richardb1998/MARIEPC/PartsList/ALU.csv

Qty | Value | Device | Package | Parts | Description | DESCRIPTION | HEIGHT | MANUFACTURER_NAME | MANUFACTURER_PART_NUMBER | MOUSER_PART_NUMBER | MOUSER_PRICE-STOCK | POPULARITY | SPICEPREFIX
4 |  | C-US025-024X044 | C025-024X044 | C1, C2, C3, C4 | CAPACITOR, American symbol |  |  |  |  |  |  | 17 | C
16 | 220 | R-US_0204/7 | 0204/7 | R0, R1, R2, R3, R4, R5, R6, R7, R8, R9, R10, R11, R12, R13, R14, R16 | RESISTOR, American symbol |  |  |  |  |  |  | 48 | R
2 | 55959-1630 | 55959-1630 | SHDR16W65P250X200_2X8_1940X140 | ACCUMULATOR_CONNECTOR, MBR_CONNECTOR | Molex MICROCLASP Series, Series Number 55959, 2mm Pitch 16 Way 2 Row Right Angle PCB Header, Solder Termination, 3A | Molex MICROCLASP Series, Series Number 55959, 2mm Pitch 16 Way 2 Row Right Angle PCB Header, Solder Termination, 3A | 11.7mm | Molex | 55959-1630 | 538-55959-1630 | https://www.mouser.com/Search/Refine.aspx?Keyword=538-55959-1630
1 | 55959-2030 | 55959-2030 | 55959-2030_1 | BUS_CONNECTOR | Molex MICROCLASP Series, Series Number 56134, 2mm Pitch 20 Way 2 Row Right Angle PCB Header, Solder Termination, 3A | Molex MICROCLASP Series, Series Number 56134, 2mm Pitch 20 Way 2 Row Right Angle PCB Header, Solder Termination, 3A | mm | Molex | 55959-2030 | 538-55959-2030 | https://www.mouser.com/Search/Refine.aspx?Keyword=538-55959-2030
16 | RED | LED3MM | LED3MM | LED0, LED1, LED2, LED3, LED4, LED5, LED6, LED7, LED8, LED9, LED10, LED11, LED12, LED13, LED14, LED15 | LED |  |  |  |  |  |  | 97
4 | SN74F283N | SN74F283N | DIP254P762X508-16 | ADDER_0-3, ADDER_4-7, ADDER_8-11, ADDER_12-15 | 4 BIT BINARY FULL ADDERS WITH FAST CARRY | 4 BIT BINARY FULL ADDERS WITH FAST CARRY | mm | Texas Instruments | SN74F283N | 595-SN74F283N | https://www.mouser.com/Search/Refine.aspx?Keyword=595-SN74F283N
2 | SN74HC541N | SN74HC541N | DIP794W53P254L2540H508Q20N | BUFFER_0-7, BUFFER_8-15 | Octal Buffers And Line Drivers With 3-State Outputs | Octal Buffers And Line Drivers With 3-State Outputs | 5.08mm | Texas Instruments | SN74HC541N | 595-SN74HC541N | https://www.mouser.com/Search/Refine.aspx?Keyword=595-SN74HC541N
4 | SN74HC86N | SN74HC86N | DIP794W53P254L1930H508Q14N | XOR_0-3, XOR_4-7, XOR_8-11, XOR_12-15 | QUADRUPLE 2-INPUT EXCLUSIVE-OR GATES | QUADRUPLE 2-INPUT EXCLUSIVE-OR GATES | 5.08mm | Texas Instruments | SN74HC86N | 595-SN74HC86N | https://www.mouser.com/Search/Refine.aspx?Keyword=595-SN74HC86N
