richardb1998/MARIEPC/PartsList/billofmats.xlsx

Sheet: Sheet1
Qty | Value | Device | Package | Parts | Description | DESCRIPTION | HEIGHT | MANUFACTURER_NAME | MANUFACTURER_PART_NUMBER | MOUSER_PART_NUMBER | MOUSER_PRICE-STOCK | POPULARITY | SPICEPREFIX
4 |  | C-US025-024X044 | C025-024X044 | C1, C2, C3, C4 | CAPACITOR, American symbol |  |  |  |  |  |  | 17 | C
19 | 220 | R-US_0204/7 | 0204/7 | R0, R1, R2, R3, R4, R5, R6, R7, R8, R9, R10, R11, R12, R13, R14, R15, RSC_000, RSC_400, RSC_800 | RESISTOR, American symbol |  |  |  |  |  |  | 48 | R
1 | 55959-1630 | 55959-1630 | SHDR16W65P250X200_2X8_1940X140 | ALU | Molex MICROCLASP Series, Series Number 55959, 2mm Pitch 16 Way 2 Row Right Angle PCB Header, Solder Termination, 3A | Molex MICROCLASP Series, Series Number 55959, 2mm Pitch 16 Way 2 Row Right Angle PCB Header, Solder Termination, 3A | 11.7mm | Molex | 55959-1630 | 538-55959-1630 | https://www.mouser.com/Search/Refine.aspx?Keyword=538-55959-1630
1 | 55959-2430 | 55959-2430 | 559592430 | BUS | Headers & Wire Housings 24 Ckt R.A. Header | Headers & Wire Housings 24 Ckt R.A. Header | 11.95mm | Molex | 55959-2430 | 538-55959-2430 | https://www.mouser.com/Search/Refine.aspx?Keyword=538-55959-2430
2 | CD4048BE | CD4048BE | DIP254P762X508-16 | ACC=0_0-7, ACC=0_8-15 | CMOS multifunction expandable 8-input gate | CMOS multifunction expandable 8-input gate | mm | Texas Instruments | CD4048BE | 595-CD4048BE | https://www.mouser.com/Search/Refine.aspx?Keyword=595-CD4048BE
16 | RED | LED3MM | LED3MM | LED0, LED1, LED2, LED3, LED4, LED5, LED6, LED7, LED8, LED9, LED10, LED11, LED12, LED13, LED14, LED15 | LED |  |  |  |  |  |  | 97
2 | SN74BCT374N | SN74BCT374N | DIP254P762X508-20 | ACCUMULATOR_0-7, ACCUMULATOR_8-15 | OCTAL EDGE TRIGGERED D TYPE LATCHES | OCTAL EDGE TRIGGERED D TYPE LATCHES | mm | Texas Instruments | SN74BCT374N | 595-SN74BCT374N | https://www.mouser.com/Search/Refine.aspx?Keyword=595-SN74BCT374N
1 | SN74HC04N | SN74HC04N | DIP794W53P254L1930H508Q14N | NOT_GATE | Hex inverter,SN74HC04N DIP14 2.6V 25pcs | Hex inverter,SN74HC04N DIP14 2.6V 25pcs | 5.08mm | Texas Instruments | SN74HC04N | 595-SN74HC04N | https://www.mouser.com/Search/Refine.aspx?Keyword=595-SN74HC04N
1 | SN74HC08N | SN74HC08N | DIP794W53P254L1930H508Q14N | AND_GATE | QUADRUPLE 2-INPUT POSITIVE-NOR GATES | QUADRUPLE 2-INPUT POSITIVE-NOR GATES | 5.08mm | Texas Instruments | SN74HC08N | 595-SN74HC08N | https://www.mouser.com/Search/Refine.aspx?Keyword=595-SN74HC08N
1 | SN74HC11N | SN74HC11N | DIP794W53P254L1930H508Q14N | TRIPLE_AND_GATE | Triple 3-Input AND Gate SN74HC11N | Triple 3-Input AND Gate SN74HC11N | 5.08mm | Texas Instruments | SN74HC11N | 595-SN74HC11N | https://www.mouser.com/Search/Refine.aspx?Keyword=595-SN74HC11N
1 | SN74HC32N | SN74HC32N | DIP794W53P254L1930H508Q14N | OR_GATE | QUADRUPLE 2-INPUT POSITIVE-OR GATES | QUADRUPLE 2-INPUT POSITIVE-OR GATES | 5.08mm | Texas Instruments | SN74HC32N | 595-SN74HC32N | https://www.mouser.com/Search/Refine.aspx?Keyword=595-SN74HC32N
3 | SN74HC541N | SN74HC541N | DIP794W53P254L2540H508Q20N | ACO_0-7, ACO_8-15, SKIPCOND | Octal Buffers And Line Drivers With 3-State Outputs | Octal Buffers And Line Drivers With 3-State Outputs | 5.08mm | Texas Instruments | SN74HC541N | 595-SN74HC541N | https://www.mouser.com/Search/Refine.aspx?Keyword=595-SN74HC541N
3 | YELLOW | LED3MM | LED3MM | SC_000, SC_400, SC_800 | LED |  |  |  |  |  |  | 97
4 |  | C-US025-024X044 | C025-024X044 | C1, C2, C3, C4 | CAPACITOR, American symbol |  |  |  |  |  |  | 17 | C
16 | 220 | R-US_0204/7 | 0204/7 | R0, R1, R2, R3, R4, R5, R6, R7, R8, R9, R10, R11, R12, R13, R14, R16 | RESISTOR, American symbol |  |  |  |  |  |  | 48 | R
2 | 55959-1630 | 55959-1630 | SHDR16W65P250X200_2X8_1940X140 | ACCUMULATOR_CONNECTOR, MBR_CONNECTOR | Molex MICROCLASP Series, Series Number 55959, 2mm Pitch 16 Way 2 Row Right Angle PCB Header, Solder Termination, 3A | Molex MICROCLASP Series, Series Number 55959, 2mm Pitch 16 Way 2 Row Right Angle PCB Header, Solder Termination, 3A | 11.7mm | Molex | 55959-1630 | 538-55959-1630 | https://www.mouser.com/Search/Refine.aspx?Keyword=538-55959-1630
1 | 55959-2030 | 55959-2030 | 55959-2030_1 | BUS_CONNECTOR | Molex MICROCLASP Series, Series Number 56134, 2mm Pitch 20 Way 2 Row Right Angle PCB Header, Solder Termination, 3A | Molex MICROCLASP Series, Series Number 56134, 2mm Pitch 20 Way 2 Row Right Angle PCB Header, Solder Termination, 3A | mm | Molex | 55959-2030 | 538-55959-2030 | https://www.mouser.com/Search/Refine.aspx?Keyword=538-55959-2030
16 | RED | LED3MM | LED3MM | LED0, LED1, LED2, LED3, LED4, LED5, LED6, LED7, LED8, LED9, LED10, LED11, LED12, LED13, LED14, LED15 | LED |  |  |  |  |  |  | 97
4 | SN74F283N | SN74F283N | DIP254P762X508-16 | ADDER_0-3, ADDER_4-7, ADDER_8-11, ADDER_12-15 | 4 BIT BINARY FULL ADDERS WITH FAST CARRY | 4 BIT BINARY FULL ADDERS WITH FAST CARRY | mm | Texas Instruments | SN74F283N | 595-SN74F283N | https://www.mouser.com/Search/Refine.aspx?Keyword=595-SN74F283N
2 | SN74HC541N | SN74HC541N | DIP794W53P254L2540H508Q20N | BUFFER_0-7, BUFFER_8-15 | Octal Buffers And Line Drivers With 3-State Outputs | Octal Buffers And Line Drivers With 3-State Outputs | 5.08mm | Texas Instruments | SN74HC541N | 595-SN74HC541N | https://www.mouser.com/Search/Refine.aspx?Keyword=595-SN74HC541N
4 | SN74HC86N | SN74HC86N | DIP794W53P254L1930H508Q14N | XOR_0-3, XOR_4-7, XOR_8-11, XOR_12-15 | QUADRUPLE 2-INPUT EXCLUSIVE-OR GATES | QUADRUPLE 2-INPUT EXCLUSIVE-OR GATES | 5.08mm | Texas Instruments | SN74HC86N | 595-SN74HC86N | https://www.mouser.com/Search/Refine.aspx?Keyword=595-SN74HC86N
16 | 10k | R-US_0204/7 | 0204/7 | PD0, PD1, PD2, PD3, PD4, PD5, PD6, PD7, PD8, PD9, PD10, PD11, PD12, PD13, PD14, PD15 | RESISTOR, American symbol |  |  |  |  |  |  | 48 |  | R
1 | 1N4148DO35-7 | 1N4148DO35-7 | DO35-7 | FLYBACK_DIODE | DIODE |  |  |  |  |  |  | 58
1 | 207479-0002 | 207479-0002 | 2074790002 | POWER | MOLEX - 207479-0002 - L1NK 396 SHROUDED HEADER ASSEMBLY-1X2 98AC8497 | MOLEX - 207479-0002 - L1NK 396 SHROUDED HEADER ASSEMBLY-1X2 98AC8497 | 14.1mm | Molex | 207479-0002 | 538-207479-0002 | https://www.mouser.com/Search/Refine.aspx?Keyword=538-207479-0002
16 | 220 | R-US_0204/7 | 0204/7 | R0, R1, R2, R3, R4, R5, R6, R7, R8, R9, R10, R11, R12, R13, R14, R15 | RESISTOR, American symbol |  |  |  |  |  |  | 48 |  | R
1 | 55959-0830 | 55959-0830 | SHDR8W65P250X200_2X4_1140X1400 | CLOCK | Headers & Wire Housings 8 Ckt R.A. Header | Headers & Wire Housings 8 Ckt R.A. Header | 11.95mm | Molex | 55959-0830 | 538-55959-0830 | https://www.mouser.com/Search/Refine.aspx?Keyword=538-55959-0830
1 | 55959-1830 | 55959-1830 | SHDR18W65P250X200_2X9_2140X140 | MAR | Molex MICROCLASP Series, Series Number 55959, 2mm Pitch 18 Way 2 Row Right Angle PCB Header, Solder Termination, 3A | Molex MICROCLASP Series, Series Number 55959, 2mm Pitch 18 Way 2 Row Right Angle PCB Header, Solder Termination, 3A | 11.7mm | Molex | 55959-1830 | 538-55959-1830 | https://www.mouser.com/Search/Refine.aspx?Keyword=538-55959-1830
2 | 55959-2030 | 55959-2030 | 55959-2030_1 | ALU, IR | Molex MICROCLASP Series, Series Number 56134, 2mm Pitch 20 Way 2 Row Right Angle PCB Header, Solder Termination, 3A | Molex MICROCLASP Series, Series Number 56134, 2mm Pitch 20 Way 2 Row Right Angle PCB Header, Solder Termination, 3A | mm | Molex | 55959-2030 | 538-55959-2030 | https://www.mouser.com/Search/Refine.aspx?Keyword=538-55959-2030
6 | 55959-2430 | 55959-2430 | 559592430 | ACCUMULATOR, IO, IR_CONTROL, MBR, MEMORY, PROGRAM_COUNTER | Headers & Wire Housings 24 Ckt R.A. Header | Headers & Wire Housings 24 Ckt R.A. Header | 11.95mm | Molex | 55959-2430 | 538-55959-2430 | https://www.mouser.com/Search/Refine.aspx?Keyword=538-55959-2430
1 | MHPS2273N | MHPS2273N | MHPS2273N | RESET | Pushbutton Switches Momentary key DP | Pushbutton Switches Momentary key DP | 13.5mm | Apem | MHPS2273N | 642-MHPS2273N | https://www.mouser.com/Search/Refine.aspx?Keyword=642-MHPS2273N
16 | RED | LED3MM | LED3MM | LED0, LED1, LED2, LED3, LED4, LED5, LED6, LED7, LED8, LED9, LED10, LED11, LED12, LED13, LED14, LED15 | LED |  |  |  |  |  |  | 97
1 | SN74HC32N | SN74HC32N | DIP794W53P254L1930H508Q14N | OR_GATE | QUADRUPLE 2-INPUT POSITIVE-OR GATES | QUADRUPLE 2-INPUT POSITIVE-OR GATES | 5.08mm | Texas Instruments | SN74HC32N | 595-SN74HC32N | https://www.mouser.com/Search/Refine.aspx?Keyword=595-SN74HC32N
1 | SRD-05VDC-SL-C | SRD-05VDC-SL-C | SRD | RST_RELAY | Relay | Relay | mm | Songle Relay | SRD-05VDC-SL-C
2 |  | C-US025-024X044 | C025-024X044 | C8, C9 | CAPACITOR, American symbol |  |  |  |  |  |  | 17 | C
3 | 0.01uf | C-US025-024X044 | C025-024X044 | C3, C4, C5 | CAPACITOR, American symbol |  |  |  |  |  |  | 17 | C
3 | 0.1uf | C-US025-024X044 | C025-024X044 | C1, C2, C6 | CAPACITOR, American symbol |  |  |  |  |  |  | 17 | C
1 | 1M | R-US_0204/7 | 0204/7 | R6 | RESISTOR, American symbol |  |  |  |  |  |  | 48 | R
4 | 1k | R-US_0204/7 | 0204/7 | R1, R3, R4, R5 | RESISTOR, American symbol |  |  |  |  |  |  | 48 | R
1 | 1uf | CPOL-USE5-5 | E5-5 | C7 | POLARIZED CAPACITOR, American symbol |  |  |  |  |  |  | 5 | C
1 | 220 | R-US_0204/7 | 0204/7 | RCLK | RESISTOR, American symbol |  |  |  |  |  |  | 48 | R
1 | 55959-0830 | 55959-0830 | SHDR8W65P250X200_2X4_1140X1400 | BUS | Headers & Wire Housings 8 Ckt R.A. Header | Headers & Wire Housings 8 Ckt R.A. Header | 11.95mm | Molex | 55959-0830 | 538-55959-0830 | https://www.mouser.com/Search/Refine.aspx?Keyword=538-55959-0830
1 | BLUE | LED3MM | LED3MM | LEDCLK | LED |  |  |  |  |  |  | 97
3 | LMC555CN_NOPB | LMC555CN_NOPB | DIP794W53P254L959H508Q8N | 555_RUN, 555_SEL, 555_STEP | Worlds smallest 555 timer with low power, high accuracy and a Fmax of 3MHz | Worlds smallest 555 timer with low power, high accuracy and a Fmax of 3MHz | 5.08mm | Texas Instruments | LMC555CN/NOPB | 926-LMC555CN/NOPB | https://www.mouser.com/Search/Refine.aspx?Keyword=926-LMC555CN%2FNOPB
1 | MHPS2273N | MHPS2273N | MHPS2273N | STEP | Pushbutton Switches Momentary key DP | Pushbutton Switches Momentary key DP | 13.5mm | Apem | MHPS2273N | 642-MHPS2273N | https://www.mouser.com/Search/Refine.aspx?Keyword=642-MHPS2273N
1 | MHPS2285 | MHPS2285 | MHPS2285 | RUN/STEP | Pushbutton Switches 8mmDPDT PUSH PUSH | Pushbutton Switches 8mmDPDT PUSH PUSH | 13.5mm | Apem | MHPS2285 | 642-MHPS2285 | https://www.mouser.com/Search/Refine.aspx?Keyword=642-MHPS2285
1 | PDB12-M4251-105BF | PDB12-M4251-105BF | PDB12M4251105BF | POTENTIOMETER | Potentiometers 1M LINEAR 12MM | Potentiometers 1M LINEAR 12MM | 15mm | Bourns | PDB12-M4251-105BF | 652-PDB12-M4251105BF | https://www.mouser.com/Search/Refine.aspx?Keyword=652-PDB12-M4251105BF
1 | SN74HC04N | SN74HC04N | DIP794W53P254L1930H508Q14N | NOT_GATE | Hex inverter,SN74HC04N DIP14 2.6V 25pcs | Hex inverter,SN74HC04N DIP14 2.6V 25pcs | 5.08mm | Texas Instruments | SN74HC04N | 595-SN74HC04N | https://www.mouser.com/Search/Refine.aspx?Keyword=595-SN74HC04N
1 | SN74HC08N | SN74HC08N | DIP794W53P254L1930H508Q14N | AND_GATE | QUADRUPLE 2-INPUT POSITIVE-NOR GATES | QUADRUPLE 2-INPUT POSITIVE-NOR GATES | 5.08mm | Texas Instruments | SN74HC08N | 595-SN74HC08N | https://www.mouser.com/Search/Refine.aspx?Keyword=595-SN74HC08N
1 | SN74HC32N | SN74HC32N | DIP794W53P254L1930H508Q14N | OR_GATE | QUADRUPLE 2-INPUT POSITIVE-OR GATES | QUADRUPLE 2-INPUT POSITIVE-OR GATES | 5.08mm | Texas Instruments | SN74HC32N | 595-SN74HC32N | https://www.mouser.com/Search/Refine.aspx?Keyword=595-SN74HC32N
4 |  | C-US025-024X044 | C025-024X044 | C1, C2, C3, C4 | CAPACITOR, American symbol |  |  |  |  |  |  | 17 |  | C
36 | 220 | R-US_0204/7 | 0204/7 | R0, R1, R2, R3, R4, R5, R6, R7, R8, R9, R10, R11, R12, R13, R14, R15, RACI, RACO, RALUO, RCE, RCO, RHLT, RINPUT, RIRI, RIRO, RJMP, RMARI, RMBRI, RMBRO, RMCR, ROI, RONE, RRI, RRO, RSC, RSU | RESISTOR, American symbol |  |  |  |  |  |  | 48 |  | R
1 | 55959-2030 | 55959-2030 | 55959-2030_1 | BUS | Molex MICROCLASP Series, Series Number 56134, 2mm Pitch 20 Way 2 Row Right Angle PCB Header, Solder Termination, 3A | Molex MICROCLASP Series, Series Number 56134, 2mm Pitch 20 Way 2 Row Right Angle PCB Header, Solder Termination, 3A | mm | Molex | 55959-2030 | 538-55959-2030 | https://www.mouser.com/Search/Refine.aspx?Keyword=538-55959-2030
1 | 55959-2430 | 55959-2430 | 559592430 | CONTROL_LOGIC | Headers & Wire Housings 24 Ckt R.A. Header | Headers & Wire Housings 24 Ckt R.A. Header | 11.95mm | Molex | 55959-2430 | 538-55959-2430 | https://www.mouser.com/Search/Refine.aspx?Keyword=538-55959-2430
24 | BLUE | LED3MM | LED3MM | LED12, LED13, LED14, LED15, LEDACI, LEDACO, LEDALUO, LEDCE, LEDCO, LEDHLT, LEDINPUT, LEDIRI, LEDIRO, LEDJMP, LEDMARI, LEDMBRI, LEDMBRO, LEDMCR, LEDOI, LEDONE, LEDRI, LEDRO, LEDSC, LEDSU | LED |  |  |  |  |  |  | 97
3 | CAT28C16ALI-20 | CAT28C16ALI-20 | DIP1651W55P254L3188H635Q24N | CONTROL_LOGIC_0-7, CONTROL_LOGIC_8-15, CONTROL_LOGIC_16-23 | 16 kb CMOS Parallel EEPROM | 16 kb CMOS Parallel EEPROM | 6.35mm | ON Semiconductor | CAT28C16ALI-20
2 | SN74BCT374N | SN74BCT374N | DIP254P762X508-20 | IR_0-7, IR_8-15 | OCTAL EDGE TRIGGERED D TYPE LATCHES | OCTAL EDGE TRIGGERED D TYPE LATCHES | mm | Texas Instruments | SN74BCT374N | 595-SN74BCT374N | https://www.mouser.com/Search/Refine.aspx?Keyword=595-SN74BCT374N
2 | SN74HC04N | SN74HC04N | DIP794W53P254L1930H508Q14N | NOT_GATE_1, NOT_GATE_2 | Hex inverter,SN74HC04N DIP14 2.6V 25pcs | Hex inverter,SN74HC04N DIP14 2.6V 25pcs | 5.08mm | Texas Instruments | SN74HC04N | 595-SN74HC04N | https://www.mouser.com/Search/Refine.aspx?Keyword=595-SN74HC04N
1 | SN74HC08N | SN74HC08N | DIP794W53P254L1930H508Q14N | CLOCK_GATE | QUADRUPLE 2-INPUT POSITIVE-NOR GATES | QUADRUPLE 2-INPUT POSITIVE-NOR GATES | 5.08mm | Texas Instruments | SN74HC08N | 595-SN74HC08N | https://www.mouser.com/Search/Refine.aspx?Keyword=595-SN74HC08N
1 | SN74HC161N | SN74HC161N | DIP794W53P254L1930H508Q16N | MICROCODE_COUNTER | SYNCHRONOUS 4-BIT BINARY COUNTERS | SYNCHRONOUS 4-BIT BINARY COUNTERS | 5.08mm | Texas Instruments | SN74HC161N | 595-SN74HC161N | https://www.mouser.com/Search/Refine.aspx?Keyword=595-SN74HC161N
4 | SN74HC541N | SN74HC541N | DIP794W53P254L2540H508Q20N | IR_OUT_0-7, IR_OUT_8-15, ONE_0-7, ONE_8-15 | Octal Buffers And Line Drivers With 3-State Outputs | Octal Buffers And Line Drivers With 3-State Outputs | 5.08mm | Texas Instruments | SN74HC541N | 595-SN74HC541N | https://www.mouser.com/Search/Refine.aspx?Keyword=595-SN74HC541N
12 | YELLOW | LED3MM | LED3MM | LED0, LED1, LED2, LED3, LED4, LED5, LED6, LED7, LED8, LED9, LED10, LED11 | LED |  |  |  |  |  |  | 97
4 |  | C-US025-024X044 | C025-024X044 | C1, C2, C3, C4 | CAPACITOR, American symbol |  |  |  |  |  |  | 17 | C
1 | 1825360-3 | 1825360-3 | DIP813W61P254L1209H351Q8N | DIP_8-11 | DIP switch,PCB,SPST,4 pos,extended slide | DIP switch,PCB,SPST,4 pos,extended slide | 3.51mm | TE Connectivity | 1825360-3 | 506-1825360-3 | https://www.mouser.com/Search/Refine.aspx?Keyword=506-1825360-3
14 | 220 | R-US_0204/7 | 0204/7 | R0, R1, R2, R3, R4, R5, R6, R7, R8, R9, R10, R11, RPRGM, RRUN | RESISTOR, American symbol |  |  |  |  |  |  | 48 | R
2 | 55959-1430 | 55959-1430 | 559591430 | ARDUINO, MAIN_MEMORY | Molex MICROCLASP 55959, 2mm Pitch, 14 Way, 2 Row, Right Angle PCB Header, Through Hole | Molex MICROCLASP 55959, 2mm Pitch, 14 Way, 2 Row, Right Angle PCB Header, Through Hole | 11.7mm | Molex | 55959-1430 | 538-55959-1430 | https://www.mouser.com/Search/Refine.aspx?Keyword=538-55959-1430
1 | 55959-1830 | 55959-1830 | SHDR18W65P250X200_2X9_2140X140 | BUS | Molex MICROCLASP Series, Series Number 55959, 2mm Pitch 18 Way 2 Row Right Angle PCB Header, Solder Termination, 3A | Molex MICROCLASP Series, Series Number 55959, 2mm Pitch 18 Way 2 Row Right Angle PCB Header, Solder Termination, 3A | 11.7mm | Molex | 55959-1830 | 538-55959-1830 | https://www.mouser.com/Search/Refine.aspx?Keyword=538-55959-1830
1 | ADE08A04 | ADE08A04 | DIP810W60P254L2225H590Q16N | DIP_0-7 | 8 Way Through Hole DIP Switch SPST, Extended Slide Actuator | 8 Way Through Hole DIP Switch SPST, Extended Slide Actuator | 5.9mm | TE Connectivity | ADE08A04 | 506-ADE08A04 | https://www.mouser.com/Search/Refine.aspx?Keyword=506-ADE08A04
1 | GREEN | LED3MM | LED3MM | LEDRUN | LED |  |  |  |  |  |  | 97
1 | MHPS2285 | MHPS2285 | MHPS2285 | PRGM_SWITCH | Pushbutton Switches 8mmDPDT PUSH PUSH | Pushbutton Switches 8mmDPDT PUSH PUSH | 13.5mm | Apem | MHPS2285 | 642-MHPS2285 | https://www.mouser.com/Search/Refine.aspx?Keyword=642-MHPS2285
1 | RED | LED3MM | LED3MM | LEDPRGM | LED |  |  |  |  |  |  | 97
2 | SN74BCT374N | SN74BCT374N | DIP254P762X508-20 | MAR_0-7, MAR_8-11 | OCTAL EDGE TRIGGERED D TYPE LATCHES | OCTAL EDGE TRIGGERED D TYPE LATCHES | mm | Texas Instruments | SN74BCT374N | 595-SN74BCT374N | https://www.mouser.com/Search/Refine.aspx?Keyword=595-SN74BCT374N
1 | SN74HC08N | SN74HC08N | DIP794W53P254L1930H508Q14N | AND_GATE | QUADRUPLE 2-INPUT POSITIVE-NOR GATES | QUADRUPLE 2-INPUT POSITIVE-NOR GATES | 5.08mm | Texas Instruments | SN74HC08N | 595-SN74HC08N | https://www.mouser.com/Search/Refine.aspx?Keyword=595-SN74HC08N
6 | SN74HC157N | SN74HC157N | DIP794W53P254L1930H508Q16N | BRD/ARD_0-3, BRD/ARD_4-7, BRD/ARD_8-11, BUS/PRGM_0-3, BUS/PRGM_4-7, BUS/PRGM_8-11 | Quadruple 2-Line To 1-Line Data Selectors/Multiplexers | Quadruple 2-Line To 1-Line Data Selectors/Multiplexers | 5.08mm | Texas Instruments | SN74HC157N | 595-SN74HC157N | https://www.mouser.com/Search/Refine.aspx?Keyword=595-SN74HC157N
12 | YELLOW | LED3MM | LED3MM | LED0, LED1, LED2, LED3, LED4, LED5, LED6, LED7, LED8, LED9, LED10, LED11 | LED |  |  |  |  |  |  | 97
4 |  | C-US025-024X044 | C025-024X044 | C1, C2, C3, C4 | CAPACITOR, American symbol |  |  |  |  |  |  | 17 | C
16 | 220 | R-US_0204/7 | 0204/7 | R0, R1, R2, R3, R4, R5, R6, R7, R8, R9, R10, R11, R12, R13, R14, R15 | RESISTOR, American symbol |  |  |  |  |  |  | 48 | R
1 | 55959-1630 | 55959-1630 | SHDR16W65P250X200_2X8_1940X140 | ALU_CONNECTOR | Molex MICROCLASP Series, Series Number 55959, 2mm Pitch 16 Way 2 Row Right Angle PCB Header, Solder Termination, 3A | Molex MICROCLASP Series, Series Number 55959, 2mm Pitch 16 Way 2 Row Right Angle PCB Header, Solder Termination, 3A | 11.7mm | Molex | 55959-1630 | 538-55959-1630 | https://www.mouser.com/Search/Refine.aspx?Keyword=538-55959-1630
1 | 55959-2430 | 55959-2430 | 559592430 | BOARD_CONNECTOR | Headers & Wire Housings 24 Ckt R.A. Header | Headers & Wire Housings 24 Ckt R.A. Header | 11.95mm | Molex | 55959-2430 | 538-55959-2430 | https://www.mouser.com/Search/Refine.aspx?Keyword=538-55959-2430
16 | RED | LED3MM | LED3MM | LED0, LED1, LED2, LED3, LED4, LED5, LED6, LED7, LED8, LED9, LED10, LED11, LED12, LED13, LED14, LED15 | LED |  |  |  |  |  |  | 97
2 | SN74BCT374N | SN74BCT374N | DIP254P762X508-20 | REGISTER_0-7, REGISTER_8-15 | OCTAL EDGE TRIGGERED D TYPE LATCHES | OCTAL EDGE TRIGGERED D TYPE LATCHES | mm | Texas Instruments | SN74BCT374N | 595-SN74BCT374N | https://www.mouser.com/Search/Refine.aspx?Keyword=595-SN74BCT374N
1 | SN74HC08N | SN74HC08N | DIP794W53P254L1930H508Q14N | CLOCK_GATE | QUADRUPLE 2-INPUT POSITIVE-NOR GATES | QUADRUPLE 2-INPUT POSITIVE-NOR GATES | 5.08mm | Texas Instruments | SN74HC08N | 595-SN74HC08N | https://www.mouser.com/Search/Refine.aspx?Keyword=595-SN74HC08N
2 | SN74HC541N | SN74HC541N | DIP794W53P254L2540H508Q20N | OUTPUT_0-7, OUTPUT_8-15 | Octal Buffers And Line Drivers With 3-State Outputs | Octal Buffers And Line Drivers With 3-State Outputs | 5.08mm | Texas Instruments | SN74HC541N | 595-SN74HC541N | https://www.mouser.com/Search/Refine.aspx?Keyword=595-SN74HC541N
4 |  | C-US025-024X044 | C025-024X044 | C1, C2, C3, C4 | CAPACITOR, American symbol |  |  |  |  |  |  | 17 | C
16 | 220 | R-US_0204/7 | 0204/7 | R0, R1, R2, R3, R4, R5, R6, R7, R8, R9, R10, R11, R12, R13, R14, R15 | RESISTOR, American symbol |  |  |  |  |  |  | 48 | R
1 | 55959-1430 | 55959-1430 | 559591430 | MAR | Molex MICROCLASP 55959, 2mm Pitch, 14 Way, 2 Row, Right Angle PCB Header, Through Hole | Molex MICROCLASP 55959, 2mm Pitch, 14 Way, 2 Row, Right Angle PCB Header, Through Hole | 11.7mm | Molex | 55959-1430 | 538-55959-1430 | https://www.mouser.com/Search/Refine.aspx?Keyword=538-55959-1430
1 | 55959-1830 | 55959-1830 | SHDR18W65P250X200_2X9_2140X140 | ARDUINO | Molex MICROCLASP Series, Series Number 55959, 2mm Pitch 18 Way 2 Row Right Angle PCB Header, Solder Termination, 3A | Molex MICROCLASP Series, Series Number 55959, 2mm Pitch 18 Way 2 Row Right Angle PCB Header, Solder Termination, 3A | 11.7mm | Molex | 55959-1830 | 538-55959-1830 | https://www.mouser.com/Search/Refine.aspx?Keyword=538-55959-1830
1 | 55959-2430 | 55959-2430 | 559592430 | BUS | Headers & Wire Housings 24 Ckt R.A. Header | Headers & Wire Housings 24 Ckt R.A. Header | 11.95mm | Molex | 55959-2430 | 538-55959-2430 | https://www.mouser.com/Search/Refine.aspx?Keyword=538-55959-2430
2 | ADE08A04 | ADE08A04 | DIP810W60P254L2225H590Q16N | DIP_0-7, DIP_8-15 | 8 Way Through Hole DIP Switch SPST, Extended Slide Actuator | 8 Way Through Hole DIP Switch SPST, Extended Slide Actuator | 5.9mm | TE Connectivity | ADE08A04 | 506-ADE08A04 | https://www.mouser.com/Search/Refine.aspx?Keyword=506-ADE08A04
2 | AS6C6264-55PIN | AS6C6264-55PIN | DIP1524W51P254L3632H394Q28N | MEMORY_0-7, MEMORY_8-15 | SRAM 64K, 2.7-5.5V, 55ns 8K x 8 CMOS SRAM | SRAM 64K, 2.7-5.5V, 55ns 8K x 8 CMOS SRAM | 3.937mm | Alliance Memory | AS6C6264-55PIN | 913-AS6C6264-55PIN | https://www.mouser.com/Search/Refine.aspx?Keyword=913-AS6C6264-55PIN
1 | MHPS2273N | MHPS2273N | MHPS2273N | S1 | Pushbutton Switches Momentary key DP | Pushbutton Switches Momentary key DP | 13.5mm | Apem | MHPS2273N | 642-MHPS2273N | https://www.mouser.com/Search/Refine.aspx?Keyword=642-MHPS2273N
16 | RED | LED3MM | LED3MM | LED0, LED1, LED2, LED3, LED4, LED5, LED6, LED7, LED8, LED9, LED10, LED11, LED12, LED13, LED14, LED15 | LED |  |  |  |  |  |  | 97
1 | SN74HC08N | SN74HC08N | DIP794W53P254L1930H508Q14N | AND_GATE | QUADRUPLE 2-INPUT POSITIVE-NOR GATES | QUADRUPLE 2-INPUT POSITIVE-NOR GATES | 5.08mm | Texas Instruments | SN74HC08N | 595-SN74HC08N | https://www.mouser.com/Search/Refine.aspx?Keyword=595-SN74HC08N
10 | SN74HC157N | SN74HC157N | DIP794W53P254L1930H508Q16N | ARD/BRD_0-3, ARD/BRD_4-7, ARD/BRD_8-11, ARD/BRD_12-15, ARDUINO_WRITE, BOARD_WRITE, BUS/DIP_0-3, BUS/DIP_4-7, BUS/DIP_8-11, BUS/DIP_12-15 | Quadruple 2-Line To 1-Line Data Selectors/Multiplexers | Quadruple 2-Line To 1-Line Data Selectors/Multiplexers | 5.08mm | Texas Instruments | SN74HC157N | 595-SN74HC157N | https://www.mouser.com/Search/Refine.aspx?Keyword=595-SN74HC157N
2 | SN74HC541N | SN74HC541N | DIP794W53P254L2540H508Q20N | RAM_OUT_0-7, RAM_OUT_8-15 | Octal Buffers And Line Drivers With 3-State Outputs | Octal Buffers And Line Drivers With 3-State Outputs | 5.08mm | Texas Instruments | SN74HC541N | 595-SN74HC541N | https://www.mouser.com/Search/Refine.aspx?Keyword=595-SN74HC541N
4 |  | C-US025-024X044 | C025-024X044 | C1, C2, C3, C4 | CAPACITOR, American symbol |  |  |  |  |  |  | 17 | C
12 | 220 | R-US_0204/7 | 0204/7 | R0, R1, R2, R3, R4, R5, R6, R7, R8, R9, R10, R11 | RESISTOR, American symbol |  |  |  |  |  |  | 48 | R
1 | 55959-2430 | 55959-2430 | 559592430 | BUS | Headers & Wire Housings 24 Ckt R.A. Header | Headers & Wire Housings 24 Ckt R.A. Header | 11.95mm | Molex | 55959-2430 | 538-55959-2430 | https://www.mouser.com/Search/Refine.aspx?Keyword=538-55959-2430
3 | SN74HC161N | SN74HC161N | DIP794W53P254L1930H508Q16N | PC_0-3, PC_4-7, PC_8-11 | SYNCHRONOUS 4-BIT BINARY COUNTERS | SYNCHRONOUS 4-BIT BINARY COUNTERS | 5.08mm | Texas Instruments | SN74HC161N | 595-SN74HC161N | https://www.mouser.com/Search/Refine.aspx?Keyword=595-SN74HC161N
2 | SN74HC541N | SN74HC541N | DIP794W53P254L2540H508Q20N | BUFFER_0-8, BUFFER_8-11 | Octal Buffers And Line Drivers With 3-State Outputs | Octal Buffers And Line Drivers With 3-State Outputs | 5.08mm | Texas Instruments | SN74HC541N | 595-SN74HC541N | https://www.mouser.com/Search/Refine.aspx?Keyword=595-SN74HC541N
12 | YELLOW | LED3MM | LED3MM | LED0, LED1, LED2, LED3, LED4, LED5, LED6, LED7, LED8, LED9, LED10, LED11 | LED |  |  |  |  |  |  | 97

Sheet: Sheet2
Device | Value | Total
C-US025-024X044 |  | 30
R-US_0204/7 | 220 | 146
55959-1630 | 55959-1630 | 4
55959-2430 | 55959-2430 | 11
CD4048BE | CD4048BE | 2
LED3MM | RED | 81
SN74BCT374N | SN74BCT374N | 8
SN74HC04N | SN74HC04N | 4
SN74HC08N | SN74HC08N | 6
SN74HC11N | SN74HC11N | 1
SN74HC32N | SN74HC32N | 3
SN74HC541N | SN74HC541N | 15
LED3MM | YELLOW | 39
55959-2030 | 55959-2030 | 4
SN74F283N | SN74F283N | 4
SN74HC86N | SN74HC86N | 4
R-US_0204/7 | 10k | 16
1N4148DO35-7 | 1N4148DO35-7 | 1
207479-0002 | 207479-0002 | 1
55959-0830 | 55959-0830 | 2
55959-1830 | 55959-1830 | 3
MHPS2273N | MHPS2273N | 3
SRD-05VDC-SL-C | SRD-05VDC-SL-C | 1
C-US025-024X044 | 0.01uf | 3
C-US025-024X044 | 0.1uf | 3
R-US_0204/7 | 1M | 1
R-US_0204/7 | 1k | 4
CPOL-USE5-5 | 1uf | 1
LED3MM | BLUE | 25
LMC555CN_NOPB | LMC555CN_NOPB | 3
MHPS2285 | MHPS2285 | 2
PDB12-M4251-105BF | PDB12-M4251-105BF | 1
CAT28C16ALI-20 | CAT28C16ALI-20 | 3
SN74HC161N | SN74HC161N | 4
1825360-3 | 1825360-3 | 1
55959-1430 | 55959-1430 | 3
ADE08A04 | ADE08A04 | 3
LED3MM | GREEN | 1
SN74HC157N | SN74HC157N | 16
AS6C6264-55PIN | AS6C6264-55PIN | 2
