richardb1998/MARIEPC/(list of files, drawings)

Other design files:
logisim/marie.circ
