richardb1998/MARIEPC/Eagle/Clock/clock.brd

## EAGLE design Eagle/Clock/clock.brd (2020-06-12)

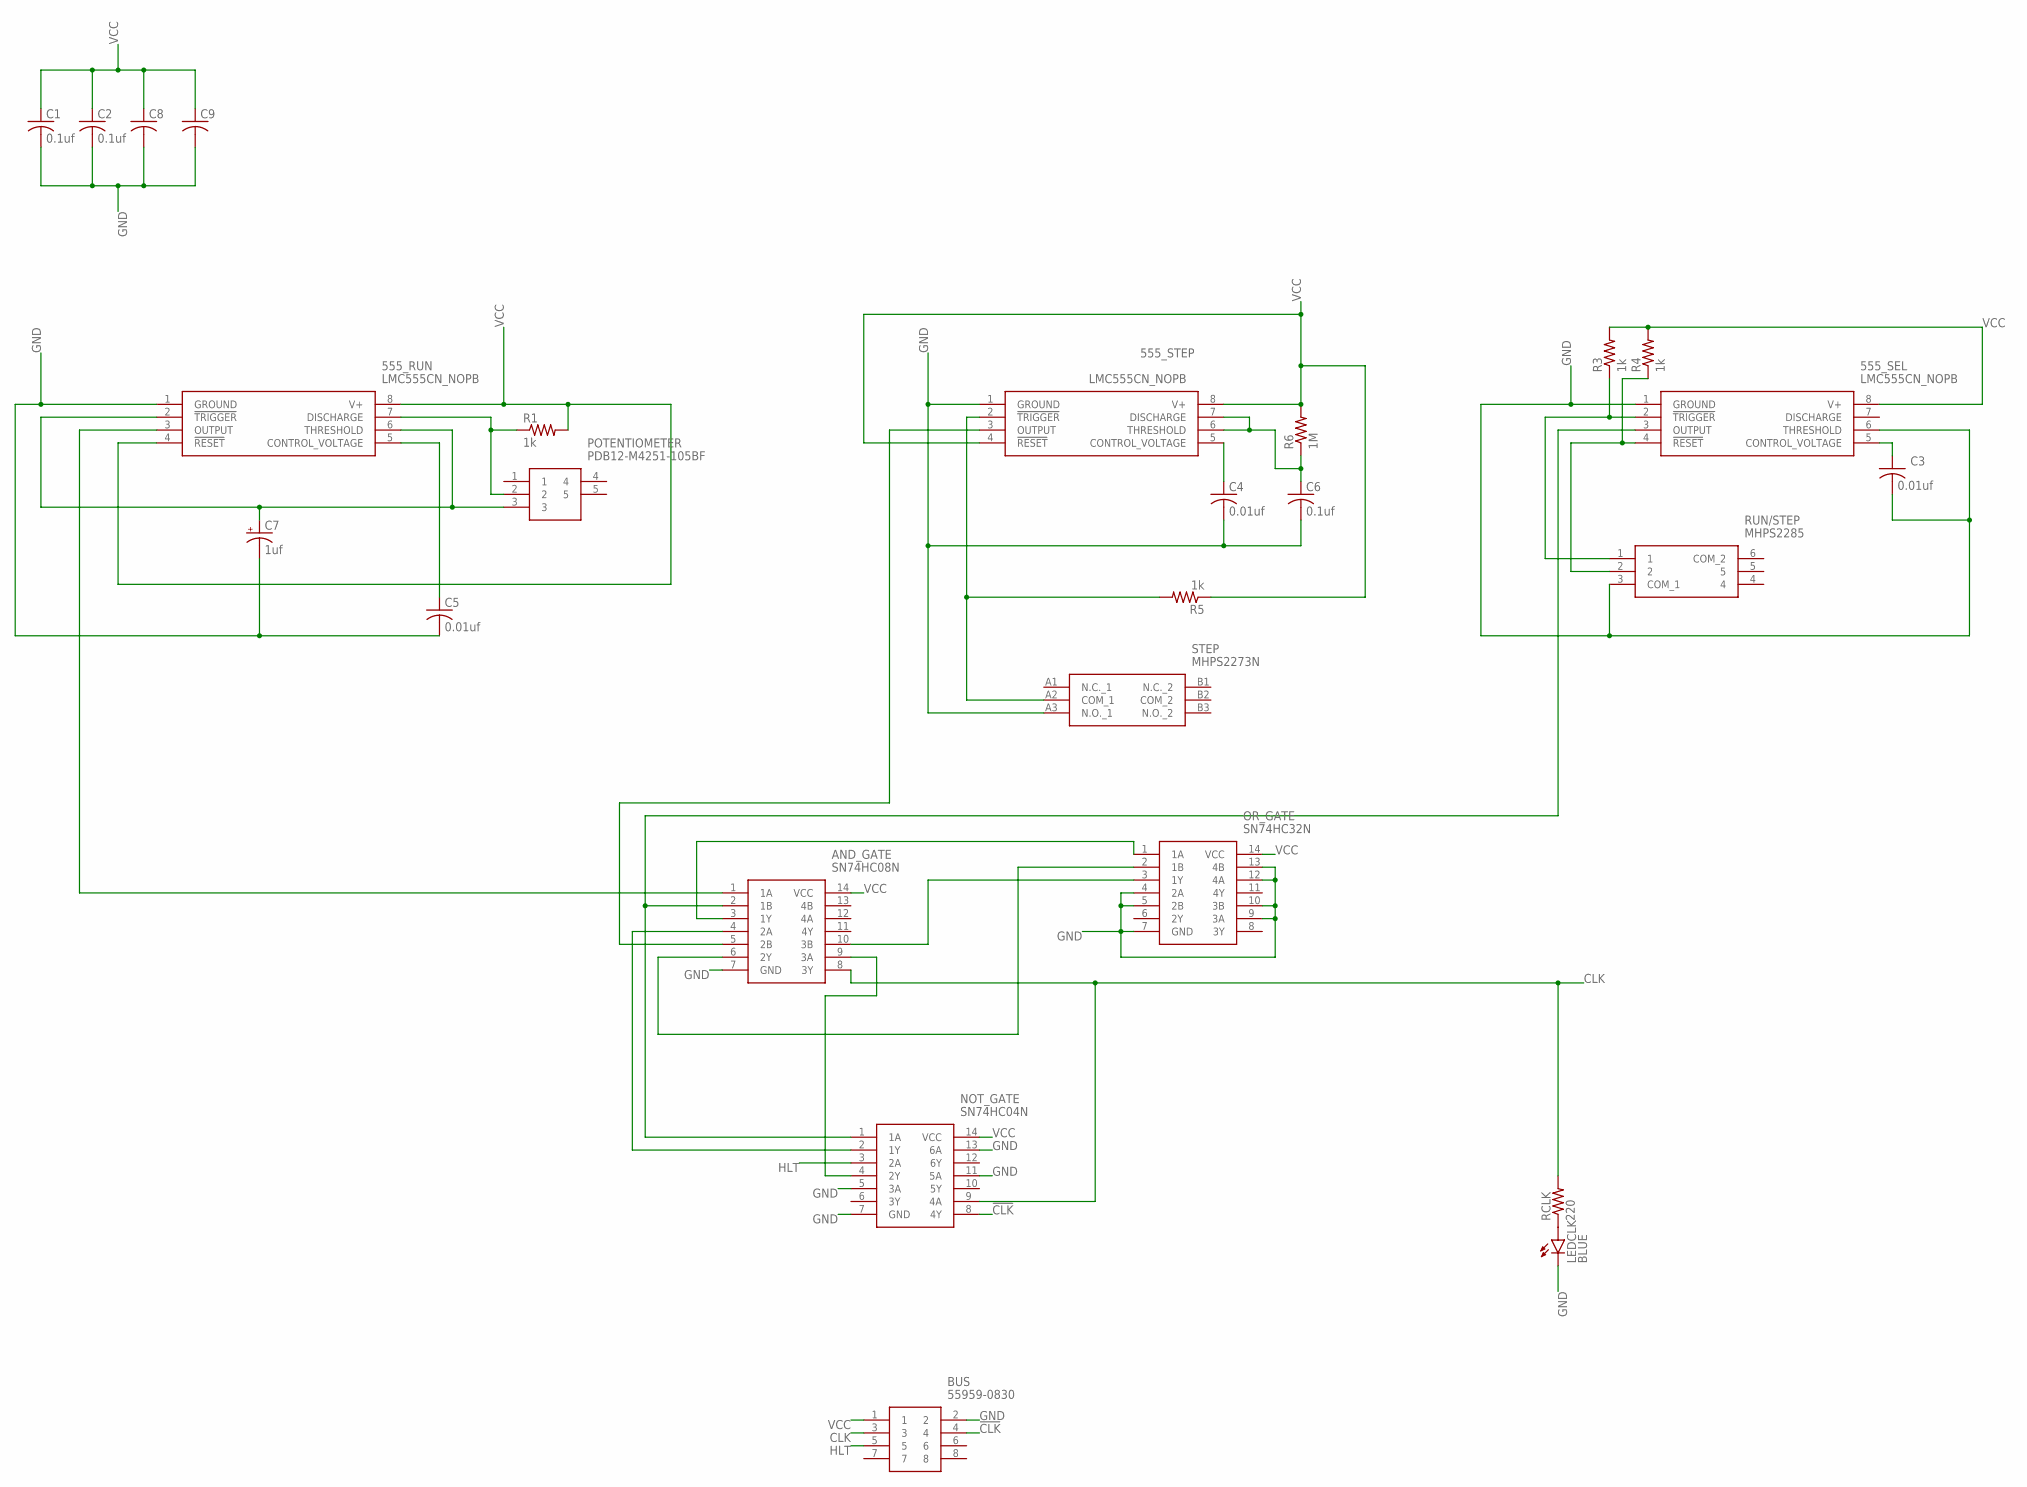
[picture p1: schematic clock.sch]

Parts:
555_RUN, 555_SEL, 555_STEP: LMC555CN_NOPB; DIP794W53P254L959H508Q8N
AND_GATE: SN74HC08N; DIP794W53P254L1930H508Q14N
BUS: 55959-0830; SHDR8W65P250X200_2X4_1140X1400
C1, C2, C6: 0.1uf; C025-024X044
C3, C4, C5: 0.01uf; C025-024X044
C7: 1uf; E5-5
C8, C9: C-US025-024X044; C025-024X044
LEDCLK: BLUE; LED3MM
NOT_GATE: SN74HC04N; DIP794W53P254L1930H508Q14N
OR_GATE: SN74HC32N; DIP794W53P254L1930H508Q14N
POTENTIOMETER: PDB12-M4251-105BF; PDB12M4251105BF
R1, R3, R4, R5: 1k; 0204/7
R6: 1M; 0204/7
RCLK: 220; 0204/7
RUN/STEP: MHPS2285
STEP: MHPS2273N

Connections:
!CLK: BUS.4, NOT_GATE.8 (4Y)
CLK: AND_GATE.8 (3Y), BUS.3, NOT_GATE.9 (4A), RCLK.2
GND: 555_RUN.1 (GROUND), 555_SEL.1 (GROUND), 555_SEL.6 (THRESHOLD), 555_STEP.1 (GROUND), AND_GATE.7 (GND), BUS.2, C1.2, C2.2, C3.2, C4.2, C5.2, C6.2, C7.-, C8.2, C9.2, LEDCLK.K (C), NOT_GATE.5 (3A), NOT_GATE.7 (GND), NOT_GATE.11 (5A), NOT_GATE.13 (6A), OR_GATE.4 (2A), OR_GATE.5 (2B), OR_GATE.7 (GND), OR_GATE.9 (3A), OR_GATE.10 (3B), OR_GATE.12 (4A), OR_GATE.13 (4B), RUN/STEP.3 (COM_1), STEP.A3 (N.O._1)
HLT: BUS.5, NOT_GATE.3 (2A)
unnamed: 555_RUN.7 (DISCHARGE), POTENTIOMETER.2, R1.1
unnamed: 555_RUN.5 (CONTROL_VOLTAGE), C5.1
unnamed: 555_RUN.3 (OUTPUT), AND_GATE.1 (1A)
unnamed: 555_STEP.6 (THRESHOLD), 555_STEP.7 (DISCHARGE), C6.1, R6.1
unnamed: 555_STEP.5 (CONTROL_VOLTAGE), C4.1
unnamed: 555_STEP.3 (OUTPUT), AND_GATE.5 (2B)
unnamed: 555_STEP.2 (!TRIGGER), R5.2, STEP.A2 (COM_1)
unnamed: 555_SEL.2 (!TRIGGER), R3.1, RUN/STEP.1
unnamed: 555_SEL.4 (!RESET), R4.1, RUN/STEP.2
unnamed: 555_SEL.3 (OUTPUT), AND_GATE.2 (1B), NOT_GATE.1 (1A)
unnamed: 555_SEL.5 (CONTROL_VOLTAGE), C3.1
unnamed: LEDCLK.A, RCLK.1
unnamed: AND_GATE.4 (2A), NOT_GATE.2 (1Y)
unnamed: AND_GATE.3 (1Y), OR_GATE.1 (1A)
unnamed: AND_GATE.9 (3A), NOT_GATE.4 (2Y)
unnamed: AND_GATE.6 (2Y), OR_GATE.2 (1B)
unnamed: AND_GATE.10 (3B), OR_GATE.3 (1Y)
POTENTIOMETER: 555_RUN.2 (!TRIGGER), 555_RUN.6 (THRESHOLD), C7.+, POTENTIOMETER.3
VCC: 555_RUN.4 (!RESET), 555_RUN.8 (V+), 555_SEL.8 (V+), 555_STEP.4 (!RESET), 555_STEP.8 (V+), AND_GATE.14 (VCC), BUS.1, C1.1, C2.1, C8.1, C9.1, NOT_GATE.14 (VCC), OR_GATE.14 (VCC), R1.2, R3.2, R4.2, R5.1, R6.2

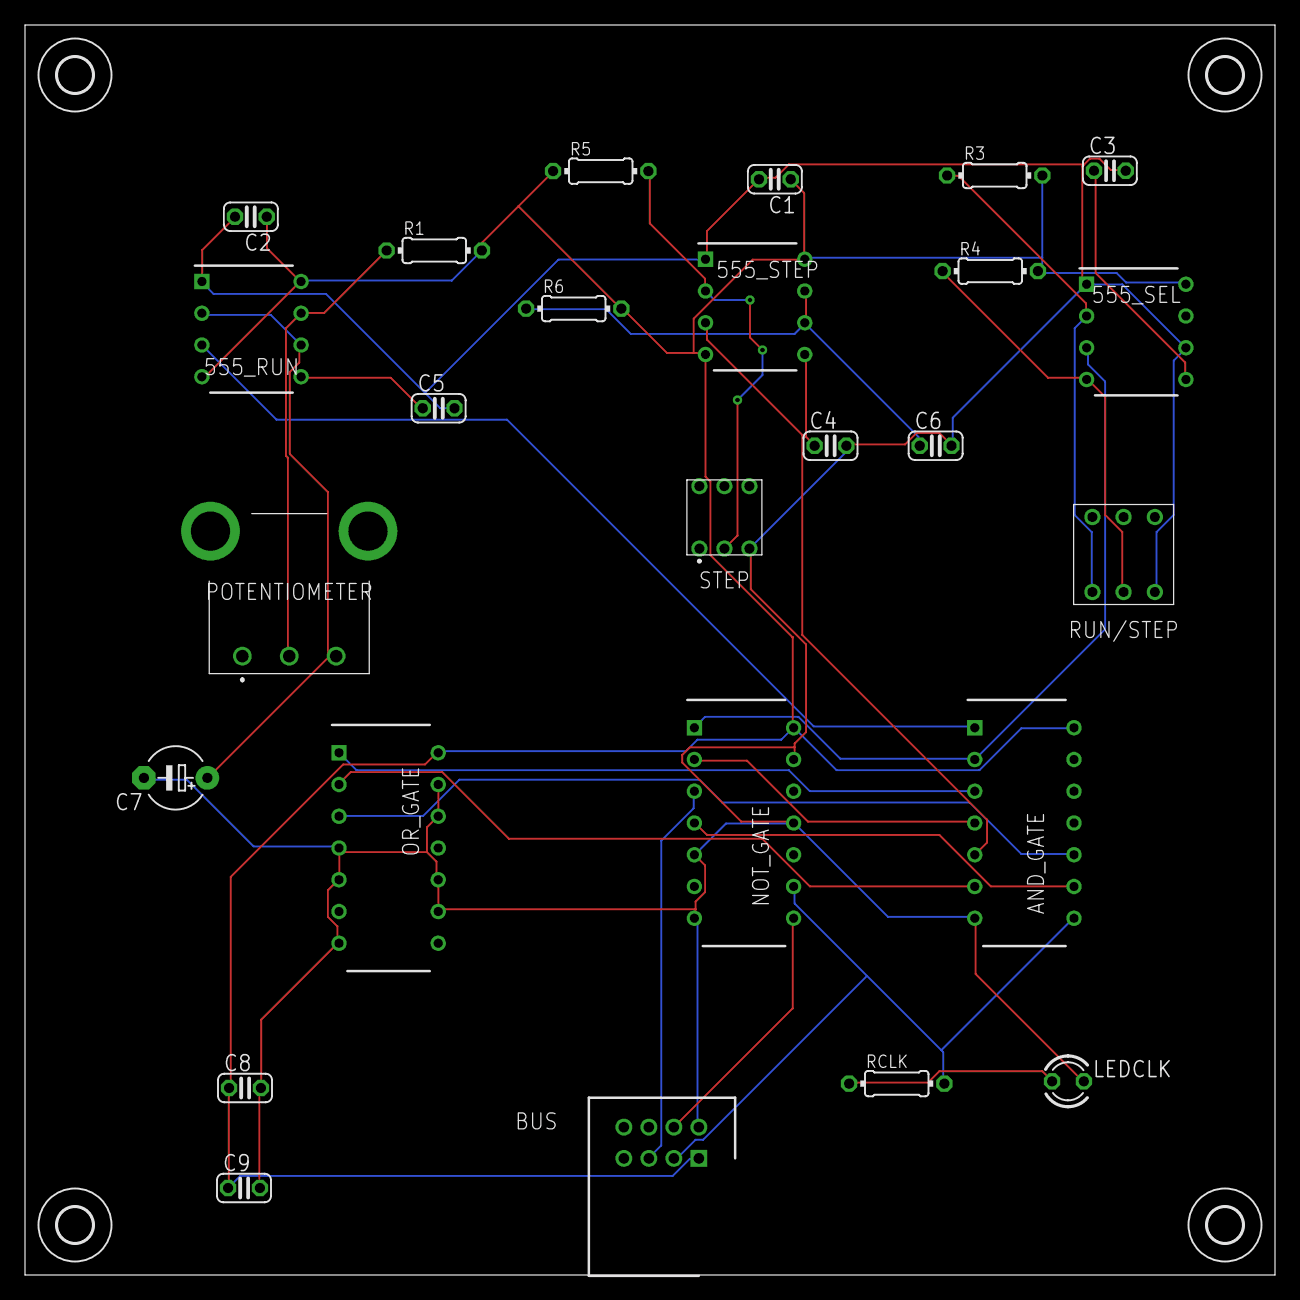
[picture p2: board clock.brd from above]

Board: 2 copper layers, 100.0 x 100.0 mm, 30 parts (0 on the bottom side), 23 nets.

Other parts of the board:
U$1, U$2, U$3, U$4: 2,8
