richardb1998/MARIEPC/Eagle/Accumulator/ACCUMULATOR.brd

## EAGLE design Eagle/Accumulator/ACCUMULATOR.brd (2020-06-12)

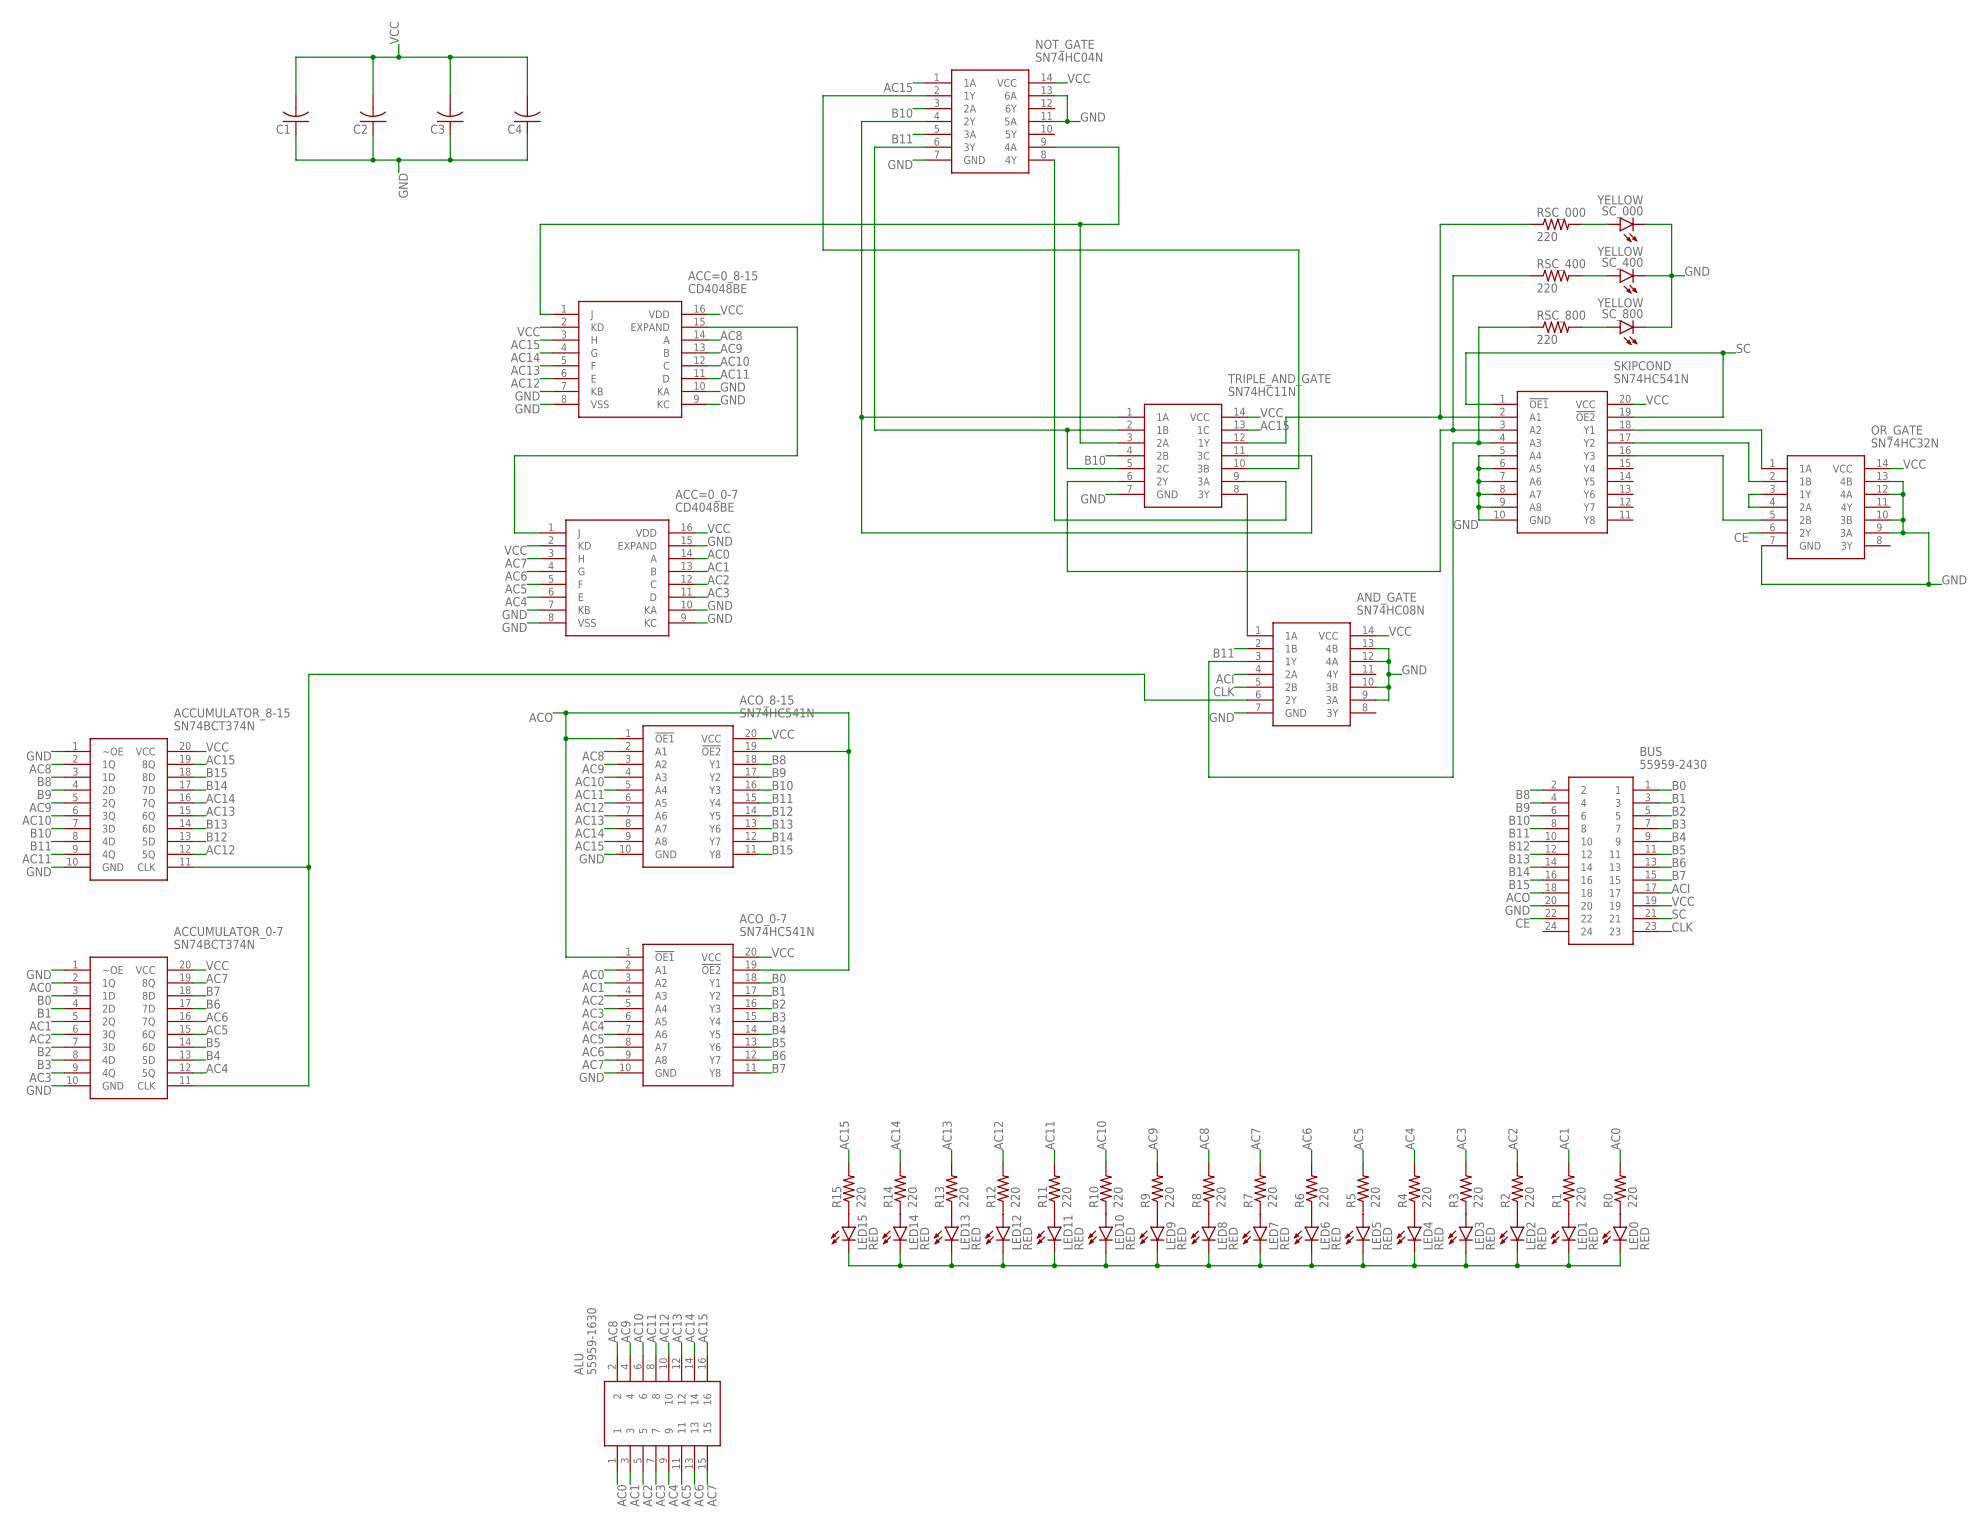
[picture p3: schematic ACCUMULATOR.sch]

Parts:
ACC=0_0-7, ACC=0_8-15: CD4048BE; DIP254P762X508-16
ACCUMULATOR_0-7, ACCUMULATOR_8-15: SN74BCT374N; DIP254P762X508-20
ACO_0-7, ACO_8-15: SN74HC541N; DIP794W53P254L2540H508Q20N
ALU: 55959-1630; SHDR16W65P250X200_2X8_1940X140
AND_GATE: SN74HC08N; DIP794W53P254L1930H508Q14N
BUS: 55959-2430; 559592430
C1, C2, C3, C4: C-US025-024X044; C025-024X044
LED0, LED1, LED2, LED3, LED4, LED5, LED6, LED7, LED8, LED9, LED10, LED11, LED12, LED13, LED14, LED15: RED; LED3MM
NOT_GATE: SN74HC04N; DIP794W53P254L1930H508Q14N
OR_GATE: SN74HC32N; DIP794W53P254L1930H508Q14N
R0, R1, R2, R3, R4, R5, R6, R7, R8, R9, R10, R11, R12, R13, R14, R15: 220; 0204/7
RSC_000, RSC_400, RSC_800: 220; 0204/7
SC_000, SC_400, SC_800: YELLOW; LED3MM
SKIPCOND: SN74HC541N; DIP794W53P254L2540H508Q20N
TRIPLE_AND_GATE: SN74HC11N; DIP794W53P254L1930H508Q14N

Connections:
AC0: ACC=0_0-7.14 (A), ACCUMULATOR_0-7.2 (1Q), ACO_0-7.2 (A1), ALU.1, R0.2
AC1: ACC=0_0-7.13 (B), ACCUMULATOR_0-7.5 (2Q), ACO_0-7.3 (A2), ALU.3, R1.2
AC2: ACC=0_0-7.12 (C), ACCUMULATOR_0-7.6 (3Q), ACO_0-7.4 (A3), ALU.5, R2.2
AC3: ACC=0_0-7.11 (D), ACCUMULATOR_0-7.9 (4Q), ACO_0-7.5 (A4), ALU.7, R3.2
AC4: ACC=0_0-7.6 (E), ACCUMULATOR_0-7.12 (5Q), ACO_0-7.6 (A5), ALU.9, R4.2
AC5: ACC=0_0-7.5 (F), ACCUMULATOR_0-7.15 (6Q), ACO_0-7.7 (A6), ALU.11, R5.2
AC6: ACC=0_0-7.4 (G), ACCUMULATOR_0-7.16 (7Q), ACO_0-7.8 (A7), ALU.13, R6.2
AC7: ACC=0_0-7.3 (H), ACCUMULATOR_0-7.19 (8Q), ACO_0-7.9 (A8), ALU.15, R7.2
AC8: ACC=0_8-15.14 (A), ACCUMULATOR_8-15.2 (1Q), ACO_8-15.2 (A1), ALU.2, R8.2
AC9: ACC=0_8-15.13 (B), ACCUMULATOR_8-15.5 (2Q), ACO_8-15.3 (A2), ALU.4, R9.2
AC10: ACC=0_8-15.12 (C), ACCUMULATOR_8-15.6 (3Q), ACO_8-15.4 (A3), ALU.6, R10.2
AC11: ACC=0_8-15.11 (D), ACCUMULATOR_8-15.9 (4Q), ACO_8-15.5 (A4), ALU.8, R11.2
AC12: ACC=0_8-15.6 (E), ACCUMULATOR_8-15.12 (5Q), ACO_8-15.6 (A5), ALU.10, R12.2
AC13: ACC=0_8-15.5 (F), ACCUMULATOR_8-15.15 (6Q), ACO_8-15.7 (A6), ALU.12, R13.2
AC14: ACC=0_8-15.4 (G), ACCUMULATOR_8-15.16 (7Q), ACO_8-15.8 (A7), ALU.14, R14.2
AC15: ACC=0_8-15.3 (H), ACCUMULATOR_8-15.19 (8Q), ACO_8-15.9 (A8), ALU.16, NOT_GATE.1 (1A), R15.2, TRIPLE_AND_GATE.13 (1C)
ACI: AND_GATE.4 (2A), BUS.17
ACO: ACO_0-7.1 (!OE1), ACO_0-7.19 (!OE2), ACO_8-15.1 (!OE1), ACO_8-15.19 (!OE2), BUS.18
B0: ACCUMULATOR_0-7.3 (1D), ACO_0-7.18 (Y1), BUS.1
B1: ACCUMULATOR_0-7.4 (2D), ACO_0-7.17 (Y2), BUS.3
B2: ACCUMULATOR_0-7.7 (3D), ACO_0-7.16 (Y3), BUS.5
B3: ACCUMULATOR_0-7.8 (4D), ACO_0-7.15 (Y4), BUS.7
B4: ACCUMULATOR_0-7.13 (5D), ACO_0-7.14 (Y5), BUS.9
B5: ACCUMULATOR_0-7.14 (6D), ACO_0-7.13 (Y6), BUS.11
B6: ACCUMULATOR_0-7.17 (7D), ACO_0-7.12 (Y7), BUS.13
B7: ACCUMULATOR_0-7.18 (8D), ACO_0-7.11 (Y8), BUS.15
B8: ACCUMULATOR_8-15.3 (1D), ACO_8-15.18 (Y1), BUS.2
B9: ACCUMULATOR_8-15.4 (2D), ACO_8-15.17 (Y2), BUS.4
B10: ACCUMULATOR_8-15.7 (3D), ACO_8-15.16 (Y3), BUS.6, NOT_GATE.3 (2A), TRIPLE_AND_GATE.4 (2B)
B11: ACCUMULATOR_8-15.8 (4D), ACO_8-15.15 (Y4), AND_GATE.2 (1B), BUS.8, NOT_GATE.5 (3A)
B12: ACCUMULATOR_8-15.13 (5D), ACO_8-15.14 (Y5), BUS.10
B13: ACCUMULATOR_8-15.14 (6D), ACO_8-15.13 (Y6), BUS.12
B14: ACCUMULATOR_8-15.17 (7D), ACO_8-15.12 (Y7), BUS.14
B15: ACCUMULATOR_8-15.18 (8D), ACO_8-15.11 (Y8), BUS.16
CE: BUS.22, OR_GATE.6 (2Y)
CLK: AND_GATE.5 (2B), BUS.23
GND: ACC=0_0-7.7 (KB), ACC=0_0-7.8 (VSS), ACC=0_0-7.9 (KC), ACC=0_0-7.10 (KA), ACC=0_0-7.15 (EXPAND), ACC=0_8-15.7 (KB), ACC=0_8-15.8 (VSS), ACC=0_8-15.9 (KC), ACC=0_8-15.10 (KA), ACCUMULATOR_0-7.1 (~OE), ACCUMULATOR_0-7.10 (GND), ACCUMULATOR_8-15.1 (~OE), ACCUMULATOR_8-15.10 (GND), ACO_0-7.10 (GND), ACO_8-15.10 (GND), AND_GATE.7 (GND), AND_GATE.9 (3A), AND_GATE.10 (3B), AND_GATE.12 (4A), AND_GATE.13 (4B), BUS.20, C1.1, C2.1, C3.1, C4.1, NOT_GATE.7 (GND), NOT_GATE.11 (5A), NOT_GATE.13 (6A), OR_GATE.7 (GND), OR_GATE.9 (3A), OR_GATE.10 (3B), OR_GATE.12 (4A), OR_GATE.13 (4B), SC_000.K (C), SC_400.K (C), SC_800.K (C), SKIPCOND.5 (A4), SKIPCOND.6 (A5), SKIPCOND.7 (A6), SKIPCOND.8 (A7), SKIPCOND.9 (A8), SKIPCOND.10 (GND), TRIPLE_AND_GATE.7 (GND)
unnamed: ACC=0_0-7.1 (J), ACC=0_8-15.15 (EXPAND)
unnamed: RSC_800.2, SC_800.A
unnamed: RSC_400.2, SC_400.A
unnamed: NOT_GATE.4 (2Y), TRIPLE_AND_GATE.1 (1A), TRIPLE_AND_GATE.11 (3C)
unnamed: ACCUMULATOR_0-7.11 (CLK), ACCUMULATOR_8-15.11 (CLK), AND_GATE.6 (2Y)
unnamed: ACC=0_8-15.1 (J), NOT_GATE.9 (4A), TRIPLE_AND_GATE.3 (2A)
unnamed: NOT_GATE.6 (3Y), TRIPLE_AND_GATE.2 (1B), TRIPLE_AND_GATE.5 (2C)
unnamed: RSC_400.1, SKIPCOND.3 (A2), TRIPLE_AND_GATE.6 (2Y)
unnamed: RSC_000.1, SKIPCOND.2 (A1), TRIPLE_AND_GATE.12 (1Y)
unnamed: RSC_000.2, SC_000.A
unnamed: LED0.K (C), LED1.K (C), LED2.K (C), LED3.K (C), LED4.K (C), LED5.K (C), LED6.K (C), LED7.K (C), LED8.K (C), LED9.K (C), LED10.K (C), LED11.K (C), LED12.K (C), LED13.K (C), LED14.K (C), LED15.K (C)
unnamed: NOT_GATE.8 (4Y), TRIPLE_AND_GATE.9 (3A)
unnamed: NOT_GATE.2 (1Y), TRIPLE_AND_GATE.10 (3B)
unnamed: LED1.A, R1.1
unnamed: AND_GATE.1 (1A), TRIPLE_AND_GATE.8 (3Y)
unnamed: LED2.A, R2.1
unnamed: AND_GATE.3 (1Y), RSC_800.1, SKIPCOND.4 (A3)
unnamed: LED3.A, R3.1
unnamed: LED4.A, R4.1
unnamed: LED5.A, R5.1
unnamed: LED6.A, R6.1
unnamed: LED7.A, R7.1
unnamed: LED8.A, R8.1
unnamed: LED9.A, R9.1
unnamed: LED10.A, R10.1
unnamed: LED11.A, R11.1
unnamed: LED12.A, R12.1
unnamed: LED13.A, R13.1
unnamed: LED14.A, R14.1
unnamed: LED15.A, R15.1
unnamed: LED0.A, R0.1
unnamed: OR_GATE.1 (1A), SKIPCOND.18 (Y1)
unnamed: OR_GATE.2 (1B), SKIPCOND.17 (Y2)
unnamed: OR_GATE.3 (1Y), OR_GATE.4 (2A)
unnamed: OR_GATE.5 (2B), SKIPCOND.16 (Y3)
SC: BUS.21, SKIPCOND.1 (!OE1), SKIPCOND.19 (!OE2)
VCC: ACC=0_0-7.2 (KD), ACC=0_0-7.16 (VDD), ACC=0_8-15.2 (KD), ACC=0_8-15.16 (VDD), ACCUMULATOR_0-7.20 (VCC), ACCUMULATOR_8-15.20 (VCC), ACO_0-7.20 (VCC), ACO_8-15.20 (VCC), AND_GATE.14 (VCC), BUS.19, C1.2, C2.2, C3.2, C4.2, NOT_GATE.14 (VCC), OR_GATE.14 (VCC), SKIPCOND.20 (VCC), TRIPLE_AND_GATE.14 (VCC)

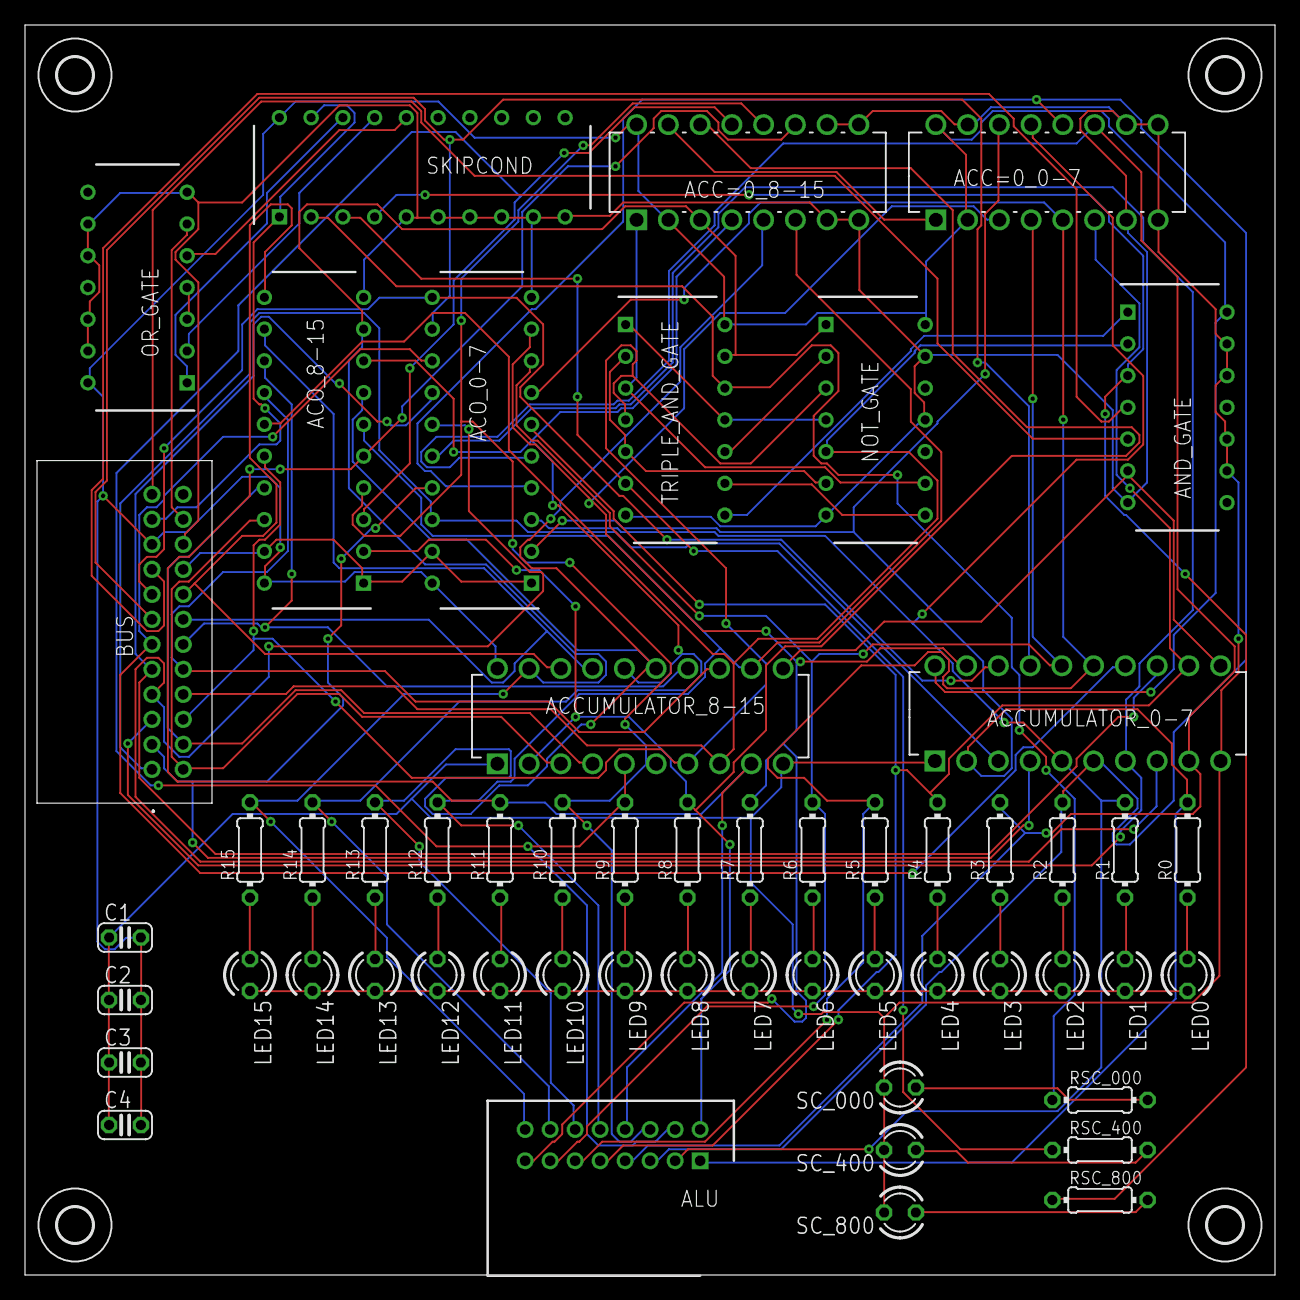
[picture p4: board ACCUMULATOR.brd from above]

Board: 2 copper layers, 100.0 x 100.0 mm, 59 parts (0 on the bottom side), 74 nets.

Other parts of the board:
U$1, U$2, U$3, U$4: 2,8
