richardb1998/MARIEPC/Eagle/Memory/memory_mkII.brd

## EAGLE design Eagle/Memory/memory_mkII.brd (2020-06-12)

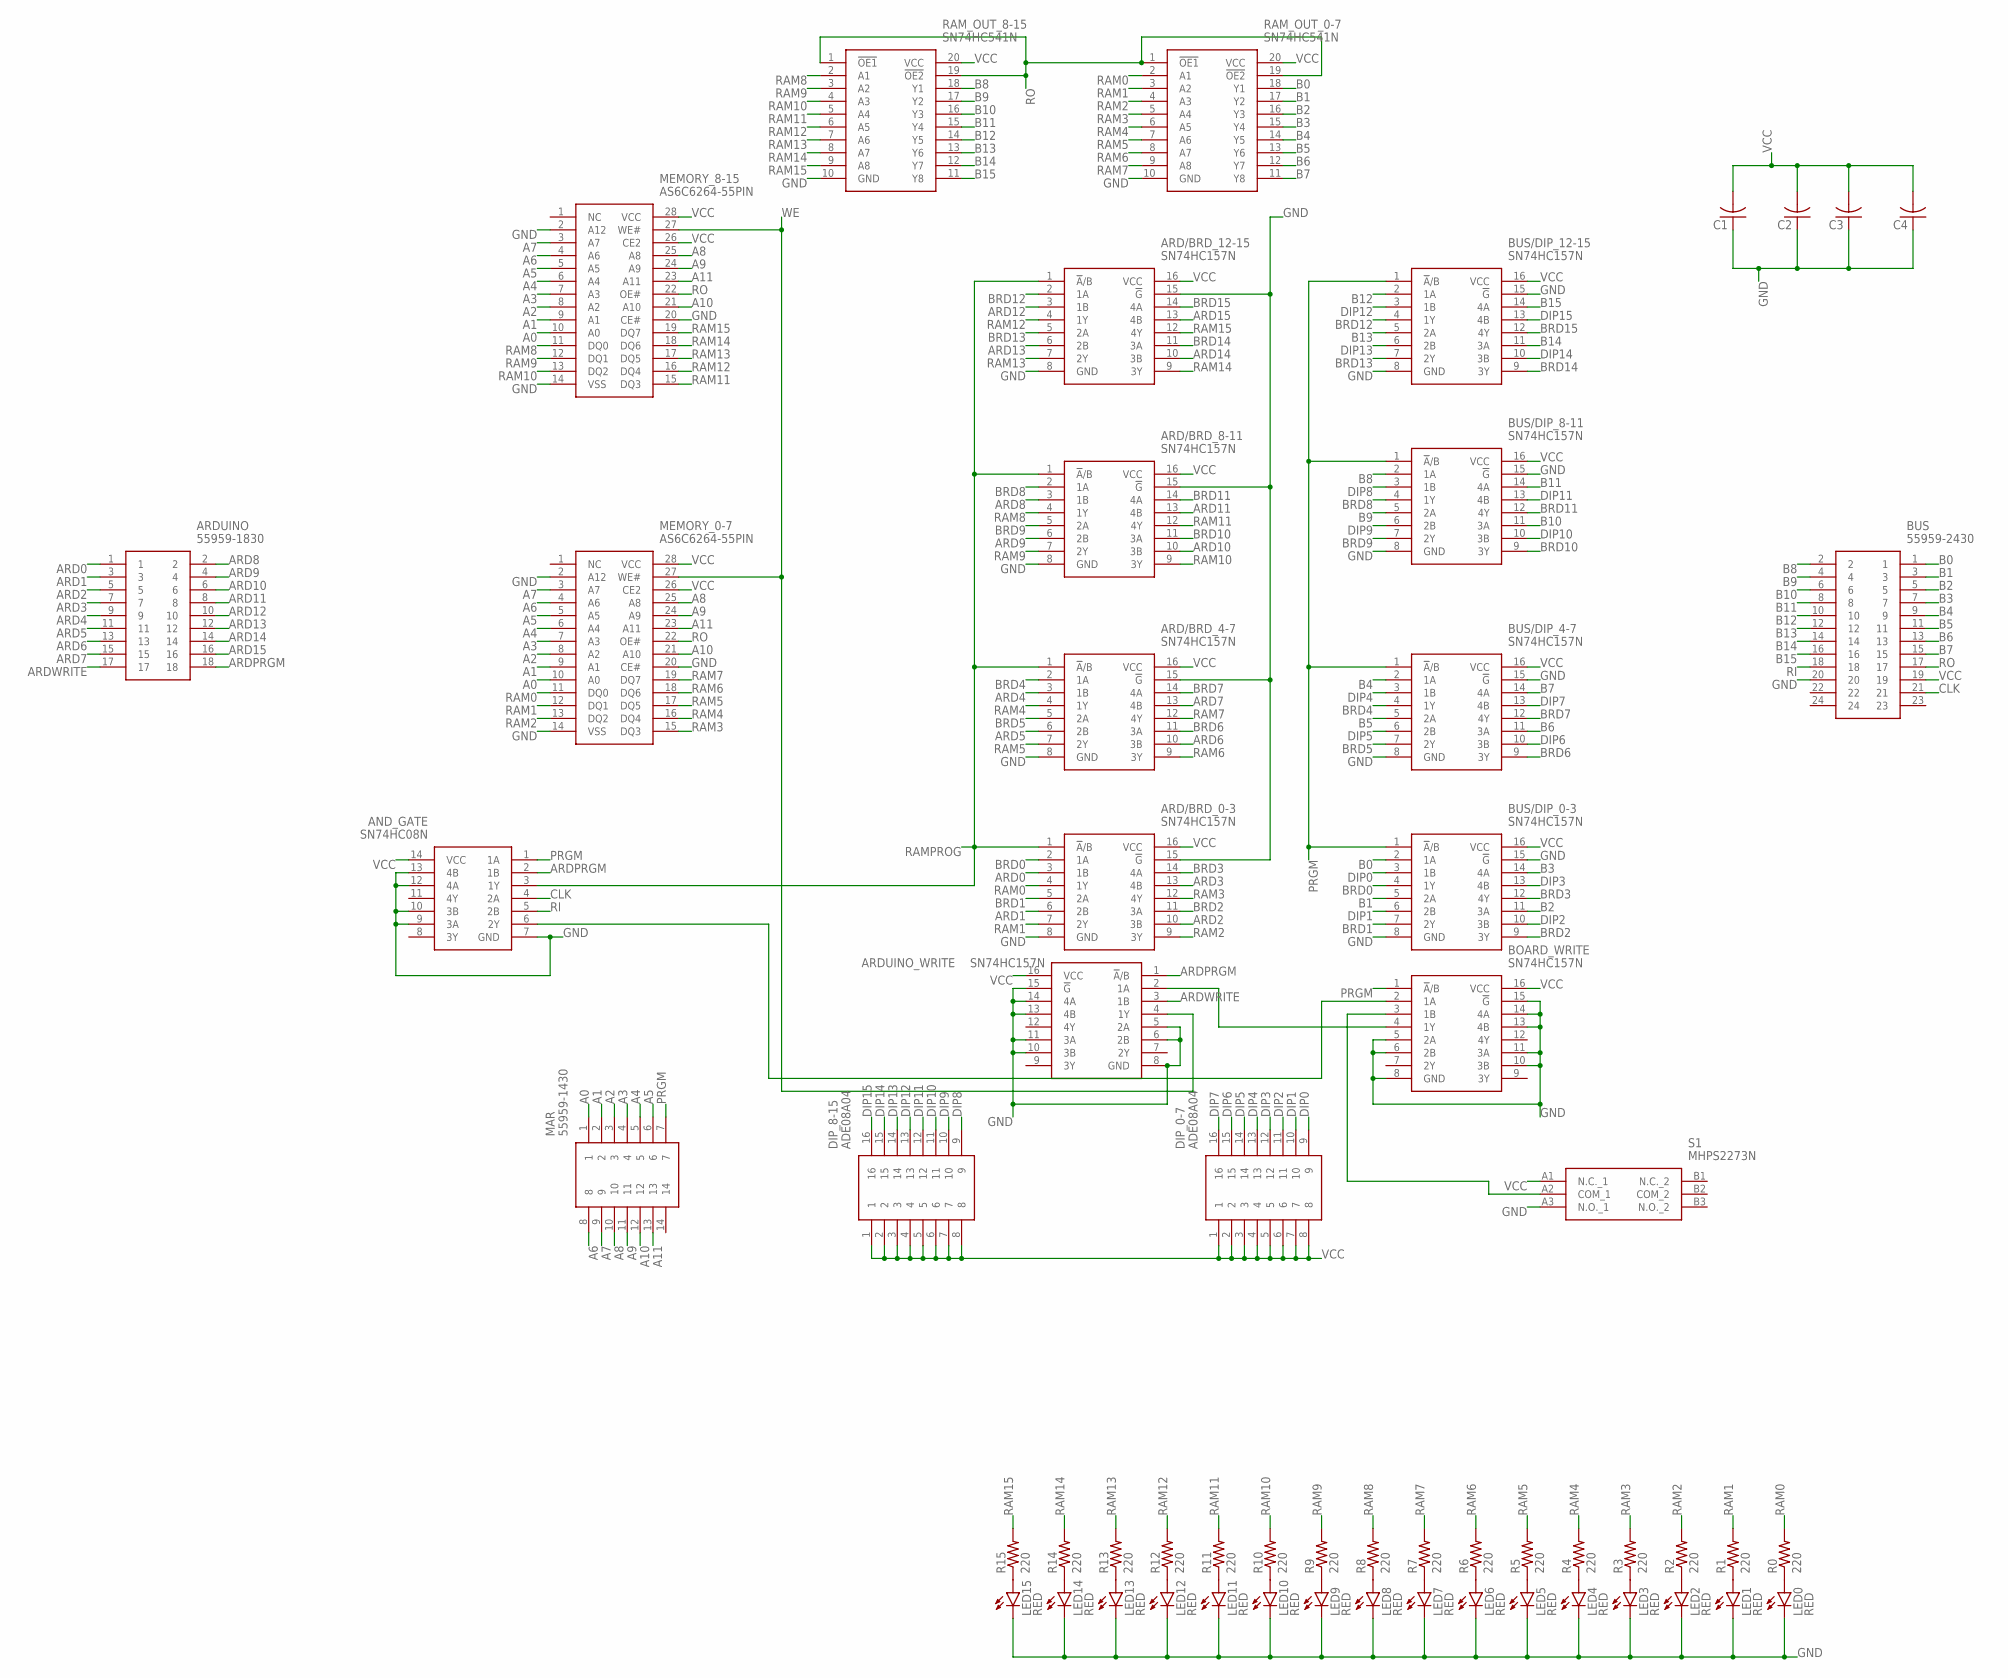
[picture p5: schematic memory_mkII.sch]

Parts:
AND_GATE: SN74HC08N; DIP794W53P254L1930H508Q14N
ARD/BRD_0-3, ARD/BRD_4-7, ARD/BRD_8-11, ARD/BRD_12-15: SN74HC157N; DIP794W53P254L1930H508Q16N
ARDUINO: 55959-1830; SHDR18W65P250X200_2X9_2140X140
ARDUINO_WRITE: SN74HC157N; DIP794W53P254L1930H508Q16N
BOARD_WRITE: SN74HC157N; DIP794W53P254L1930H508Q16N
BUS: 55959-2430; 559592430
BUS/DIP_0-3, BUS/DIP_4-7, BUS/DIP_8-11, BUS/DIP_12-15: SN74HC157N; DIP794W53P254L1930H508Q16N
C1, C2, C3, C4: C-US025-024X044; C025-024X044
DIP_0-7, DIP_8-15: ADE08A04; DIP810W60P254L2225H590Q16N
LED0, LED1, LED2, LED3, LED4, LED5, LED6, LED7, LED8, LED9, LED10, LED11, LED12, LED13, LED14, LED15: RED; LED3MM
MAR: 55959-1430; 559591430
MEMORY_0-7, MEMORY_8-15: AS6C6264-55PIN; DIP1524W51P254L3632H394Q28N
R0, R1, R2, R3, R4, R5, R6, R7, R8, R9, R10, R11, R12, R13, R14, R15: 220; 0204/7
RAM_OUT_0-7, RAM_OUT_8-15: SN74HC541N; DIP794W53P254L2540H508Q20N
S1: MHPS2273N

Connections:
A0: MAR.1, MEMORY_0-7.10 (A0), MEMORY_8-15.10 (A0)
A1: MAR.2, MEMORY_0-7.9 (A1), MEMORY_8-15.9 (A1)
A2: MAR.3, MEMORY_0-7.8 (A2), MEMORY_8-15.8 (A2)
A3: MAR.4, MEMORY_0-7.7 (A3), MEMORY_8-15.7 (A3)
A4: MAR.5, MEMORY_0-7.6 (A4), MEMORY_8-15.6 (A4)
A5: MAR.6, MEMORY_0-7.5 (A5), MEMORY_8-15.5 (A5)
A6: MAR.8, MEMORY_0-7.4 (A6), MEMORY_8-15.4 (A6)
A7: MAR.9, MEMORY_0-7.3 (A7), MEMORY_8-15.3 (A7)
A8: MAR.10, MEMORY_0-7.25 (A8), MEMORY_8-15.25 (A8)
A9: MAR.11, MEMORY_0-7.24 (A9), MEMORY_8-15.24 (A9)
A10: MAR.12, MEMORY_0-7.21 (A10), MEMORY_8-15.21 (A10)
A11: MAR.13, MEMORY_0-7.23 (A11), MEMORY_8-15.23 (A11)
ARD0: ARD/BRD_0-3.3 (1B), ARDUINO.1
ARD1: ARD/BRD_0-3.6 (2B), ARDUINO.3
ARD2: ARD/BRD_0-3.10 (3B), ARDUINO.5
ARD3: ARD/BRD_0-3.13 (4B), ARDUINO.7
ARD4: ARD/BRD_4-7.3 (1B), ARDUINO.9
ARD5: ARD/BRD_4-7.6 (2B), ARDUINO.11
ARD6: ARD/BRD_4-7.10 (3B), ARDUINO.13
ARD7: ARD/BRD_4-7.13 (4B), ARDUINO.15
ARD8: ARD/BRD_8-11.3 (1B), ARDUINO.2
ARD9: ARD/BRD_8-11.6 (2B), ARDUINO.4
ARD10: ARD/BRD_8-11.10 (3B), ARDUINO.6
ARD11: ARD/BRD_8-11.13 (4B), ARDUINO.8
ARD12: ARD/BRD_12-15.3 (1B), ARDUINO.10
ARD13: ARD/BRD_12-15.6 (2B), ARDUINO.12
ARD14: ARD/BRD_12-15.10 (3B), ARDUINO.14
ARD15: ARD/BRD_12-15.13 (4B), ARDUINO.16
ARDPRGM: AND_GATE.2 (1B), ARDUINO.18, ARDUINO_WRITE.1 (!A!/B)
ARDWRITE: ARDUINO.17, ARDUINO_WRITE.3 (1B)
B0: BUS.1, BUS/DIP_0-3.2 (1A), RAM_OUT_0-7.18 (Y1)
B1: BUS.3, BUS/DIP_0-3.5 (2A), RAM_OUT_0-7.17 (Y2)
B2: BUS.5, BUS/DIP_0-3.11 (3A), RAM_OUT_0-7.16 (Y3)
B3: BUS.7, BUS/DIP_0-3.14 (4A), RAM_OUT_0-7.15 (Y4)
B4: BUS.9, BUS/DIP_4-7.2 (1A), RAM_OUT_0-7.14 (Y5)
B5: BUS.11, BUS/DIP_4-7.5 (2A), RAM_OUT_0-7.13 (Y6)
B6: BUS.13, BUS/DIP_4-7.11 (3A), RAM_OUT_0-7.12 (Y7)
B7: BUS.15, BUS/DIP_4-7.14 (4A), RAM_OUT_0-7.11 (Y8)
B8: BUS.2, BUS/DIP_8-11.2 (1A), RAM_OUT_8-15.18 (Y1)
B9: BUS.4, BUS/DIP_8-11.5 (2A), RAM_OUT_8-15.17 (Y2)
B10: BUS.6, BUS/DIP_8-11.11 (3A), RAM_OUT_8-15.16 (Y3)
B11: BUS.8, BUS/DIP_8-11.14 (4A), RAM_OUT_8-15.15 (Y4)
B12: BUS.10, BUS/DIP_12-15.2 (1A), RAM_OUT_8-15.14 (Y5)
B13: BUS.12, BUS/DIP_12-15.5 (2A), RAM_OUT_8-15.13 (Y6)
B14: BUS.14, BUS/DIP_12-15.11 (3A), RAM_OUT_8-15.12 (Y7)
B15: BUS.16, BUS/DIP_12-15.14 (4A), RAM_OUT_8-15.11 (Y8)
BRD0: ARD/BRD_0-3.2 (1A), BUS/DIP_0-3.4 (1Y)
BRD1: ARD/BRD_0-3.5 (2A), BUS/DIP_0-3.7 (2Y)
BRD2: ARD/BRD_0-3.11 (3A), BUS/DIP_0-3.9 (3Y)
BRD3: ARD/BRD_0-3.14 (4A), BUS/DIP_0-3.12 (4Y)
BRD4: ARD/BRD_4-7.2 (1A), BUS/DIP_4-7.4 (1Y)
BRD5: ARD/BRD_4-7.5 (2A), BUS/DIP_4-7.7 (2Y)
BRD6: ARD/BRD_4-7.11 (3A), BUS/DIP_4-7.9 (3Y)
BRD7: ARD/BRD_4-7.14 (4A), BUS/DIP_4-7.12 (4Y)
BRD8: ARD/BRD_8-11.2 (1A), BUS/DIP_8-11.4 (1Y)
BRD9: ARD/BRD_8-11.5 (2A), BUS/DIP_8-11.7 (2Y)
BRD10: ARD/BRD_8-11.11 (3A), BUS/DIP_8-11.9 (3Y)
BRD11: ARD/BRD_8-11.14 (4A), BUS/DIP_8-11.12 (4Y)
BRD12: ARD/BRD_12-15.2 (1A), BUS/DIP_12-15.4 (1Y)
BRD13: ARD/BRD_12-15.5 (2A), BUS/DIP_12-15.7 (2Y)
BRD14: ARD/BRD_12-15.11 (3A), BUS/DIP_12-15.9 (3Y)
BRD15: ARD/BRD_12-15.14 (4A), BUS/DIP_12-15.12 (4Y)
CLK: AND_GATE.4 (2A), BUS.21
DIP0: BUS/DIP_0-3.3 (1B), DIP_0-7.9
DIP1: BUS/DIP_0-3.6 (2B), DIP_0-7.10
DIP2: BUS/DIP_0-3.10 (3B), DIP_0-7.11
DIP3: BUS/DIP_0-3.13 (4B), DIP_0-7.12
DIP4: BUS/DIP_4-7.3 (1B), DIP_0-7.13
DIP5: BUS/DIP_4-7.6 (2B), DIP_0-7.14
DIP6: BUS/DIP_4-7.10 (3B), DIP_0-7.15
DIP7: BUS/DIP_4-7.13 (4B), DIP_0-7.16
DIP8: BUS/DIP_8-11.3 (1B), DIP_8-15.9
DIP9: BUS/DIP_8-11.6 (2B), DIP_8-15.10
DIP10: BUS/DIP_8-11.10 (3B), DIP_8-15.11
DIP11: BUS/DIP_8-11.13 (4B), DIP_8-15.12
DIP12: BUS/DIP_12-15.3 (1B), DIP_8-15.13
DIP13: BUS/DIP_12-15.6 (2B), DIP_8-15.14
DIP14: BUS/DIP_12-15.10 (3B), DIP_8-15.15
DIP15: BUS/DIP_12-15.13 (4B), DIP_8-15.16
GND: AND_GATE.7 (GND), AND_GATE.9 (3A), AND_GATE.10 (3B), AND_GATE.12 (4A), AND_GATE.13 (4B), ARD/BRD_0-3.8 (GND), ARD/BRD_0-3.15 (!G), ARD/BRD_4-7.8 (GND), ARD/BRD_4-7.15 (!G), ARD/BRD_8-11.8 (GND), ARD/BRD_8-11.15 (!G), ARD/BRD_12-15.8 (GND), ARD/BRD_12-15.15 (!G), ARDUINO_WRITE.5 (2A), ARDUINO_WRITE.6 (2B), ARDUINO_WRITE.8 (GND), ARDUINO_WRITE.10 (3B), ARDUINO_WRITE.11 (3A), ARDUINO_WRITE.13 (4B), ARDUINO_WRITE.14 (4A), ARDUINO_WRITE.15 (!G), BOARD_WRITE.5 (2A), BOARD_WRITE.6 (2B), BOARD_WRITE.8 (GND), BOARD_WRITE.10 (3B), BOARD_WRITE.11 (3A), BOARD_WRITE.13 (4B), BOARD_WRITE.14 (4A), BOARD_WRITE.15 (!G), BUS.20, BUS/DIP_0-3.8 (GND), BUS/DIP_0-3.15 (!G), BUS/DIP_4-7.8 (GND), BUS/DIP_4-7.15 (!G), BUS/DIP_8-11.8 (GND), BUS/DIP_8-11.15 (!G), BUS/DIP_12-15.8 (GND), BUS/DIP_12-15.15 (!G), C1.1, C2.1, C3.1, C4.1, LED0.K (C), LED1.K (C), LED2.K (C), LED3.K (C), LED4.K (C), LED5.K (C), LED6.K (C), LED7.K (C), LED8.K (C), LED9.K (C), LED10.K (C), LED11.K (C), LED12.K (C), LED13.K (C), LED14.K (C), LED15.K (C), MEMORY_0-7.2 (A12), MEMORY_0-7.14 (VSS), MEMORY_0-7.20 (CE#), MEMORY_8-15.2 (A12), MEMORY_8-15.14 (VSS), MEMORY_8-15.20 (CE#), RAM_OUT_0-7.10 (GND), RAM_OUT_8-15.10 (GND), S1.A3 (N.O._1)
unnamed: LED1.A, R1.1
unnamed: BOARD_WRITE.3 (1B), S1.A2 (COM_1)
unnamed: ARDUINO_WRITE.2 (1A), BOARD_WRITE.4 (1Y)
unnamed: LED2.A, R2.1
unnamed: LED3.A, R3.1
unnamed: LED4.A, R4.1
unnamed: LED5.A, R5.1
unnamed: LED6.A, R6.1
unnamed: LED7.A, R7.1
unnamed: LED8.A, R8.1
unnamed: LED9.A, R9.1
unnamed: LED10.A, R10.1
unnamed: LED11.A, R11.1
unnamed: LED12.A, R12.1
unnamed: LED13.A, R13.1
unnamed: LED14.A, R14.1
unnamed: LED15.A, R15.1
unnamed: LED0.A, R0.1
PRGM: AND_GATE.1 (1A), BOARD_WRITE.1 (!A!/B), BUS/DIP_0-3.1 (!A!/B), BUS/DIP_4-7.1 (!A!/B), BUS/DIP_8-11.1 (!A!/B), BUS/DIP_12-15.1 (!A!/B), MAR.7
RAM0: ARD/BRD_0-3.4 (1Y), MEMORY_0-7.11 (DQ0), R0.2, RAM_OUT_0-7.2 (A1)
RAM1: ARD/BRD_0-3.7 (2Y), MEMORY_0-7.12 (DQ1), R1.2, RAM_OUT_0-7.3 (A2)
RAM2: ARD/BRD_0-3.9 (3Y), MEMORY_0-7.13 (DQ2), R2.2, RAM_OUT_0-7.4 (A3)
RAM3: ARD/BRD_0-3.12 (4Y), MEMORY_0-7.15 (DQ3), R3.2, RAM_OUT_0-7.5 (A4)
RAM4: ARD/BRD_4-7.4 (1Y), MEMORY_0-7.16 (DQ4), R4.2, RAM_OUT_0-7.6 (A5)
RAM5: ARD/BRD_4-7.7 (2Y), MEMORY_0-7.17 (DQ5), R5.2, RAM_OUT_0-7.7 (A6)
RAM6: ARD/BRD_4-7.9 (3Y), MEMORY_0-7.18 (DQ6), R6.2, RAM_OUT_0-7.8 (A7)
RAM7: ARD/BRD_4-7.12 (4Y), MEMORY_0-7.19 (DQ7), R7.2, RAM_OUT_0-7.9 (A8)
RAM8: ARD/BRD_8-11.4 (1Y), MEMORY_8-15.11 (DQ0), R8.2, RAM_OUT_8-15.2 (A1)
RAM9: ARD/BRD_8-11.7 (2Y), MEMORY_8-15.12 (DQ1), R9.2, RAM_OUT_8-15.3 (A2)
RAM10: ARD/BRD_8-11.9 (3Y), MEMORY_8-15.13 (DQ2), R10.2, RAM_OUT_8-15.4 (A3)
RAM11: ARD/BRD_8-11.12 (4Y), MEMORY_8-15.15 (DQ3), R11.2, RAM_OUT_8-15.5 (A4)
RAM12: ARD/BRD_12-15.4 (1Y), MEMORY_8-15.16 (DQ4), R12.2, RAM_OUT_8-15.6 (A5)
RAM13: ARD/BRD_12-15.7 (2Y), MEMORY_8-15.17 (DQ5), R13.2, RAM_OUT_8-15.7 (A6)
RAM14: ARD/BRD_12-15.9 (3Y), MEMORY_8-15.18 (DQ6), R14.2, RAM_OUT_8-15.8 (A7)
RAM15: ARD/BRD_12-15.12 (4Y), MEMORY_8-15.19 (DQ7), R15.2, RAM_OUT_8-15.9 (A8)
RAMCLK: AND_GATE.6 (2Y), BOARD_WRITE.2 (1A)
RAMPROG: AND_GATE.3 (1Y), ARD/BRD_0-3.1 (!A!/B), ARD/BRD_4-7.1 (!A!/B), ARD/BRD_8-11.1 (!A!/B), ARD/BRD_12-15.1 (!A!/B)
RI: AND_GATE.5 (2B), BUS.18
RO: BUS.17, MEMORY_0-7.22 (OE#), MEMORY_8-15.22 (OE#), RAM_OUT_0-7.1 (!OE1), RAM_OUT_0-7.19 (!OE2), RAM_OUT_8-15.1 (!OE1), RAM_OUT_8-15.19 (!OE2)
VCC: AND_GATE.14 (VCC), ARD/BRD_0-3.16 (VCC), ARD/BRD_4-7.16 (VCC), ARD/BRD_8-11.16 (VCC), ARD/BRD_12-15.16 (VCC), ARDUINO_WRITE.16 (VCC), BOARD_WRITE.16 (VCC), BUS.19, BUS/DIP_0-3.16 (VCC), BUS/DIP_4-7.16 (VCC), BUS/DIP_8-11.16 (VCC), BUS/DIP_12-15.16 (VCC), C1.2, C2.2, C3.2, C4.2, DIP_0-7.1, DIP_0-7.2, DIP_0-7.3, DIP_0-7.4, DIP_0-7.5, DIP_0-7.6, DIP_0-7.7, DIP_0-7.8, DIP_8-15.1, DIP_8-15.2, DIP_8-15.3, DIP_8-15.4, DIP_8-15.5, DIP_8-15.6, DIP_8-15.7, DIP_8-15.8, MEMORY_0-7.26 (CE2), MEMORY_0-7.28 (VCC), MEMORY_8-15.26 (CE2), MEMORY_8-15.28 (VCC), RAM_OUT_0-7.20 (VCC), RAM_OUT_8-15.20 (VCC), S1.A1 (N.C._1)
WE: ARDUINO_WRITE.4 (1Y), MEMORY_0-7.27 (WE#), MEMORY_8-15.27 (WE#)

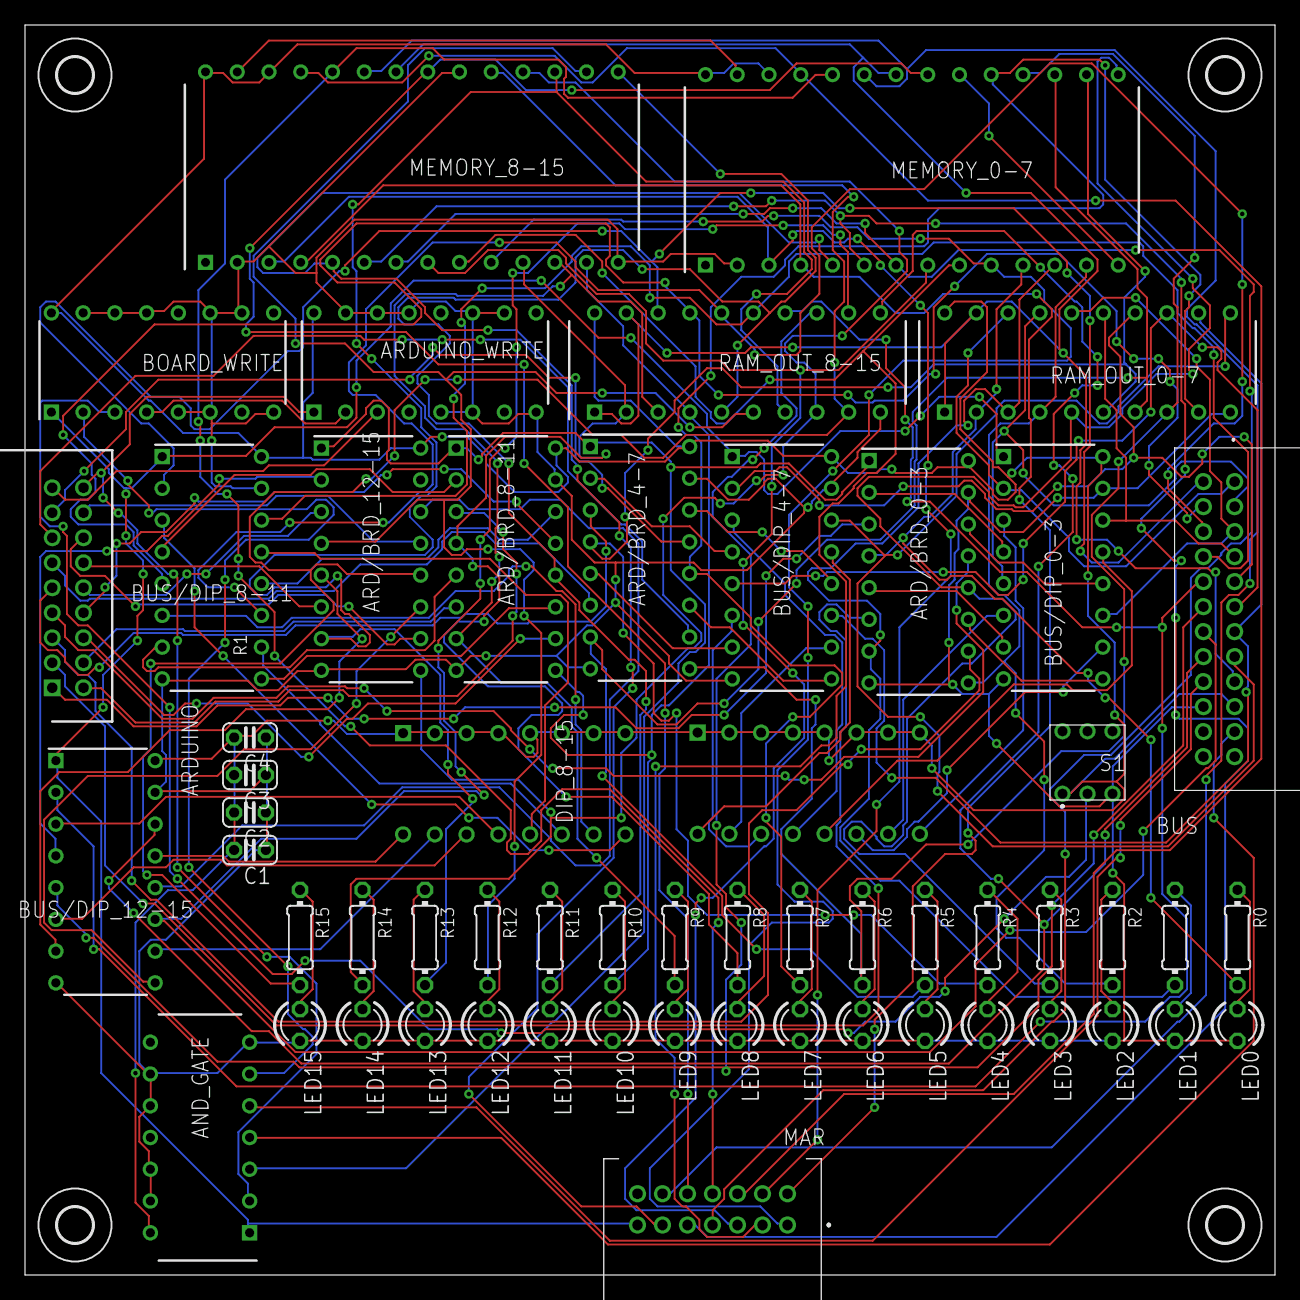
[picture p6: board memory_mkII.brd from above]

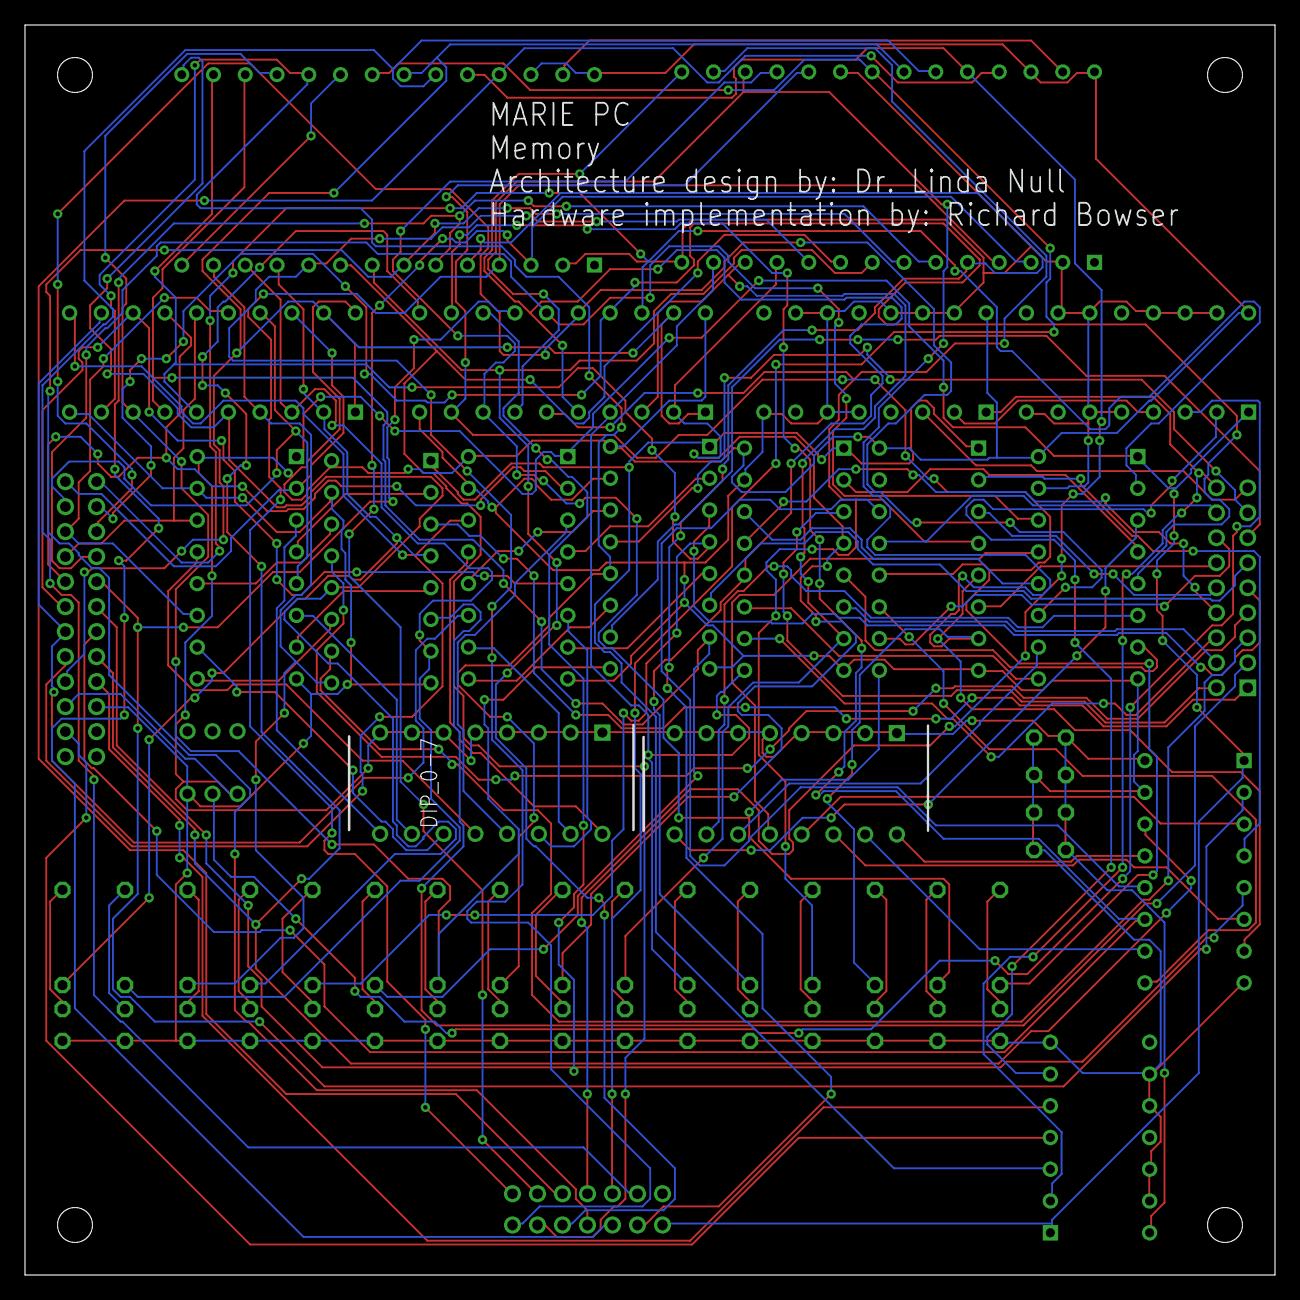
[picture p7: board memory_mkII.brd from below]

Board: 2 copper layers, 100.0 x 100.0 mm, 61 parts (2 on the bottom side), 121 nets.

Other parts of the board:
U$1, U$2, U$3, U$4: 2,8
