richardb1998/MARIEPC/Eagle/Program Counter/Program Counter.brd

## EAGLE design Eagle/Program Counter/Program Counter.brd (2020-06-12)

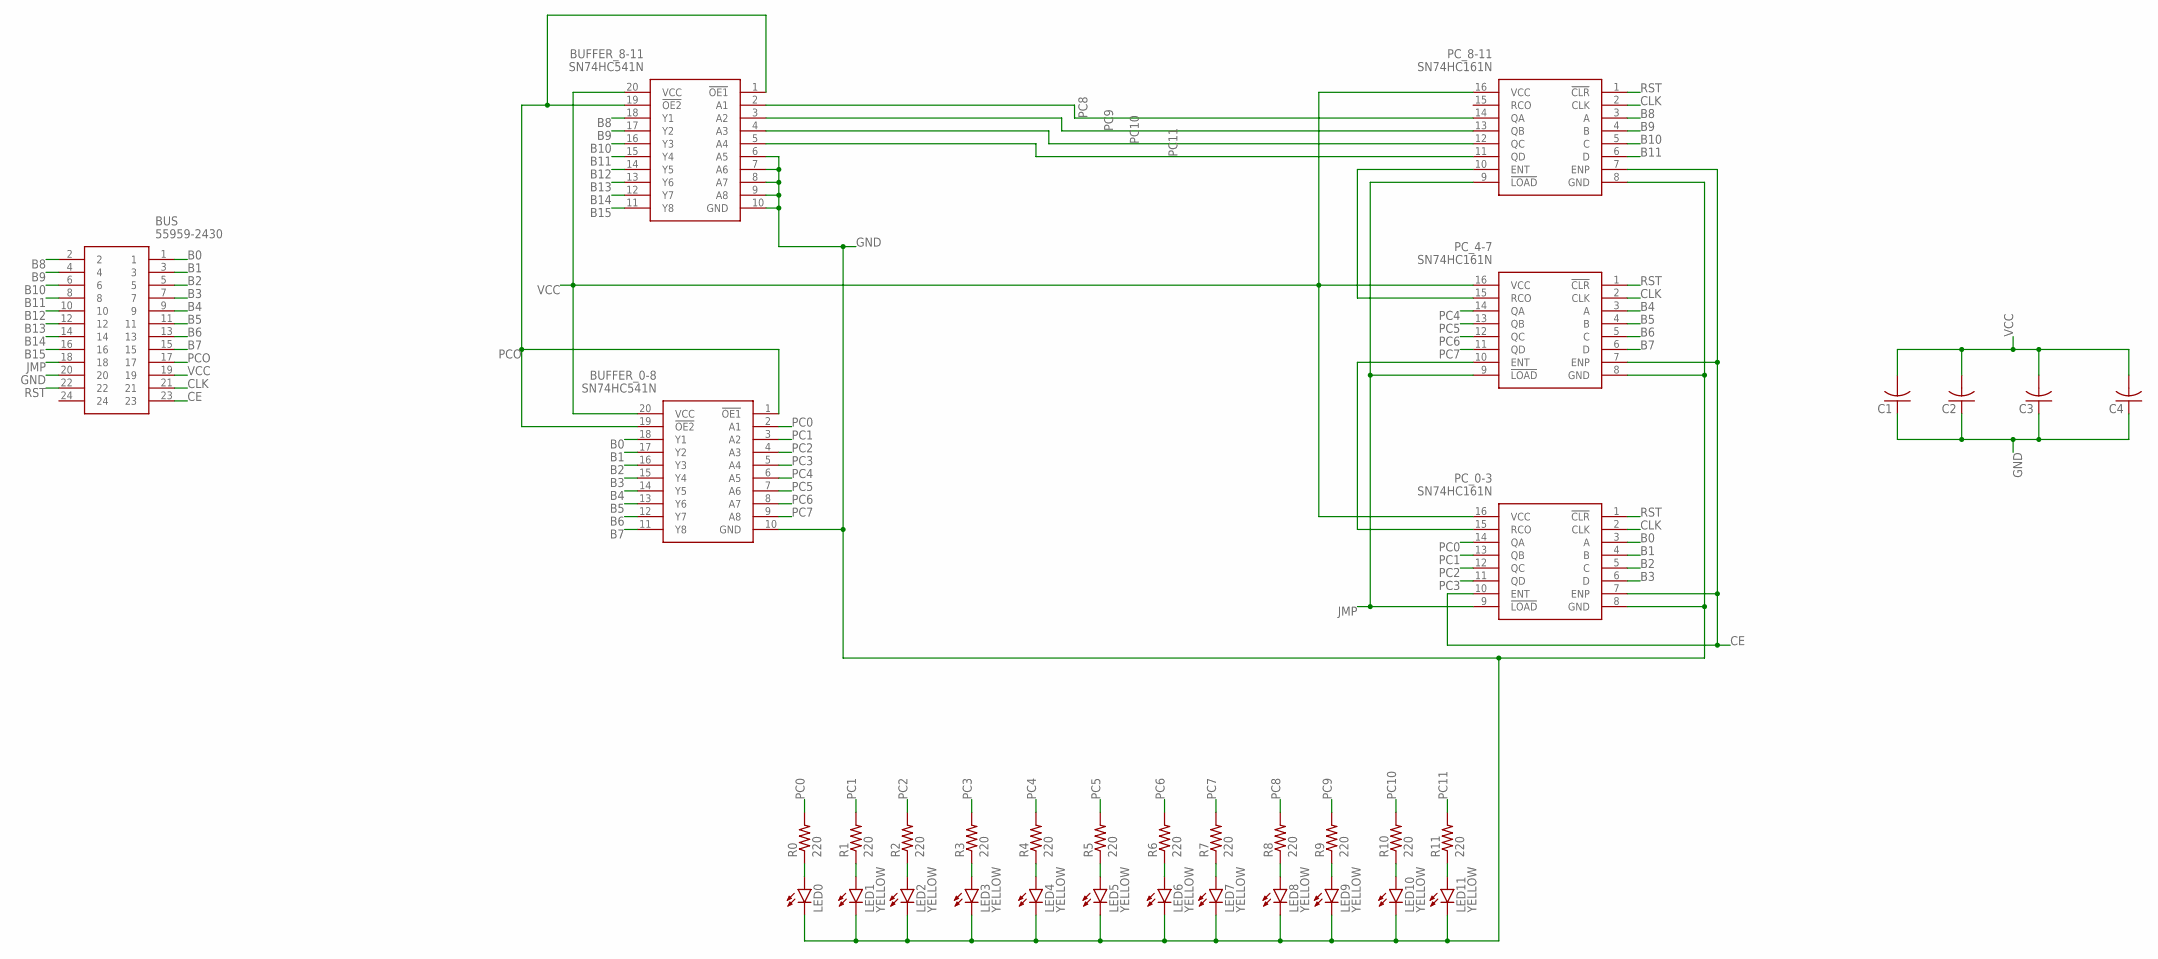
[picture p8: schematic Program Counter.sch]

Parts:
BUFFER_0-8, BUFFER_8-11: SN74HC541N; DIP794W53P254L2540H508Q20N
BUS: 55959-2430; 559592430
C1, C2, C3, C4: C-US025-024X044; C025-024X044
LED0: LED3MM
LED1, LED2, LED3, LED4, LED5, LED6, LED7, LED8, LED9, LED10, LED11: YELLOW; LED3MM
PC_0-3, PC_4-7, PC_8-11: SN74HC161N; DIP794W53P254L1930H508Q16N
R0, R1, R2, R3, R4, R5, R6, R7, R8, R9, R10, R11: 220; 0204/7

Connections:
B0: BUFFER_0-8.18 (Y1), BUS.1, PC_0-3.3 (A)
B1: BUFFER_0-8.17 (Y2), BUS.3, PC_0-3.4 (B)
B2: BUFFER_0-8.16 (Y3), BUS.5, PC_0-3.5 (C)
B3: BUFFER_0-8.15 (Y4), BUS.7, PC_0-3.6 (D)
B4: BUFFER_0-8.14 (Y5), BUS.9, PC_4-7.3 (A)
B5: BUFFER_0-8.13 (Y6), BUS.11, PC_4-7.4 (B)
B6: BUFFER_0-8.12 (Y7), BUS.13, PC_4-7.5 (C)
B7: BUFFER_0-8.11 (Y8), BUS.15, PC_4-7.6 (D)
B8: BUFFER_8-11.18 (Y1), BUS.2, PC_8-11.3 (A)
B9: BUFFER_8-11.17 (Y2), BUS.4, PC_8-11.4 (B)
B10: BUFFER_8-11.16 (Y3), BUS.6, PC_8-11.5 (C)
B11: BUFFER_8-11.15 (Y4), BUS.8, PC_8-11.6 (D)
B12: BUFFER_8-11.14 (Y5), BUS.10
B13: BUFFER_8-11.13 (Y6), BUS.12
B14: BUFFER_8-11.12 (Y7), BUS.14
B15: BUFFER_8-11.11 (Y8), BUS.16
CE: BUS.23, PC_0-3.7 (ENP), PC_0-3.10 (ENT), PC_4-7.7 (ENP), PC_8-11.7 (ENP)
CLK: BUS.21, PC_0-3.2 (CLK), PC_4-7.2 (CLK), PC_8-11.2 (CLK)
GND: BUFFER_0-8.10 (GND), BUFFER_8-11.6 (A5), BUFFER_8-11.7 (A6), BUFFER_8-11.8 (A7), BUFFER_8-11.9 (A8), BUFFER_8-11.10 (GND), BUS.20, C1.1, C2.1, C3.1, C4.1, LED0.K (C), LED1.K (C), LED2.K (C), LED3.K (C), LED4.K (C), LED5.K (C), LED6.K (C), LED7.K (C), LED8.K (C), LED9.K (C), LED10.K (C), LED11.K (C), PC_0-3.8 (GND), PC_4-7.8 (GND), PC_8-11.8 (GND)
JMP: BUS.18, PC_0-3.9 (!LOAD), PC_4-7.9 (!LOAD), PC_8-11.9 (!LOAD)
unnamed: PC_0-3.15 (RCO), PC_4-7.10 (ENT)
unnamed: PC_4-7.15 (RCO), PC_8-11.10 (ENT)
unnamed: LED0.A, R0.1
unnamed: LED1.A, R1.1
unnamed: LED2.A, R2.1
unnamed: LED3.A, R3.1
unnamed: LED4.A, R4.1
unnamed: LED5.A, R5.1
unnamed: LED6.A, R6.1
unnamed: LED7.A, R7.1
unnamed: LED8.A, R8.1
unnamed: LED9.A, R9.1
unnamed: LED10.A, R10.1
unnamed: LED11.A, R11.1
PC0: BUFFER_0-8.2 (A1), PC_0-3.14 (QA), R0.2
PC1: BUFFER_0-8.3 (A2), PC_0-3.13 (QB), R1.2
PC2: BUFFER_0-8.4 (A3), PC_0-3.12 (QC), R2.2
PC3: BUFFER_0-8.5 (A4), PC_0-3.11 (QD), R3.2
PC4: BUFFER_0-8.6 (A5), PC_4-7.14 (QA), R4.2
PC5: BUFFER_0-8.7 (A6), PC_4-7.13 (QB), R5.2
PC6: BUFFER_0-8.8 (A7), PC_4-7.12 (QC), R6.2
PC7: BUFFER_0-8.9 (A8), PC_4-7.11 (QD), R7.2
PC8: BUFFER_8-11.2 (A1), PC_8-11.14 (QA), R8.2
PC9: BUFFER_8-11.3 (A2), PC_8-11.13 (QB), R9.2
PC10: BUFFER_8-11.4 (A3), PC_8-11.12 (QC), R10.2
PC11: BUFFER_8-11.5 (A4), PC_8-11.11 (QD), R11.2
PCO: BUFFER_0-8.1 (!OE1), BUFFER_0-8.19 (!OE2), BUFFER_8-11.1 (!OE1), BUFFER_8-11.19 (!OE2), BUS.17
RST: BUS.22, PC_0-3.1 (!CLR), PC_4-7.1 (!CLR), PC_8-11.1 (!CLR)
VCC: BUFFER_0-8.20 (VCC), BUFFER_8-11.20 (VCC), BUS.19, C1.2, C2.2, C3.2, C4.2, PC_0-3.16 (VCC), PC_4-7.16 (VCC), PC_8-11.16 (VCC)

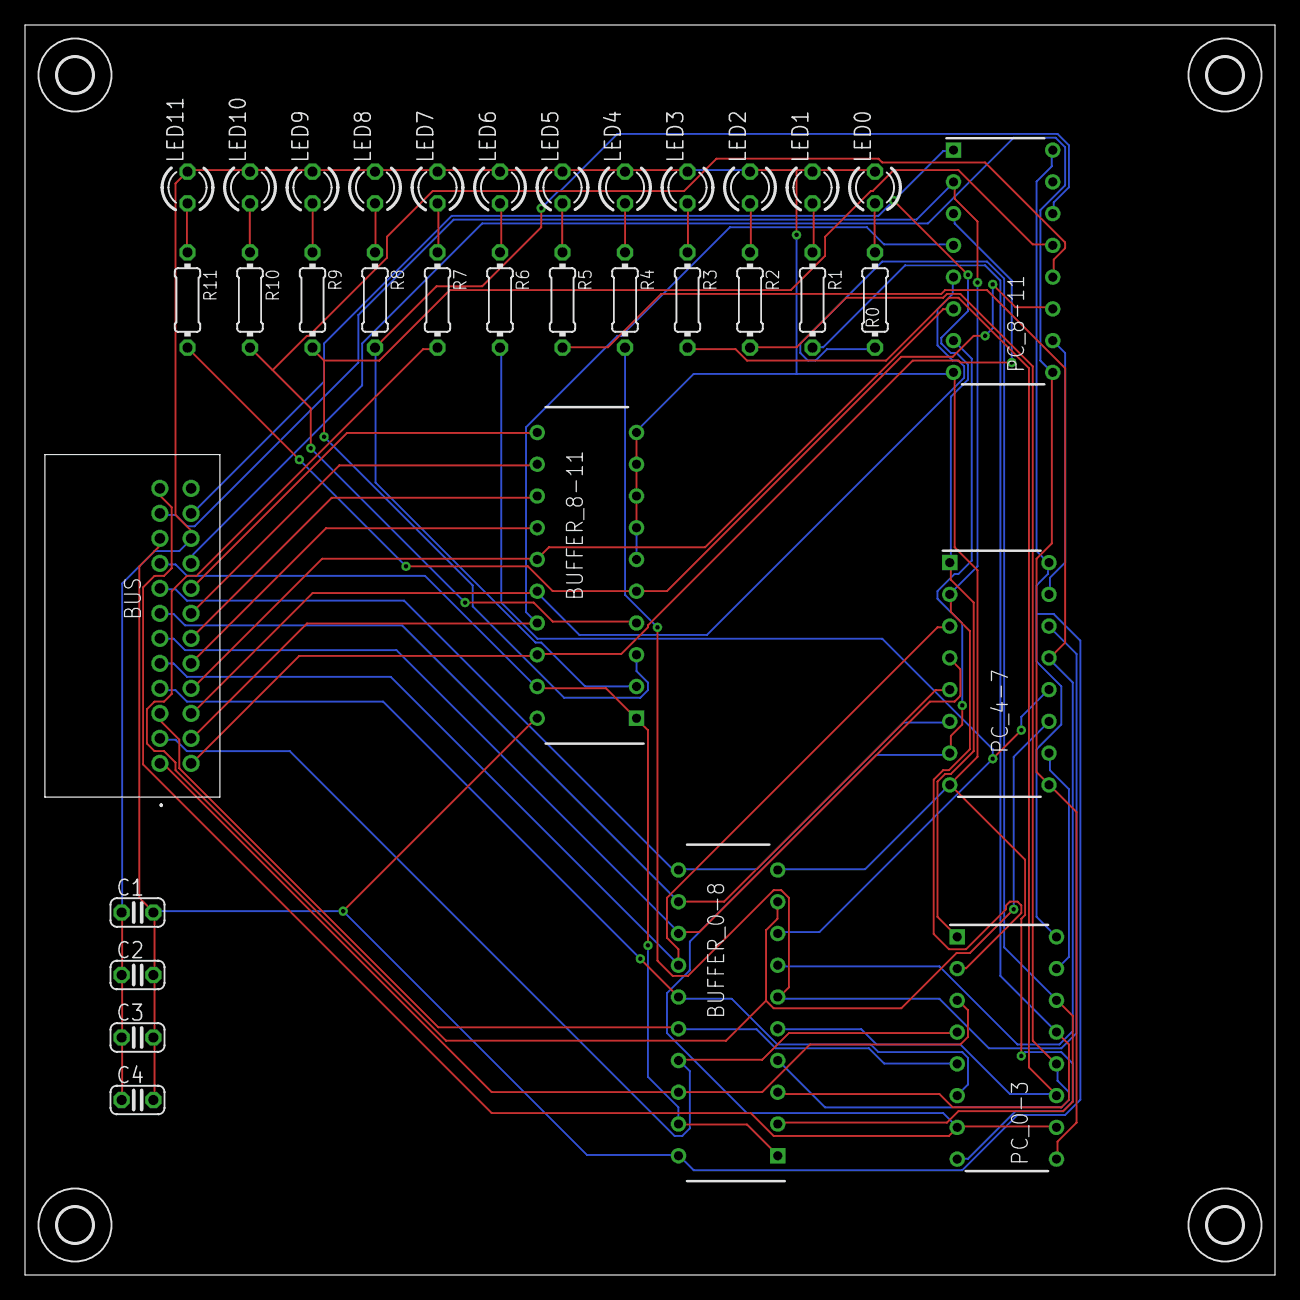
[picture p9: board Program Counter.brd from above]

Board: 2 copper layers, 100.0 x 100.0 mm, 38 parts (0 on the bottom side), 49 nets.

Other parts of the board:
U$1, U$2, U$3, U$4: 2,8
