richardb1998/MARIEPC/Eagle/Memory/MAR.brd

## EAGLE design Eagle/Memory/MAR.brd (2020-02-25)

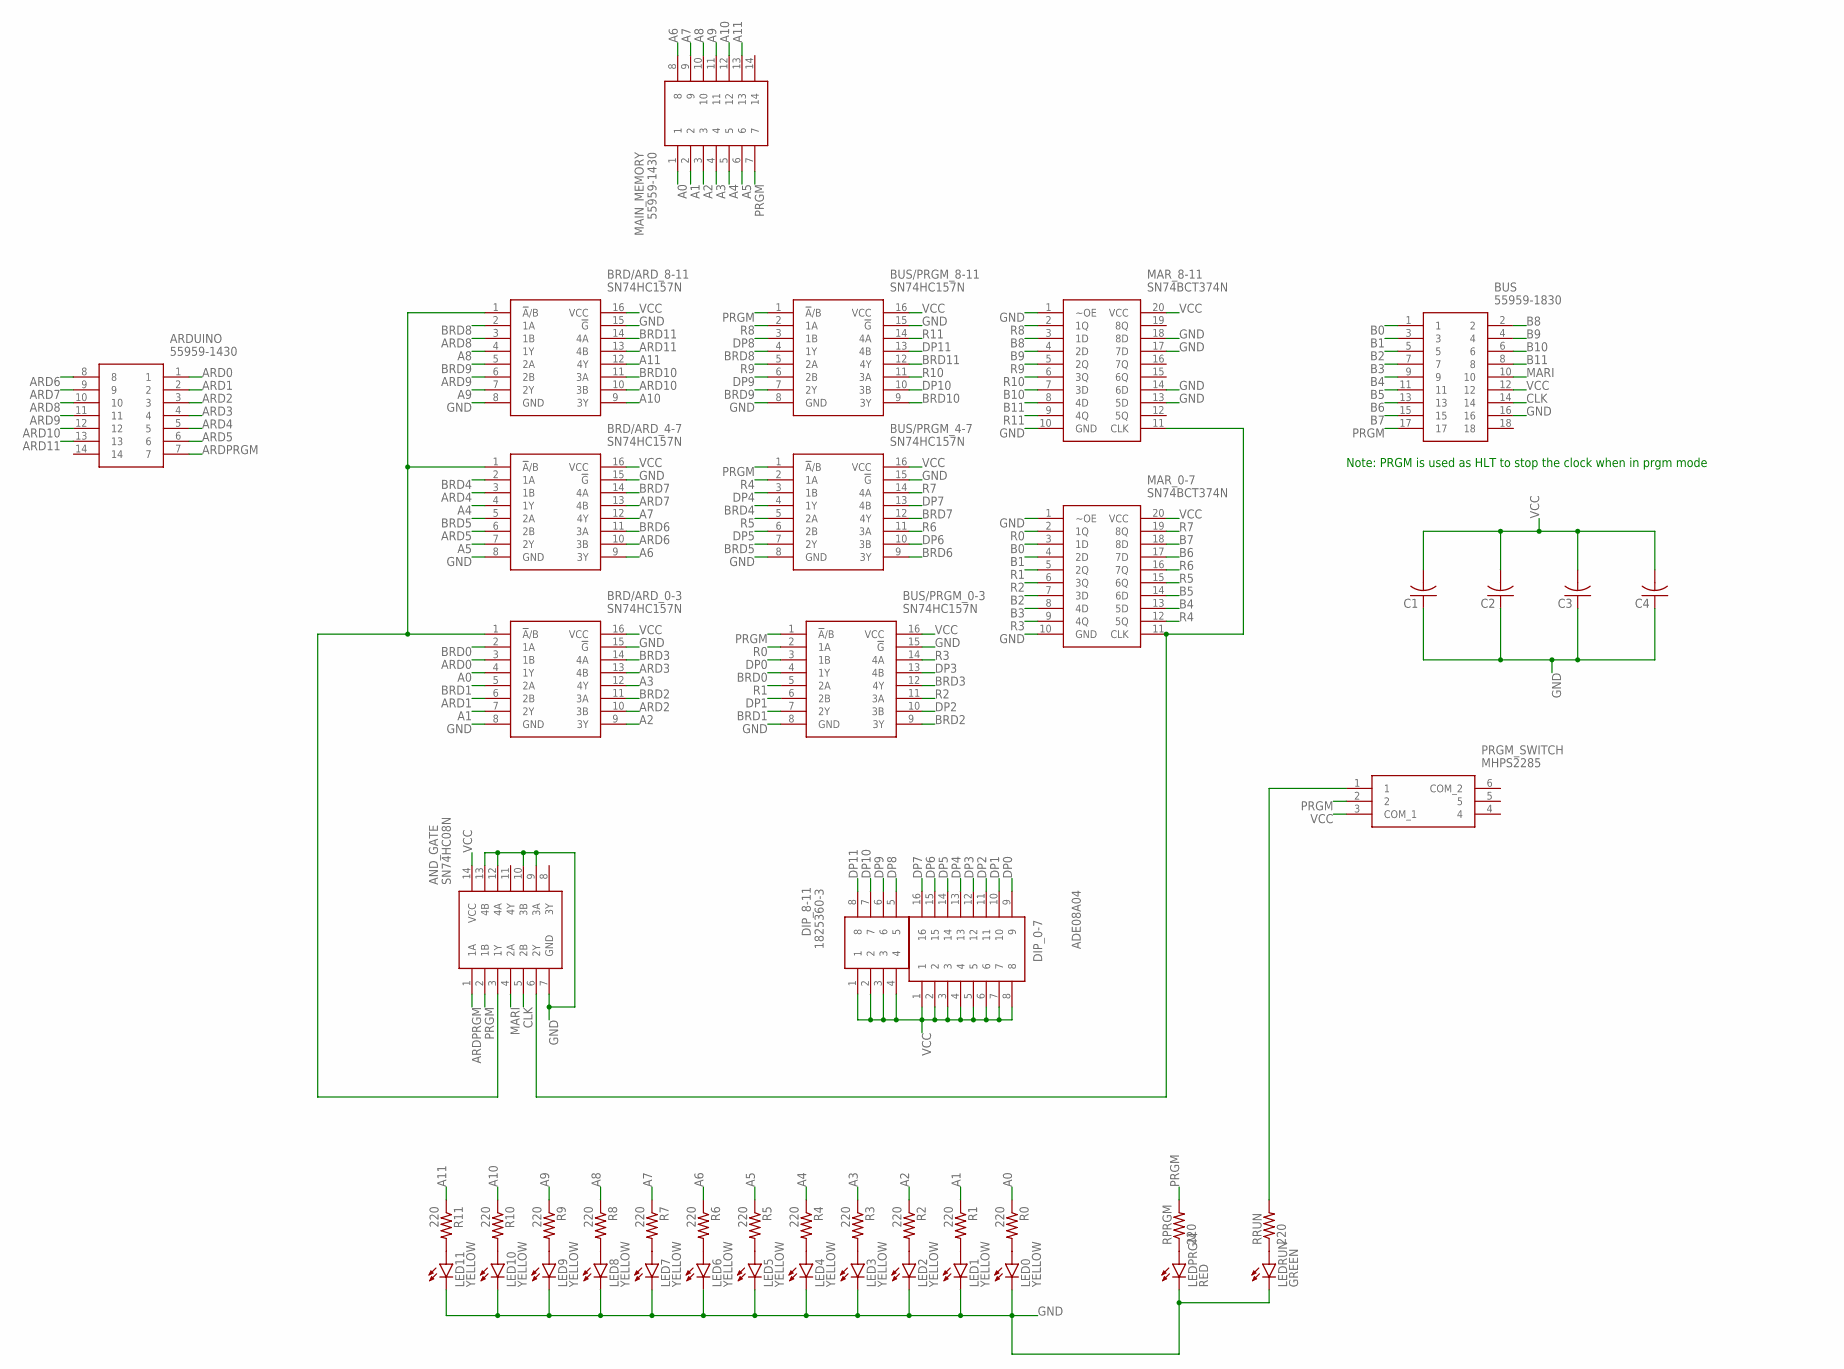
[picture p10: schematic MAR.sch]

Parts:
AND_GATE: SN74HC08N; DIP794W53P254L1930H508Q14N
ARDUINO: 55959-1430; 559591430
BRD/ARD_0-3, BRD/ARD_4-7, BRD/ARD_8-11: SN74HC157N; DIP794W53P254L1930H508Q16N
BUS: 55959-1830; SHDR18W65P250X200_2X9_2140X140
BUS/PRGM_0-3, BUS/PRGM_4-7, BUS/PRGM_8-11: SN74HC157N; DIP794W53P254L1930H508Q16N
C1, C2, C3, C4: C-US025-024X044; C025-024X044
DIP_0-7: ADE08A04; DIP810W60P254L2225H590Q16N
DIP_8-11: 1825360-3; DIP813W61P254L1209H351Q8N
LED0, LED1, LED2, LED3, LED4, LED5, LED6, LED7, LED8, LED9, LED10, LED11: YELLOW; LED3MM
LEDPRGM: RED; LED3MM
LEDRUN: GREEN; LED3MM
MAIN_MEMORY: 55959-1430; 559591430
MAR_0-7, MAR_8-11: SN74BCT374N; DIP254P762X508-20
PRGM_SWITCH: MHPS2285
R0, R1, R2, R3, R4, R5, R6, R7, R8, R9, R10, R11: 220; 0204/7
RPRGM: 220; 0204/7
RRUN: 220; 0204/7

Connections:
A0: BRD/ARD_0-3.4 (1Y), MAIN_MEMORY.1, R0.1
A1: BRD/ARD_0-3.7 (2Y), MAIN_MEMORY.2, R1.1
A2: BRD/ARD_0-3.9 (3Y), MAIN_MEMORY.3, R2.1
A3: BRD/ARD_0-3.12 (4Y), MAIN_MEMORY.4, R3.1
A4: BRD/ARD_4-7.4 (1Y), MAIN_MEMORY.5, R4.1
A5: BRD/ARD_4-7.7 (2Y), MAIN_MEMORY.6, R5.1
A6: BRD/ARD_4-7.9 (3Y), MAIN_MEMORY.8, R6.1
A7: BRD/ARD_4-7.12 (4Y), MAIN_MEMORY.9, R7.1
A8: BRD/ARD_8-11.4 (1Y), MAIN_MEMORY.10, R8.1
A9: BRD/ARD_8-11.7 (2Y), MAIN_MEMORY.11, R9.1
A10: BRD/ARD_8-11.9 (3Y), MAIN_MEMORY.12, R10.1
A11: BRD/ARD_8-11.12 (4Y), MAIN_MEMORY.13, R11.1
ARD0: ARDUINO.1, BRD/ARD_0-3.3 (1B)
ARD1: ARDUINO.2, BRD/ARD_0-3.6 (2B)
ARD2: ARDUINO.3, BRD/ARD_0-3.10 (3B)
ARD3: ARDUINO.4, BRD/ARD_0-3.13 (4B)
ARD4: ARDUINO.5, BRD/ARD_4-7.3 (1B)
ARD5: ARDUINO.6, BRD/ARD_4-7.6 (2B)
ARD6: ARDUINO.8, BRD/ARD_4-7.10 (3B)
ARD7: ARDUINO.9, BRD/ARD_4-7.13 (4B)
ARD8: ARDUINO.10, BRD/ARD_8-11.3 (1B)
ARD9: ARDUINO.11, BRD/ARD_8-11.6 (2B)
ARD10: ARDUINO.12, BRD/ARD_8-11.10 (3B)
ARD11: ARDUINO.13, BRD/ARD_8-11.13 (4B)
ARDPRGM: AND_GATE.1 (1A), ARDUINO.7
B0: BUS.1, MAR_0-7.3 (1D)
B1: BUS.3, MAR_0-7.4 (2D)
B2: BUS.5, MAR_0-7.7 (3D)
B3: BUS.7, MAR_0-7.8 (4D)
B4: BUS.9, MAR_0-7.13 (5D)
B5: BUS.11, MAR_0-7.14 (6D)
B6: BUS.13, MAR_0-7.17 (7D)
B7: BUS.15, MAR_0-7.18 (8D)
B8: BUS.2, MAR_8-11.3 (1D)
B9: BUS.4, MAR_8-11.4 (2D)
B10: BUS.6, MAR_8-11.7 (3D)
B11: BUS.8, MAR_8-11.8 (4D)
BRD0: BRD/ARD_0-3.2 (1A), BUS/PRGM_0-3.4 (1Y)
BRD1: BRD/ARD_0-3.5 (2A), BUS/PRGM_0-3.7 (2Y)
BRD2: BRD/ARD_0-3.11 (3A), BUS/PRGM_0-3.9 (3Y)
BRD3: BRD/ARD_0-3.14 (4A), BUS/PRGM_0-3.12 (4Y)
BRD4: BRD/ARD_4-7.2 (1A), BUS/PRGM_4-7.4 (1Y)
BRD5: BRD/ARD_4-7.5 (2A), BUS/PRGM_4-7.7 (2Y)
BRD6: BRD/ARD_4-7.11 (3A), BUS/PRGM_4-7.9 (3Y)
BRD7: BRD/ARD_4-7.14 (4A), BUS/PRGM_4-7.12 (4Y)
BRD8: BRD/ARD_8-11.2 (1A), BUS/PRGM_8-11.4 (1Y)
BRD9: BRD/ARD_8-11.5 (2A), BUS/PRGM_8-11.7 (2Y)
BRD10: BRD/ARD_8-11.11 (3A), BUS/PRGM_8-11.9 (3Y)
BRD11: BRD/ARD_8-11.14 (4A), BUS/PRGM_8-11.12 (4Y)
CLK: AND_GATE.5 (2B), BUS.14
DP0: BUS/PRGM_0-3.3 (1B), DIP_0-7.9
DP1: BUS/PRGM_0-3.6 (2B), DIP_0-7.10
DP2: BUS/PRGM_0-3.10 (3B), DIP_0-7.11
DP3: BUS/PRGM_0-3.13 (4B), DIP_0-7.12
DP4: BUS/PRGM_4-7.3 (1B), DIP_0-7.13
DP5: BUS/PRGM_4-7.6 (2B), DIP_0-7.14
DP6: BUS/PRGM_4-7.10 (3B), DIP_0-7.15
DP7: BUS/PRGM_4-7.13 (4B), DIP_0-7.16
DP8: BUS/PRGM_8-11.3 (1B), DIP_8-11.5
DP9: BUS/PRGM_8-11.6 (2B), DIP_8-11.6
DP10: BUS/PRGM_8-11.10 (3B), DIP_8-11.7
DP11: BUS/PRGM_8-11.13 (4B), DIP_8-11.8
GND: AND_GATE.7 (GND), AND_GATE.9 (3A), AND_GATE.10 (3B), AND_GATE.12 (4A), AND_GATE.13 (4B), BRD/ARD_0-3.8 (GND), BRD/ARD_0-3.15 (!G), BRD/ARD_4-7.8 (GND), BRD/ARD_4-7.15 (!G), BRD/ARD_8-11.8 (GND), BRD/ARD_8-11.15 (!G), BUS.16, BUS/PRGM_0-3.8 (GND), BUS/PRGM_0-3.15 (!G), BUS/PRGM_4-7.8 (GND), BUS/PRGM_4-7.15 (!G), BUS/PRGM_8-11.8 (GND), BUS/PRGM_8-11.15 (!G), C1.1, C2.1, C3.1, C4.1, LED0.K (C), LED1.K (C), LED2.K (C), LED3.K (C), LED4.K (C), LED5.K (C), LED6.K (C), LED7.K (C), LED8.K (C), LED9.K (C), LED10.K (C), LED11.K (C), LEDPRGM.K (C), LEDRUN.K (C), MAR_0-7.1 (~OE), MAR_0-7.10 (GND), MAR_8-11.1 (~OE), MAR_8-11.10 (GND), MAR_8-11.13 (5D), MAR_8-11.14 (6D), MAR_8-11.17 (7D), MAR_8-11.18 (8D)
MARI: AND_GATE.4 (2A), BUS.10
unnamed: AND_GATE.3 (1Y), BRD/ARD_0-3.1 (!A!/B), BRD/ARD_4-7.1 (!A!/B), BRD/ARD_8-11.1 (!A!/B)
unnamed: AND_GATE.6 (2Y), MAR_0-7.11 (CLK), MAR_8-11.11 (CLK)
unnamed: LED1.A, R1.2
unnamed: LED2.A, R2.2
unnamed: LED3.A, R3.2
unnamed: LED4.A, R4.2
unnamed: LED5.A, R5.2
unnamed: LED6.A, R6.2
unnamed: LED7.A, R7.2
unnamed: LED8.A, R8.2
unnamed: LEDPRGM.A, RPRGM.1
unnamed: LEDRUN.A, RRUN.1
unnamed: PRGM_SWITCH.1, RRUN.2
unnamed: LED9.A, R9.2
unnamed: LED10.A, R10.2
unnamed: LED11.A, R11.2
unnamed: LED0.A, R0.2
PRGM: AND_GATE.2 (1B), BUS.17, BUS/PRGM_0-3.1 (!A!/B), BUS/PRGM_4-7.1 (!A!/B), BUS/PRGM_8-11.1 (!A!/B), MAIN_MEMORY.7, PRGM_SWITCH.2, RPRGM.2
R0: BUS/PRGM_0-3.2 (1A), MAR_0-7.2 (1Q)
R1: BUS/PRGM_0-3.5 (2A), MAR_0-7.5 (2Q)
R2: BUS/PRGM_0-3.11 (3A), MAR_0-7.6 (3Q)
R3: BUS/PRGM_0-3.14 (4A), MAR_0-7.9 (4Q)
R4: BUS/PRGM_4-7.2 (1A), MAR_0-7.12 (5Q)
R5: BUS/PRGM_4-7.5 (2A), MAR_0-7.15 (6Q)
R6: BUS/PRGM_4-7.11 (3A), MAR_0-7.16 (7Q)
R7: BUS/PRGM_4-7.14 (4A), MAR_0-7.19 (8Q)
R8: BUS/PRGM_8-11.2 (1A), MAR_8-11.2 (1Q)
R9: BUS/PRGM_8-11.5 (2A), MAR_8-11.5 (2Q)
R10: BUS/PRGM_8-11.11 (3A), MAR_8-11.6 (3Q)
R11: BUS/PRGM_8-11.14 (4A), MAR_8-11.9 (4Q)
VCC: AND_GATE.14 (VCC), BRD/ARD_0-3.16 (VCC), BRD/ARD_4-7.16 (VCC), BRD/ARD_8-11.16 (VCC), BUS.12, BUS/PRGM_0-3.16 (VCC), BUS/PRGM_4-7.16 (VCC), BUS/PRGM_8-11.16 (VCC), C1.2, C2.2, C3.2, C4.2, DIP_0-7.1, DIP_0-7.2, DIP_0-7.3, DIP_0-7.4, DIP_0-7.5, DIP_0-7.6, DIP_0-7.7, DIP_0-7.8, DIP_8-11.1, DIP_8-11.2, DIP_8-11.3, DIP_8-11.4, MAR_0-7.20 (VCC), MAR_8-11.20 (VCC), PRGM_SWITCH.3 (COM_1)

Notes on the sheet:
Note: PRGM is used as HLT to stop the clock when in prgm mode

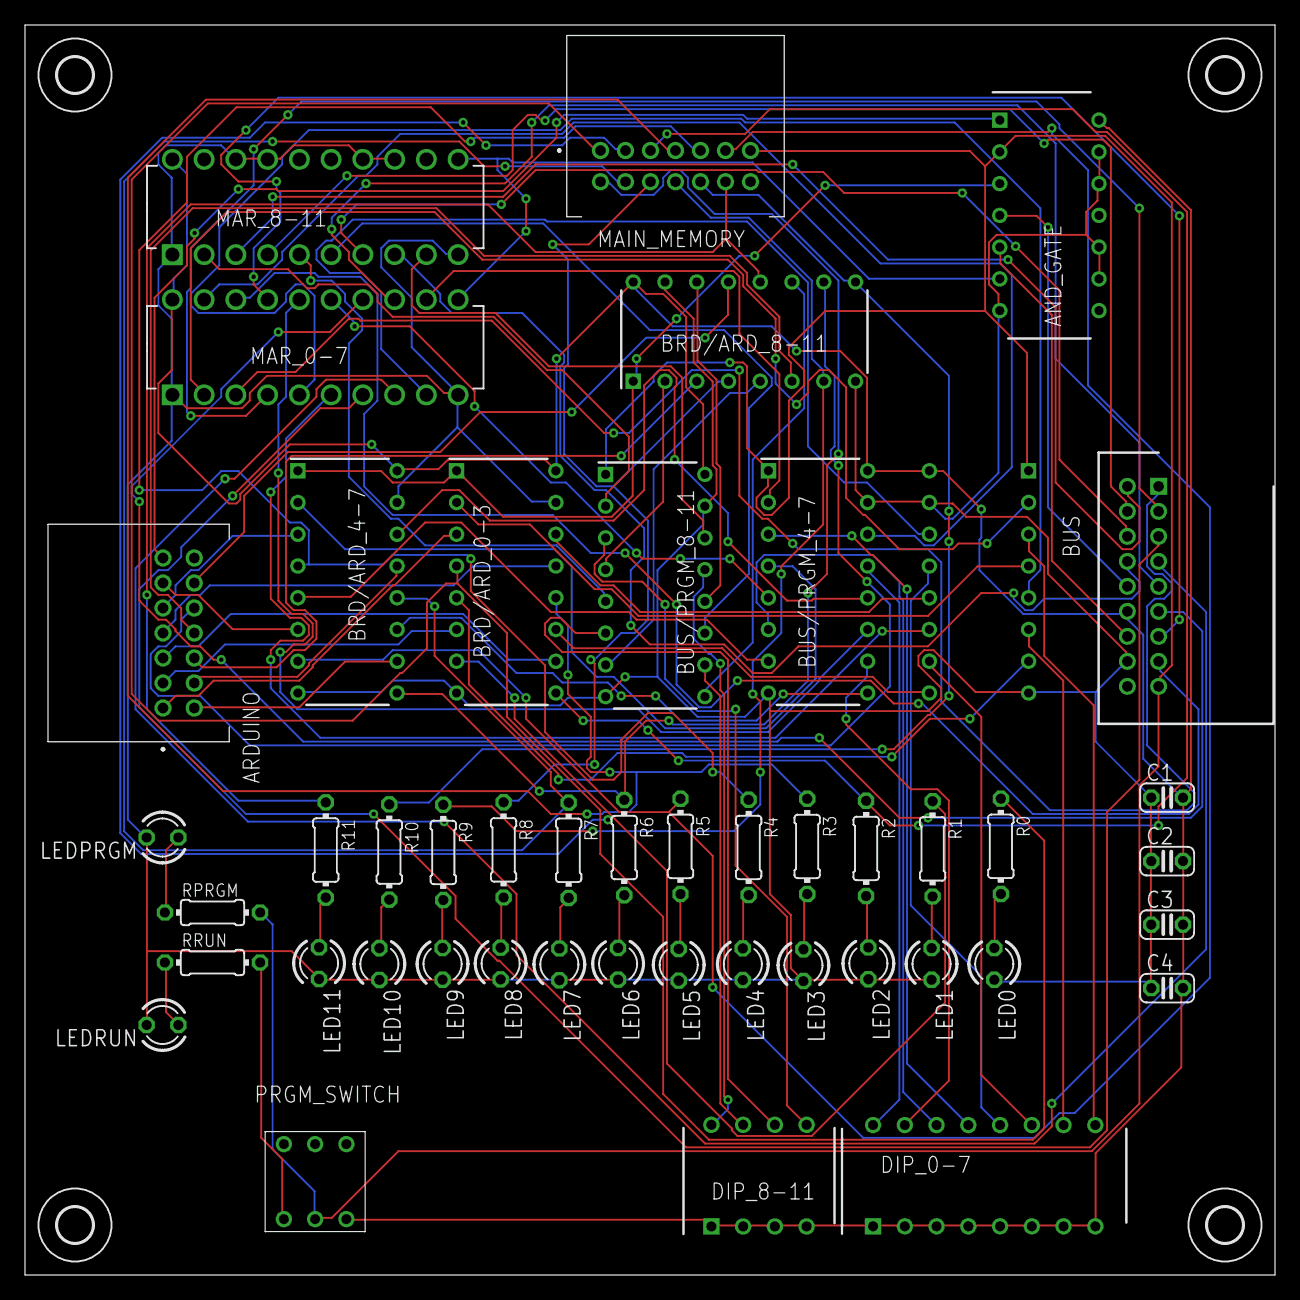
[picture p11: board MAR.brd from above]

Board: 2 copper layers, 100.0 x 100.0 mm, 51 parts (1 on the bottom side), 95 nets.

Other parts of the board:
U$1, U$2, U$3, U$4: 2,8
