richardb1998/MARIEPC/Eagle/Instruction Register/IR.brd

## EAGLE design Eagle/Instruction Register/IR.brd (2020-02-25)

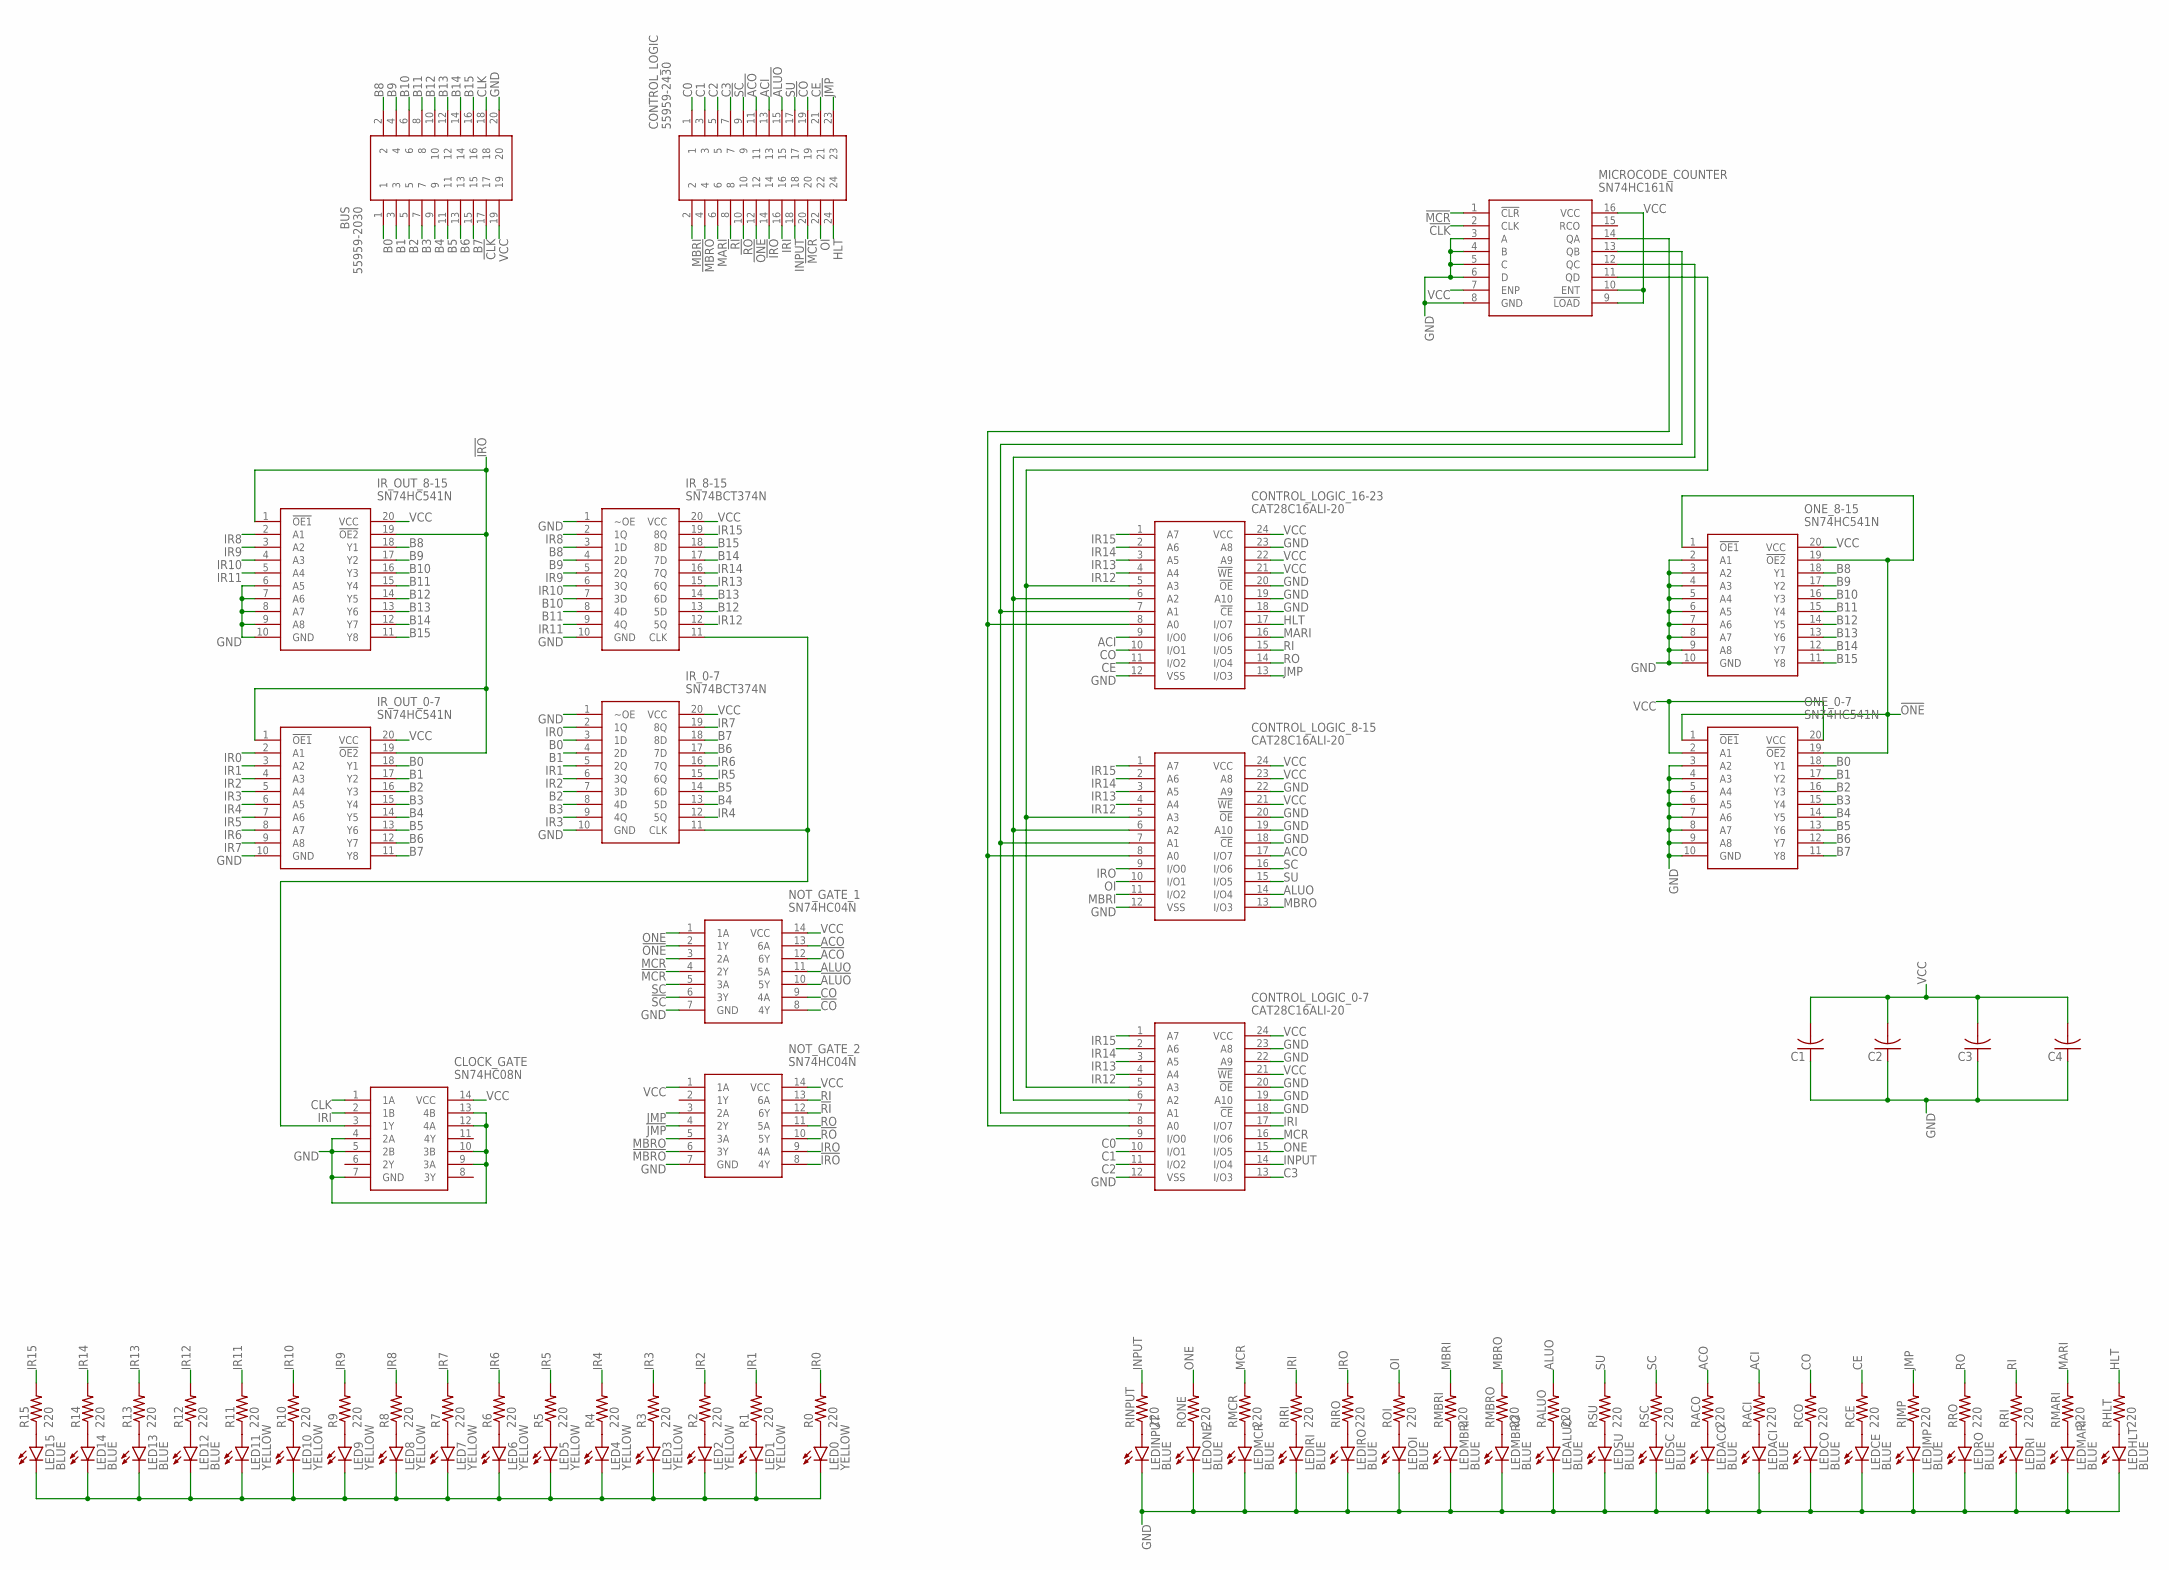
[picture p12: schematic IR.sch]

Parts:
BUS: 55959-2030; 55959-2030_1
C1, C2, C3, C4: C-US025-024X044; C025-024X044
CLOCK_GATE: SN74HC08N; DIP794W53P254L1930H508Q14N
CONTROL_LOGIC: 55959-2430; 559592430
CONTROL_LOGIC_0-7, CONTROL_LOGIC_8-15, CONTROL_LOGIC_16-23: CAT28C16ALI-20; DIP1651W55P254L3188H635Q24N
IR_0-7, IR_8-15: SN74BCT374N; DIP254P762X508-20
IR_OUT_0-7, IR_OUT_8-15: SN74HC541N; DIP794W53P254L2540H508Q20N
LED0, LED1, LED2, LED3, LED4, LED5, LED6, LED7, LED8, LED9, LED10, LED11: YELLOW; LED3MM
LED12, LED13, LED14, LED15: BLUE; LED3MM
LEDACI: BLUE; LED3MM
LEDACO: BLUE; LED3MM
LEDALUO: BLUE; LED3MM
LEDCE: BLUE; LED3MM
LEDCO: BLUE; LED3MM
LEDHLT: BLUE; LED3MM
LEDINPUT: BLUE; LED3MM
LEDIRI: BLUE; LED3MM
LEDIRO: BLUE; LED3MM
LEDJMP: BLUE; LED3MM
LEDMARI: BLUE; LED3MM
LEDMBRI: BLUE; LED3MM
LEDMBRO: BLUE; LED3MM
LEDMCR: BLUE; LED3MM
LEDOI: BLUE; LED3MM
LEDONE: BLUE; LED3MM
LEDRI: BLUE; LED3MM
LEDRO: BLUE; LED3MM
LEDSC: BLUE; LED3MM
LEDSU: BLUE; LED3MM
MICROCODE_COUNTER: SN74HC161N; DIP794W53P254L1930H508Q16N
NOT_GATE_1, NOT_GATE_2: SN74HC04N; DIP794W53P254L1930H508Q14N
ONE_0-7, ONE_8-15: SN74HC541N; DIP794W53P254L2540H508Q20N
R0, R1, R2, R3, R4, R5, R6, R7, R8, R9, R10, R11, R12, R13, R14, R15: 220; 0204/7
RACI: 220; 0204/7
RACO: 220; 0204/7
RALUO: 220; 0204/7
RCE: 220; 0204/7
RCO: 220; 0204/7
RHLT: 220; 0204/7
RINPUT: 220; 0204/7
RIRI: 220; 0204/7
RIRO: 220; 0204/7
RJMP: 220; 0204/7
RMARI: 220; 0204/7
RMBRI: 220; 0204/7
RMBRO: 220; 0204/7
RMCR: 220; 0204/7
ROI: 220; 0204/7
RONE: 220; 0204/7
RRI: 220; 0204/7
RRO: 220; 0204/7
RSC: 220; 0204/7
RSU: 220; 0204/7

Connections:
!ACO: CONTROL_LOGIC.11, NOT_GATE_1.12 (6Y)
!ALUO: CONTROL_LOGIC.15, NOT_GATE_1.10 (5Y)
!CLK: BUS.17, MICROCODE_COUNTER.2 (CLK)
!CO: CONTROL_LOGIC.19, NOT_GATE_1.8 (4Y)
!IRO: CONTROL_LOGIC.14, IR_OUT_0-7.1 (!OE1), IR_OUT_0-7.19 (!OE2), IR_OUT_8-15.1 (!OE1), IR_OUT_8-15.19 (!OE2), NOT_GATE_2.8 (4Y)
!JMP: CONTROL_LOGIC.23, NOT_GATE_2.4 (2Y)
!MBRO: CONTROL_LOGIC.4, NOT_GATE_2.6 (3Y)
!MCR: CONTROL_LOGIC.20, MICROCODE_COUNTER.1 (!CLR), NOT_GATE_1.4 (2Y)
!ONE: CONTROL_LOGIC.12, NOT_GATE_1.2 (1Y), ONE_0-7.1 (!OE1), ONE_0-7.19 (!OE2), ONE_8-15.1 (!OE1), ONE_8-15.19 (!OE2)
!RI: CONTROL_LOGIC.8, NOT_GATE_2.12 (6Y)
!RO: CONTROL_LOGIC.10, NOT_GATE_2.10 (5Y)
!SC: CONTROL_LOGIC.9, NOT_GATE_1.6 (3Y)
ACI: CONTROL_LOGIC.13, CONTROL_LOGIC_16-23.9 (I/O0), RACI.2
ACO: CONTROL_LOGIC_8-15.17 (I/O7), NOT_GATE_1.13 (6A), RACO.2
ALUO: CONTROL_LOGIC_8-15.14 (I/O4), NOT_GATE_1.11 (5A), RALUO.2
B0: BUS.1, IR_0-7.3 (1D), IR_OUT_0-7.18 (Y1), ONE_0-7.18 (Y1)
B1: BUS.3, IR_0-7.4 (2D), IR_OUT_0-7.17 (Y2), ONE_0-7.17 (Y2)
B2: BUS.5, IR_0-7.7 (3D), IR_OUT_0-7.16 (Y3), ONE_0-7.16 (Y3)
B3: BUS.7, IR_0-7.8 (4D), IR_OUT_0-7.15 (Y4), ONE_0-7.15 (Y4)
B4: BUS.9, IR_0-7.13 (5D), IR_OUT_0-7.14 (Y5), ONE_0-7.14 (Y5)
B5: BUS.11, IR_0-7.14 (6D), IR_OUT_0-7.13 (Y6), ONE_0-7.13 (Y6)
B6: BUS.13, IR_0-7.17 (7D), IR_OUT_0-7.12 (Y7), ONE_0-7.12 (Y7)
B7: BUS.15, IR_0-7.18 (8D), IR_OUT_0-7.11 (Y8), ONE_0-7.11 (Y8)
B8: BUS.2, IR_8-15.3 (1D), IR_OUT_8-15.18 (Y1), ONE_8-15.18 (Y1)
B9: BUS.4, IR_8-15.4 (2D), IR_OUT_8-15.17 (Y2), ONE_8-15.17 (Y2)
B10: BUS.6, IR_8-15.7 (3D), IR_OUT_8-15.16 (Y3), ONE_8-15.16 (Y3)
B11: BUS.8, IR_8-15.8 (4D), IR_OUT_8-15.15 (Y4), ONE_8-15.15 (Y4)
B12: BUS.10, IR_8-15.13 (5D), IR_OUT_8-15.14 (Y5), ONE_8-15.14 (Y5)
B13: BUS.12, IR_8-15.14 (6D), IR_OUT_8-15.13 (Y6), ONE_8-15.13 (Y6)
B14: BUS.14, IR_8-15.17 (7D), IR_OUT_8-15.12 (Y7), ONE_8-15.12 (Y7)
B15: BUS.16, IR_8-15.18 (8D), IR_OUT_8-15.11 (Y8), ONE_8-15.11 (Y8)
C0: CONTROL_LOGIC.1, CONTROL_LOGIC_0-7.9 (I/O0)
C1: CONTROL_LOGIC.3, CONTROL_LOGIC_0-7.10 (I/O1)
C2: CONTROL_LOGIC.5, CONTROL_LOGIC_0-7.11 (I/O2)
C3: CONTROL_LOGIC.7, CONTROL_LOGIC_0-7.13 (I/O3)
CE: CONTROL_LOGIC.21, CONTROL_LOGIC_16-23.11 (I/O2), RCE.2
CLK: BUS.18, CLOCK_GATE.1 (1A)
CO: CONTROL_LOGIC_16-23.10 (I/O1), NOT_GATE_1.9 (4A), RCO.2
GND: BUS.20, C1.1, C2.1, C3.1, C4.1, CLOCK_GATE.4 (2A), CLOCK_GATE.5 (2B), CLOCK_GATE.7 (GND), CLOCK_GATE.9 (3A), CLOCK_GATE.10 (3B), CLOCK_GATE.12 (4A), CLOCK_GATE.13 (4B), CONTROL_LOGIC_0-7.12 (VSS), CONTROL_LOGIC_0-7.18 (!CE), CONTROL_LOGIC_0-7.19 (A10), CONTROL_LOGIC_0-7.20 (!OE), CONTROL_LOGIC_0-7.22 (A9), CONTROL_LOGIC_0-7.23 (A8), CONTROL_LOGIC_8-15.12 (VSS), CONTROL_LOGIC_8-15.18 (!CE), CONTROL_LOGIC_8-15.19 (A10), CONTROL_LOGIC_8-15.20 (!OE), CONTROL_LOGIC_8-15.22 (A9), CONTROL_LOGIC_16-23.12 (VSS), CONTROL_LOGIC_16-23.18 (!CE), CONTROL_LOGIC_16-23.19 (A10), CONTROL_LOGIC_16-23.20 (!OE), CONTROL_LOGIC_16-23.23 (A8), IR_0-7.1 (~OE), IR_0-7.10 (GND), IR_8-15.1 (~OE), IR_8-15.10 (GND), IR_OUT_0-7.10 (GND), IR_OUT_8-15.6 (A5), IR_OUT_8-15.7 (A6), IR_OUT_8-15.8 (A7), IR_OUT_8-15.9 (A8), IR_OUT_8-15.10 (GND), LEDACI.K (C), LEDACO.K (C), LEDALUO.K (C), LEDCE.K (C), LEDCO.K (C), LEDHLT.K (C), LEDINPUT.K (C), LEDIRI.K (C), LEDIRO.K (C), LEDJMP.K (C), LEDMARI.K (C), LEDMBRI.K (C), LEDMBRO.K (C), LEDMCR.K (C), LEDOI.K (C), LEDONE.K (C), LEDRI.K (C), LEDRO.K (C), LEDSC.K (C), LEDSU.K (C), MICROCODE_COUNTER.3 (A), MICROCODE_COUNTER.4 (B), MICROCODE_COUNTER.5 (C), MICROCODE_COUNTER.6 (D), MICROCODE_COUNTER.8 (GND), NOT_GATE_1.7 (GND), NOT_GATE_2.7 (GND), ONE_0-7.3 (A2), ONE_0-7.4 (A3), ONE_0-7.5 (A4), ONE_0-7.6 (A5), ONE_0-7.7 (A6), ONE_0-7.8 (A7), ONE_0-7.9 (A8), ONE_0-7.10 (GND), ONE_8-15.2 (A1), ONE_8-15.3 (A2), ONE_8-15.4 (A3), ONE_8-15.5 (A4), ONE_8-15.6 (A5), ONE_8-15.7 (A6), ONE_8-15.8 (A7), ONE_8-15.9 (A8), ONE_8-15.10 (GND)
HLT: CONTROL_LOGIC.24, CONTROL_LOGIC_16-23.17 (I/O7), RHLT.2
INPUT: CONTROL_LOGIC.18, CONTROL_LOGIC_0-7.14 (I/O4), RINPUT.2
IR0: IR_0-7.2 (1Q), IR_OUT_0-7.2 (A1), R0.2
IR1: IR_0-7.5 (2Q), IR_OUT_0-7.3 (A2), R1.2
IR2: IR_0-7.6 (3Q), IR_OUT_0-7.4 (A3), R2.2
IR3: IR_0-7.9 (4Q), IR_OUT_0-7.5 (A4), R3.2
IR4: IR_0-7.12 (5Q), IR_OUT_0-7.6 (A5), R4.2
IR5: IR_0-7.15 (6Q), IR_OUT_0-7.7 (A6), R5.2
IR6: IR_0-7.16 (7Q), IR_OUT_0-7.8 (A7), R6.2
IR7: IR_0-7.19 (8Q), IR_OUT_0-7.9 (A8), R7.2
IR8: IR_8-15.2 (1Q), IR_OUT_8-15.2 (A1), R8.2
IR9: IR_8-15.5 (2Q), IR_OUT_8-15.3 (A2), R9.2
IR10: IR_8-15.6 (3Q), IR_OUT_8-15.4 (A3), R10.2
IR11: IR_8-15.9 (4Q), IR_OUT_8-15.5 (A4), R11.2
IR12: CONTROL_LOGIC_0-7.4 (A4), CONTROL_LOGIC_8-15.4 (A4), CONTROL_LOGIC_16-23.4 (A4), IR_8-15.12 (5Q), R12.2
IR13: CONTROL_LOGIC_0-7.3 (A5), CONTROL_LOGIC_8-15.3 (A5), CONTROL_LOGIC_16-23.3 (A5), IR_8-15.15 (6Q), R13.2
IR14: CONTROL_LOGIC_0-7.2 (A6), CONTROL_LOGIC_8-15.2 (A6), CONTROL_LOGIC_16-23.2 (A6), IR_8-15.16 (7Q), R14.2
IR15: CONTROL_LOGIC_0-7.1 (A7), CONTROL_LOGIC_8-15.1 (A7), CONTROL_LOGIC_16-23.1 (A7), IR_8-15.19 (8Q), R15.2
IRI: CLOCK_GATE.2 (1B), CONTROL_LOGIC.16, CONTROL_LOGIC_0-7.17 (I/O7), RIRI.2
IRO: CONTROL_LOGIC_8-15.9 (I/O0), NOT_GATE_2.9 (4A), RIRO.2
JMP: CONTROL_LOGIC_16-23.13 (I/O3), NOT_GATE_2.3 (2A), RJMP.2
MARI: CONTROL_LOGIC.6, CONTROL_LOGIC_16-23.16 (I/O6), RMARI.2
MBRI: CONTROL_LOGIC.2, CONTROL_LOGIC_8-15.11 (I/O2), RMBRI.2
MBRO: CONTROL_LOGIC_8-15.13 (I/O3), NOT_GATE_2.5 (3A), RMBRO.2
MCR: CONTROL_LOGIC_0-7.16 (I/O6), NOT_GATE_1.3 (2A), RMCR.2
unnamed: CONTROL_LOGIC_0-7.8 (A0), CONTROL_LOGIC_8-15.8 (A0), CONTROL_LOGIC_16-23.8 (A0), MICROCODE_COUNTER.14 (QA)
unnamed: CONTROL_LOGIC_0-7.7 (A1), CONTROL_LOGIC_8-15.7 (A1), CONTROL_LOGIC_16-23.7 (A1), MICROCODE_COUNTER.13 (QB)
unnamed: CONTROL_LOGIC_0-7.6 (A2), CONTROL_LOGIC_8-15.6 (A2), CONTROL_LOGIC_16-23.6 (A2), MICROCODE_COUNTER.12 (QC)
unnamed: CONTROL_LOGIC_0-7.5 (A3), CONTROL_LOGIC_8-15.5 (A3), CONTROL_LOGIC_16-23.5 (A3), MICROCODE_COUNTER.11 (QD)
unnamed: LEDINPUT.A, RINPUT.1
unnamed: LEDONE.A, RONE.1
unnamed: LEDMCR.A, RMCR.1
unnamed: LEDIRI.A, RIRI.1
unnamed: LEDIRO.A, RIRO.1
unnamed: LEDOI.A, ROI.1
unnamed: LEDMBRI.A, RMBRI.1
unnamed: LEDALUO.A, RALUO.1
unnamed: LEDSU.A, RSU.1
unnamed: LEDSC.A, RSC.1
unnamed: LEDCO.A, RCO.1
unnamed: LEDJMP.A, RJMP.1
unnamed: LEDRO.A, RRO.1
unnamed: LEDRI.A, RRI.1
unnamed: LEDMARI.A, RMARI.1
unnamed: LEDMBRO.A, RMBRO.1
unnamed: LEDACO.A, RACO.1
unnamed: LEDACI.A, RACI.1
unnamed: LEDCE.A, RCE.1
unnamed: LEDHLT.A, RHLT.1
unnamed: LED1.A, R1.1
unnamed: LED2.A, R2.1
unnamed: LED3.A, R3.1
unnamed: LED4.A, R4.1
unnamed: LED5.A, R5.1
unnamed: LED6.A, R6.1
unnamed: LED7.A, R7.1
unnamed: LED8.A, R8.1
unnamed: CLOCK_GATE.3 (1Y), IR_0-7.11 (CLK), IR_8-15.11 (CLK)
unnamed: LED9.A, R9.1
unnamed: LED10.A, R10.1
unnamed: LED11.A, R11.1
unnamed: LED12.A, R12.1
unnamed: LED13.A, R13.1
unnamed: LED14.A, R14.1
unnamed: LED15.A, R15.1
unnamed: LED0.A, R0.1
unnamed: LED0.K (C), LED1.K (C), LED2.K (C), LED3.K (C), LED4.K (C), LED5.K (C), LED6.K (C), LED7.K (C), LED8.K (C), LED9.K (C), LED10.K (C), LED11.K (C), LED12.K (C), LED13.K (C), LED14.K (C), LED15.K (C)
OI: CONTROL_LOGIC.22, CONTROL_LOGIC_8-15.10 (I/O1), ROI.2
ONE: CONTROL_LOGIC_0-7.15 (I/O5), NOT_GATE_1.1 (1A), RONE.2
RI: CONTROL_LOGIC_16-23.15 (I/O5), NOT_GATE_2.13 (6A), RRI.2
RO: CONTROL_LOGIC_16-23.14 (I/O4), NOT_GATE_2.11 (5A), RRO.2
SC: CONTROL_LOGIC_8-15.16 (I/O6), NOT_GATE_1.5 (3A), RSC.2
SU: CONTROL_LOGIC.17, CONTROL_LOGIC_8-15.15 (I/O5), RSU.2
VCC: BUS.19, C1.2, C2.2, C3.2, C4.2, CLOCK_GATE.14 (VCC), CONTROL_LOGIC_0-7.21 (!WE), CONTROL_LOGIC_0-7.24 (VCC), CONTROL_LOGIC_8-15.21 (!WE), CONTROL_LOGIC_8-15.23 (A8), CONTROL_LOGIC_8-15.24 (VCC), CONTROL_LOGIC_16-23.21 (!WE), CONTROL_LOGIC_16-23.22 (A9), CONTROL_LOGIC_16-23.24 (VCC), IR_0-7.20 (VCC), IR_8-15.20 (VCC), IR_OUT_0-7.20 (VCC), IR_OUT_8-15.20 (VCC), MICROCODE_COUNTER.7 (ENP), MICROCODE_COUNTER.9 (!LOAD), MICROCODE_COUNTER.10 (ENT), MICROCODE_COUNTER.16 (VCC), NOT_GATE_1.14 (VCC), NOT_GATE_2.1 (1A), NOT_GATE_2.14 (VCC), ONE_0-7.2 (A1), ONE_0-7.20 (VCC), ONE_8-15.20 (VCC)

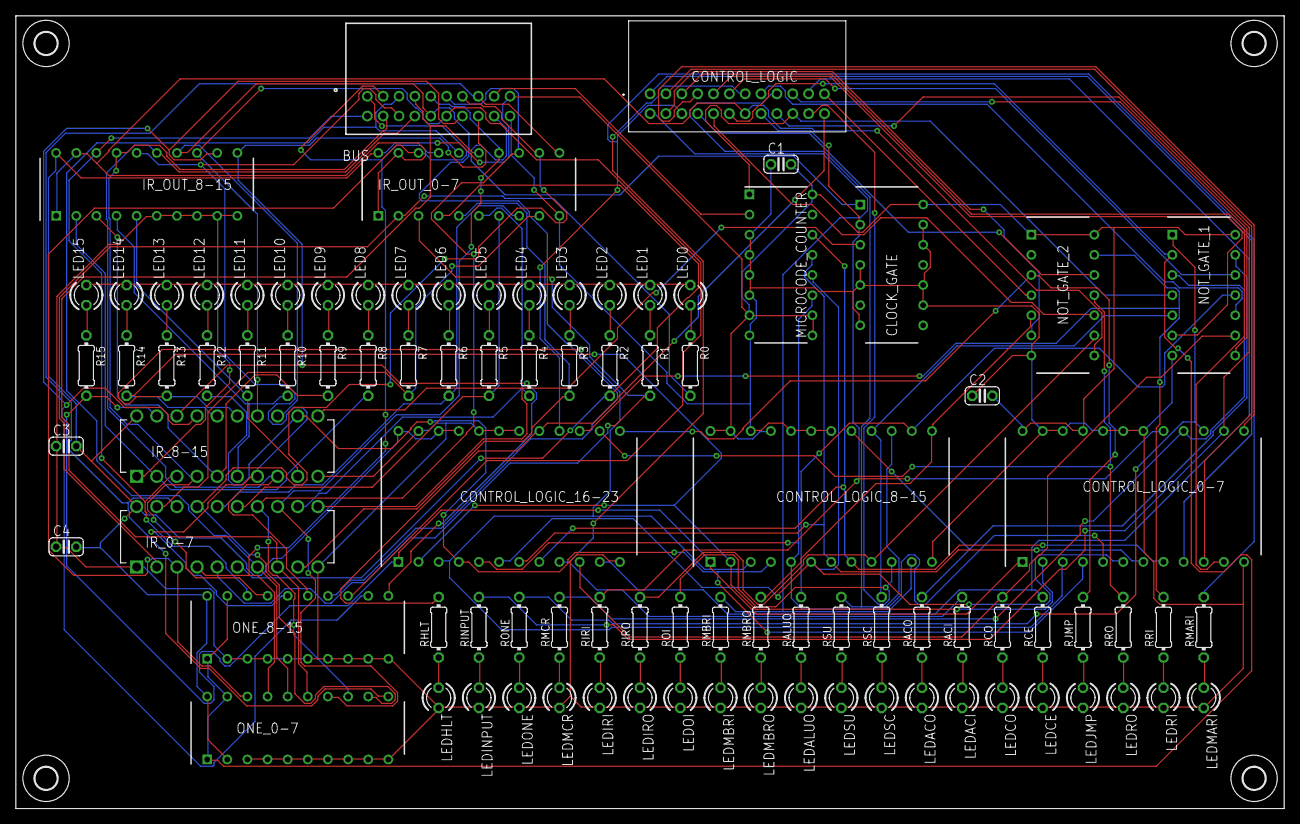
[picture p13: board IR.brd from above]

Board: 2 copper layers, 160.0 x 100.0 mm, 95 parts (0 on the bottom side), 113 nets.

Other parts of the board:
U$1, U$2, U$3, U$4: 2,8
