richardb1998/MARIEPC/Eagle/BUS/BUS.brd

## EAGLE design Eagle/BUS/BUS.brd (2020-02-25)

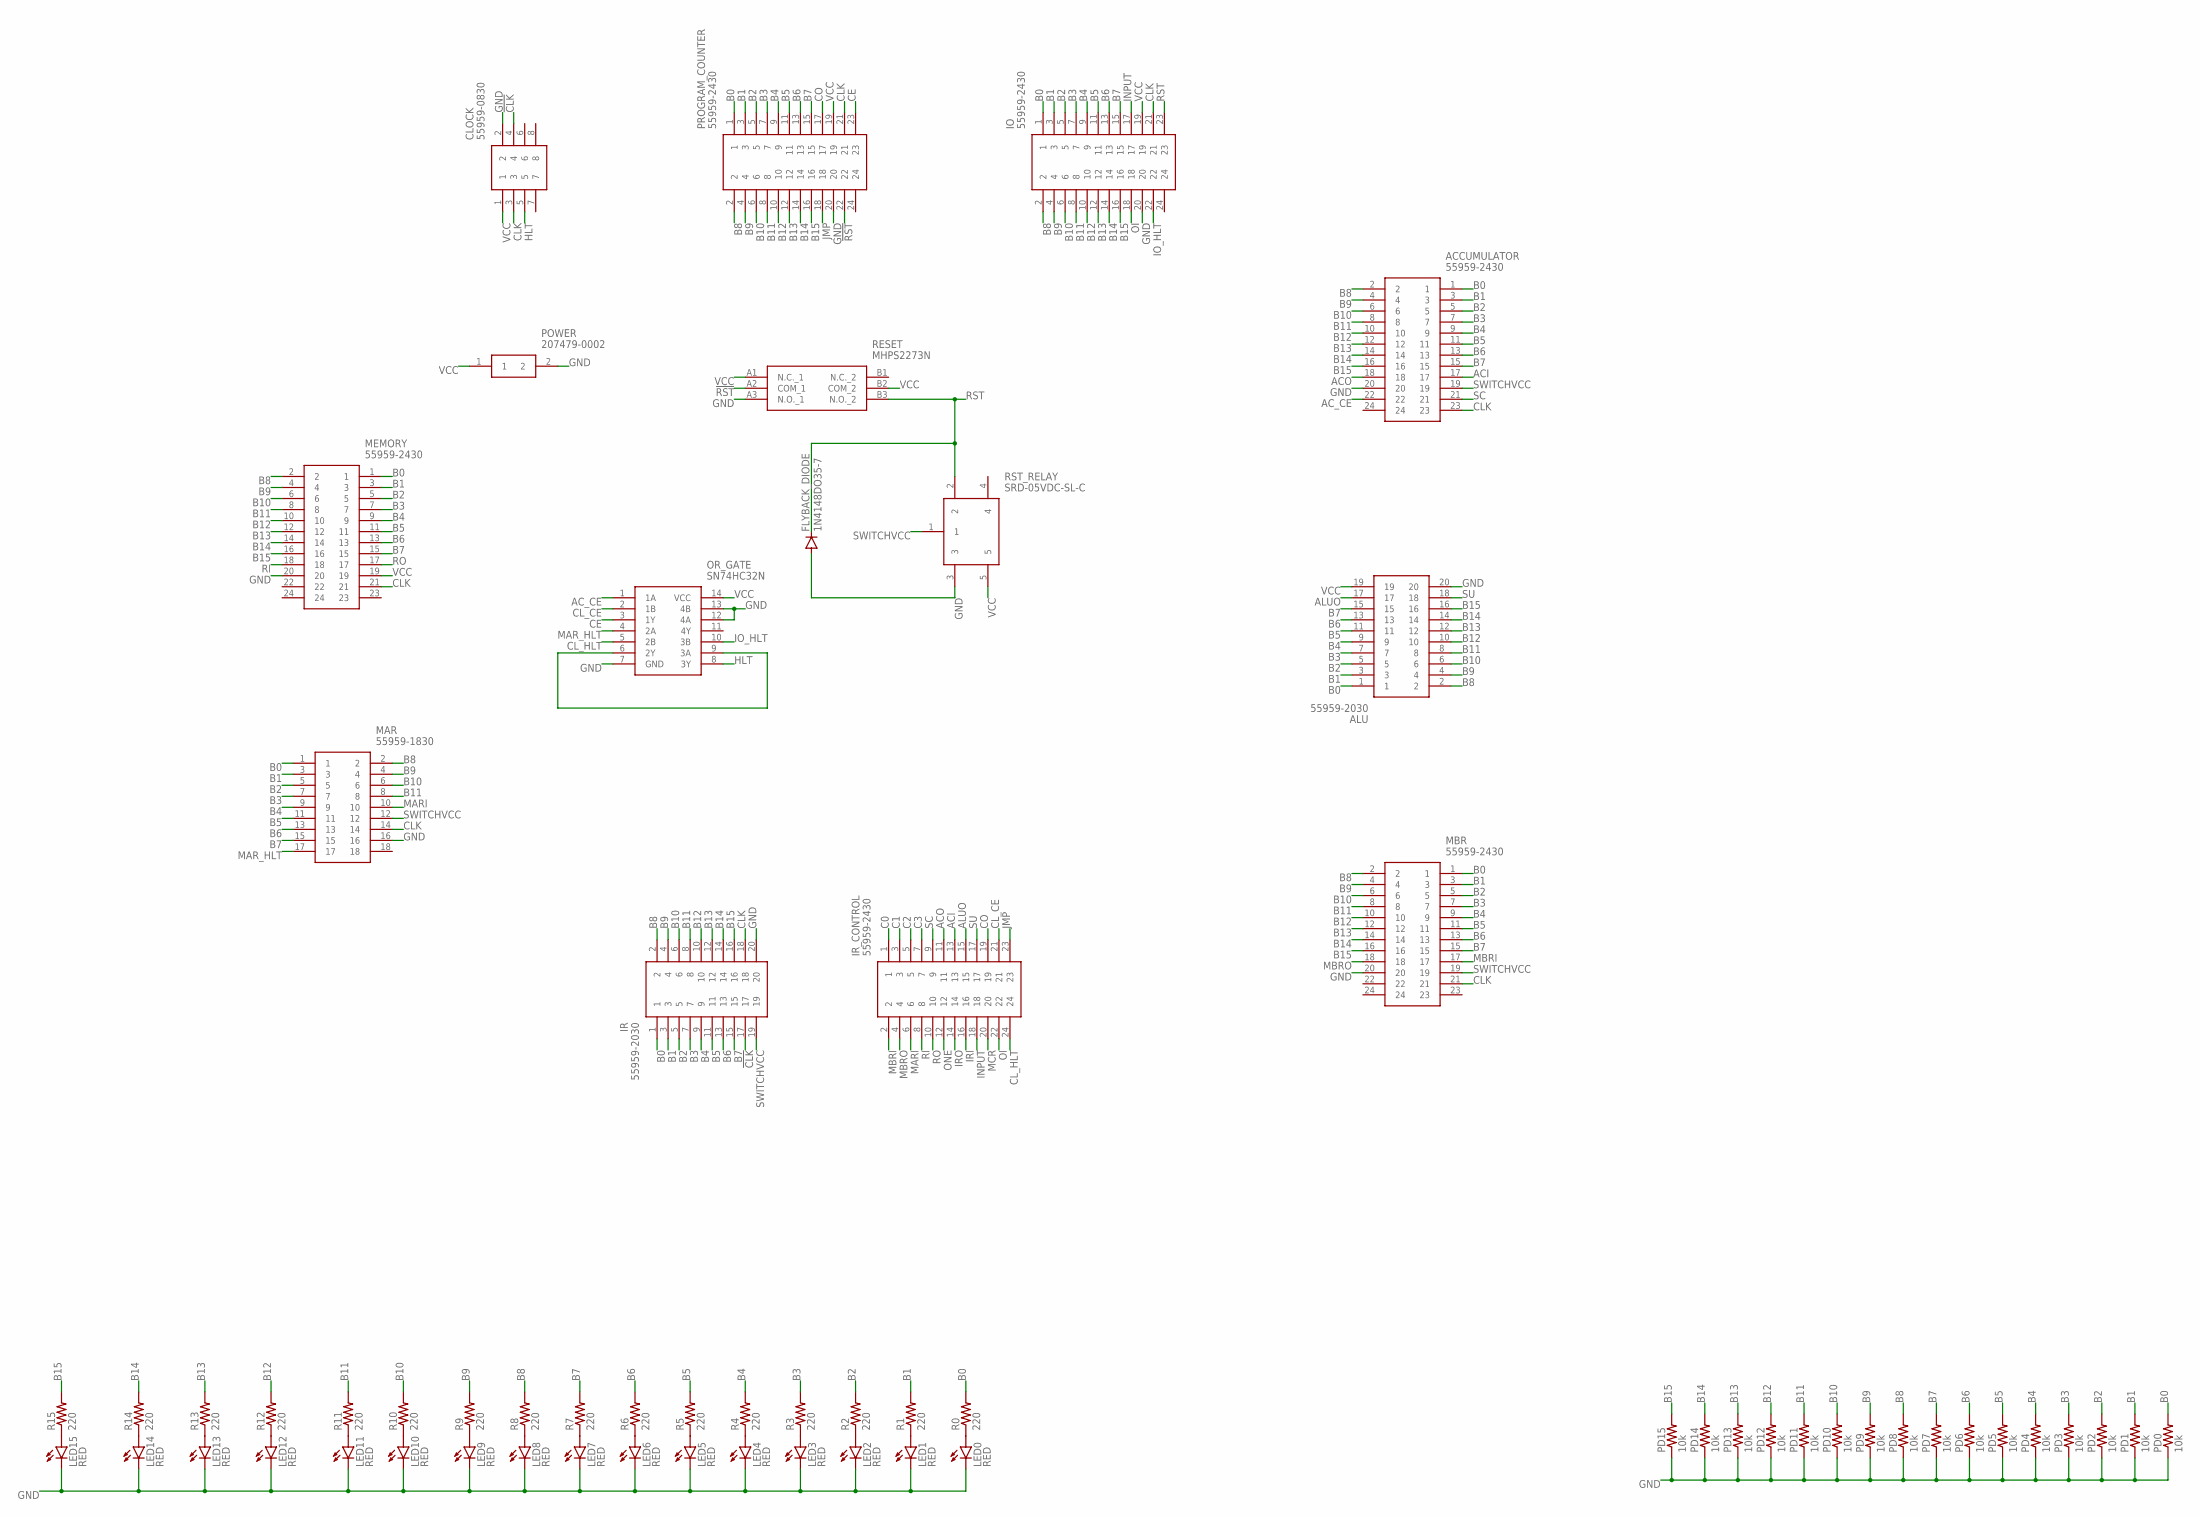
[picture p14: schematic BUS.sch]

Parts:
ACCUMULATOR: 55959-2430; 559592430
ALU: 55959-2030; 55959-2030_1
CLOCK: 55959-0830; SHDR8W65P250X200_2X4_1140X1400
FLYBACK_DIODE: 1N4148DO35-7; DO35-7
IO: 55959-2430; 559592430
IR: 55959-2030; 55959-2030_1
IR_CONTROL: 55959-2430; 559592430
LED0, LED1, LED2, LED3, LED4, LED5, LED6, LED7, LED8, LED9, LED10, LED11, LED12, LED13, LED14, LED15: RED; LED3MM
MAR: 55959-1830; SHDR18W65P250X200_2X9_2140X140
MBR: 55959-2430; 559592430
MEMORY: 55959-2430; 559592430
OR_GATE: SN74HC32N; DIP794W53P254L1930H508Q14N
PD0, PD1, PD2, PD3, PD4, PD5, PD6, PD7, PD8, PD9, PD10, PD11, PD12, PD13, PD14, PD15: 10k; 0204/7
POWER: 207479-0002; 2074790002
PROGRAM_COUNTER: 55959-2430; 559592430
R0, R1, R2, R3, R4, R5, R6, R7, R8, R9, R10, R11, R12, R13, R14, R15: 220; 0204/7
RESET: MHPS2273N
RST_RELAY: SRD-05VDC-SL-C; SRD

Connections:
!CLK: CLOCK.4, IR.17
!RST: PROGRAM_COUNTER.22, RESET.A2 (COM_1)
ACI: ACCUMULATOR.17, IR_CONTROL.13
ACO: ACCUMULATOR.18, IR_CONTROL.11
AC_CE: ACCUMULATOR.22, OR_GATE.1 (1A)
ALUO: ALU.17, IR_CONTROL.15
B0: ACCUMULATOR.1, ALU.1, IO.1, IR.1, MAR.1, MBR.1, MEMORY.1, PD0.2, PROGRAM_COUNTER.1, R0.2
B1: ACCUMULATOR.3, ALU.3, IO.3, IR.3, MAR.3, MBR.3, MEMORY.3, PD1.2, PROGRAM_COUNTER.3, R1.2
B2: ACCUMULATOR.5, ALU.5, IO.5, IR.5, MAR.5, MBR.5, MEMORY.5, PD2.2, PROGRAM_COUNTER.5, R2.2
B3: ACCUMULATOR.7, ALU.7, IO.7, IR.7, MAR.7, MBR.7, MEMORY.7, PD3.2, PROGRAM_COUNTER.7, R3.2
B4: ACCUMULATOR.9, ALU.9, IO.9, IR.9, MAR.9, MBR.9, MEMORY.9, PD4.2, PROGRAM_COUNTER.9, R4.2
B5: ACCUMULATOR.11, ALU.11, IO.11, IR.11, MAR.11, MBR.11, MEMORY.11, PD5.2, PROGRAM_COUNTER.11, R5.2
B6: ACCUMULATOR.13, ALU.13, IO.13, IR.13, MAR.13, MBR.13, MEMORY.13, PD6.2, PROGRAM_COUNTER.13, R6.2
B7: ACCUMULATOR.15, ALU.15, IO.15, IR.15, MAR.15, MBR.15, MEMORY.15, PD7.2, PROGRAM_COUNTER.15, R7.2
B8: ACCUMULATOR.2, ALU.2, IO.2, IR.2, MAR.2, MBR.2, MEMORY.2, PD8.2, PROGRAM_COUNTER.2, R8.2
B9: ACCUMULATOR.4, ALU.4, IO.4, IR.4, MAR.4, MBR.4, MEMORY.4, PD9.2, PROGRAM_COUNTER.4, R9.2
B10: ACCUMULATOR.6, ALU.6, IO.6, IR.6, MAR.6, MBR.6, MEMORY.6, PD10.2, PROGRAM_COUNTER.6, R10.2
B11: ACCUMULATOR.8, ALU.8, IO.8, IR.8, MAR.8, MBR.8, MEMORY.8, PD11.2, PROGRAM_COUNTER.8, R11.2
B12: ACCUMULATOR.10, ALU.10, IO.10, IR.10, MBR.10, MEMORY.10, PD12.2, PROGRAM_COUNTER.10, R12.2
B13: ACCUMULATOR.12, ALU.12, IO.12, IR.12, MBR.12, MEMORY.12, PD13.2, PROGRAM_COUNTER.12, R13.2
B14: ACCUMULATOR.14, ALU.14, IO.14, IR.14, MBR.14, MEMORY.14, PD14.2, PROGRAM_COUNTER.14, R14.2
B15: ACCUMULATOR.16, ALU.16, IO.16, IR.16, MBR.16, MEMORY.16, PD15.2, PROGRAM_COUNTER.16, R15.2
C0: IR_CONTROL.1
C1: IR_CONTROL.3
C2: IR_CONTROL.5
C3: IR_CONTROL.7
CE: OR_GATE.3 (1Y), PROGRAM_COUNTER.23
CLK: ACCUMULATOR.23, CLOCK.3, IO.21, IR.18, MAR.14, MBR.21, MEMORY.21, PROGRAM_COUNTER.21
CL_CE: IR_CONTROL.21, OR_GATE.2 (1B)
CL_HLT: IR_CONTROL.24, OR_GATE.5 (2B)
CO: IR_CONTROL.19, PROGRAM_COUNTER.17
GND: ACCUMULATOR.20, ALU.20, CLOCK.2, FLYBACK_DIODE.A, IO.20, IR.20, LED0.K (C), LED1.K (C), LED2.K (C), LED3.K (C), LED4.K (C), LED5.K (C), LED6.K (C), LED7.K (C), LED8.K (C), LED9.K (C), LED10.K (C), LED11.K (C), LED12.K (C), LED13.K (C), LED14.K (C), LED15.K (C), MAR.16, MBR.20, MEMORY.20, OR_GATE.7 (GND), OR_GATE.12 (4A), OR_GATE.13 (4B), PD0.1, PD1.1, PD2.1, PD3.1, PD4.1, PD5.1, PD6.1, PD7.1, PD8.1, PD9.1, PD10.1, PD11.1, PD12.1, PD13.1, PD14.1, PD15.1, POWER.2, PROGRAM_COUNTER.20, RESET.A3 (N.O._1), RST_RELAY.3
HLT: CLOCK.5, OR_GATE.8 (3Y)
INPUT: IO.17, IR_CONTROL.18
IO_HLT: IO.22, OR_GATE.10 (3B)
IRI: IR_CONTROL.16
IRO: IR_CONTROL.14
JMP: IR_CONTROL.23, PROGRAM_COUNTER.18
MARI: IR_CONTROL.6, MAR.10
MAR_HLT: MAR.17, OR_GATE.4 (2A)
MBRI: IR_CONTROL.2, MBR.17
MBRO: IR_CONTROL.4, MBR.18
MCR: IR_CONTROL.20
unnamed: LED1.A, R1.1
unnamed: LED2.A, R2.1
unnamed: LED3.A, R3.1
unnamed: LED4.A, R4.1
unnamed: LED5.A, R5.1
unnamed: LED6.A, R6.1
unnamed: LED7.A, R7.1
unnamed: LED8.A, R8.1
unnamed: OR_GATE.6 (2Y), OR_GATE.9 (3A)
unnamed: LED9.A, R9.1
unnamed: LED10.A, R10.1
unnamed: LED11.A, R11.1
unnamed: LED12.A, R12.1
unnamed: LED13.A, R13.1
unnamed: LED14.A, R14.1
unnamed: LED15.A, R15.1
unnamed: LED0.A, R0.1
OI: IO.18, IR_CONTROL.22
ONE: IR_CONTROL.12
RI: IR_CONTROL.8, MEMORY.18
RO: IR_CONTROL.10, MEMORY.17
RST: FLYBACK_DIODE.C, IO.23, RESET.B3 (N.O._2), RST_RELAY.2
SC: ACCUMULATOR.21, IR_CONTROL.9
SU: ALU.18, IR_CONTROL.17
SWITCHVCC: ACCUMULATOR.19, IR.19, MAR.12, MBR.19, RST_RELAY.1
VCC: ALU.19, CLOCK.1, IO.19, MEMORY.19, OR_GATE.14 (VCC), POWER.1, PROGRAM_COUNTER.19, RESET.A1 (N.C._1), RESET.B2 (COM_2), RST_RELAY.5

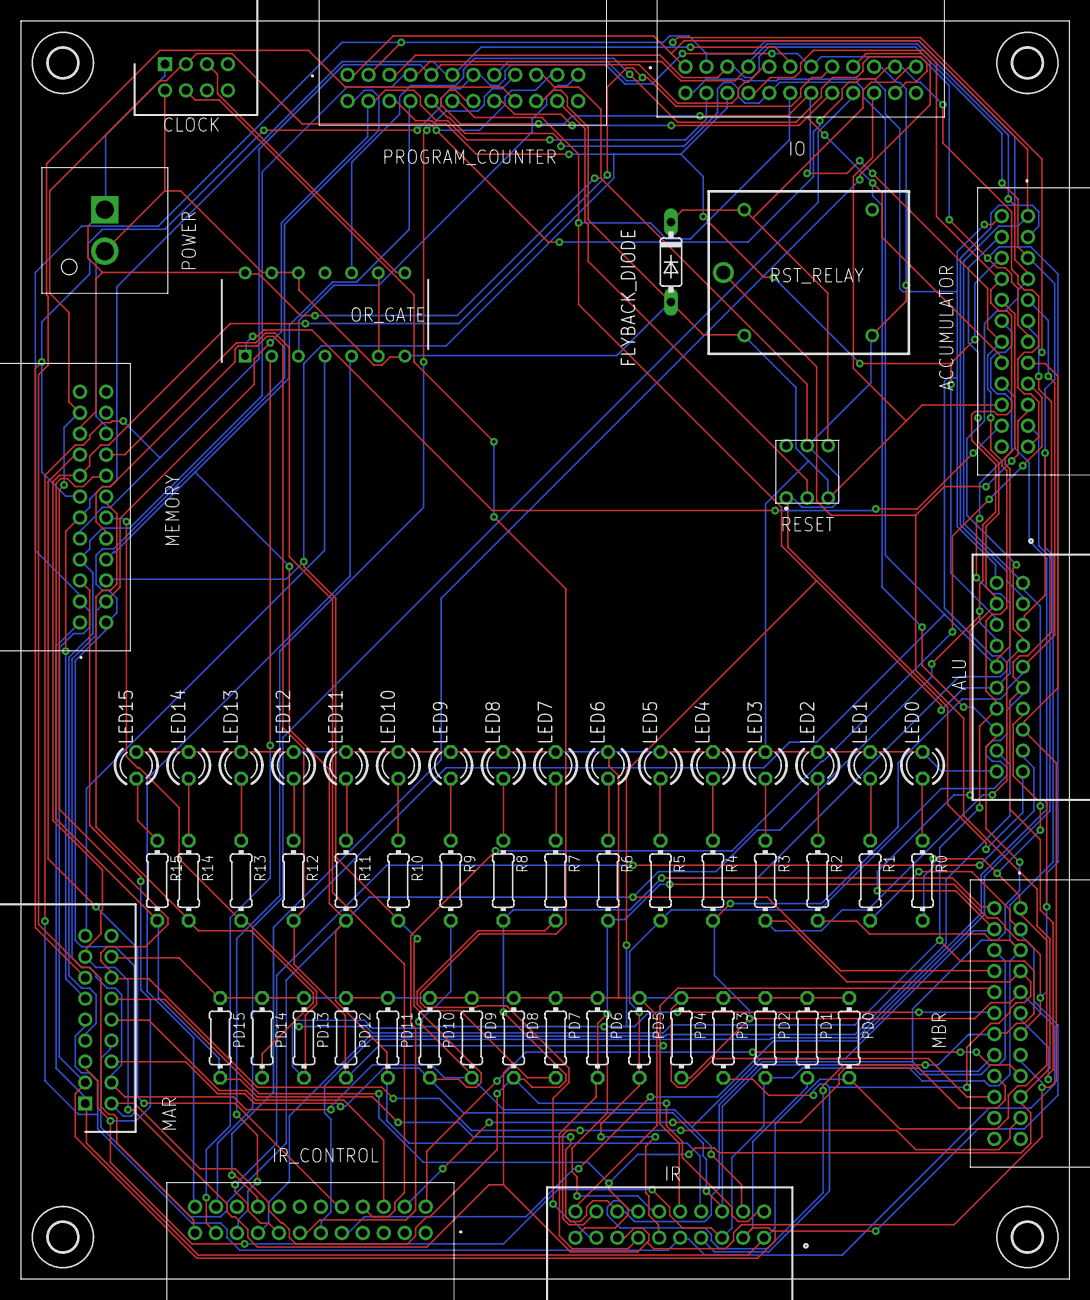
[picture p15: board BUS.brd from above]

Board: 2 copper layers, 100.0 x 120.0 mm, 67 parts (0 on the bottom side), 61 nets.

Other parts of the board:
U$1, U$2, U$3, U$4: 2,8
