richardb1998/MARIEPC/Eagle/ALU/ALU.brd

## EAGLE design Eagle/ALU/ALU.brd (2020-02-25)

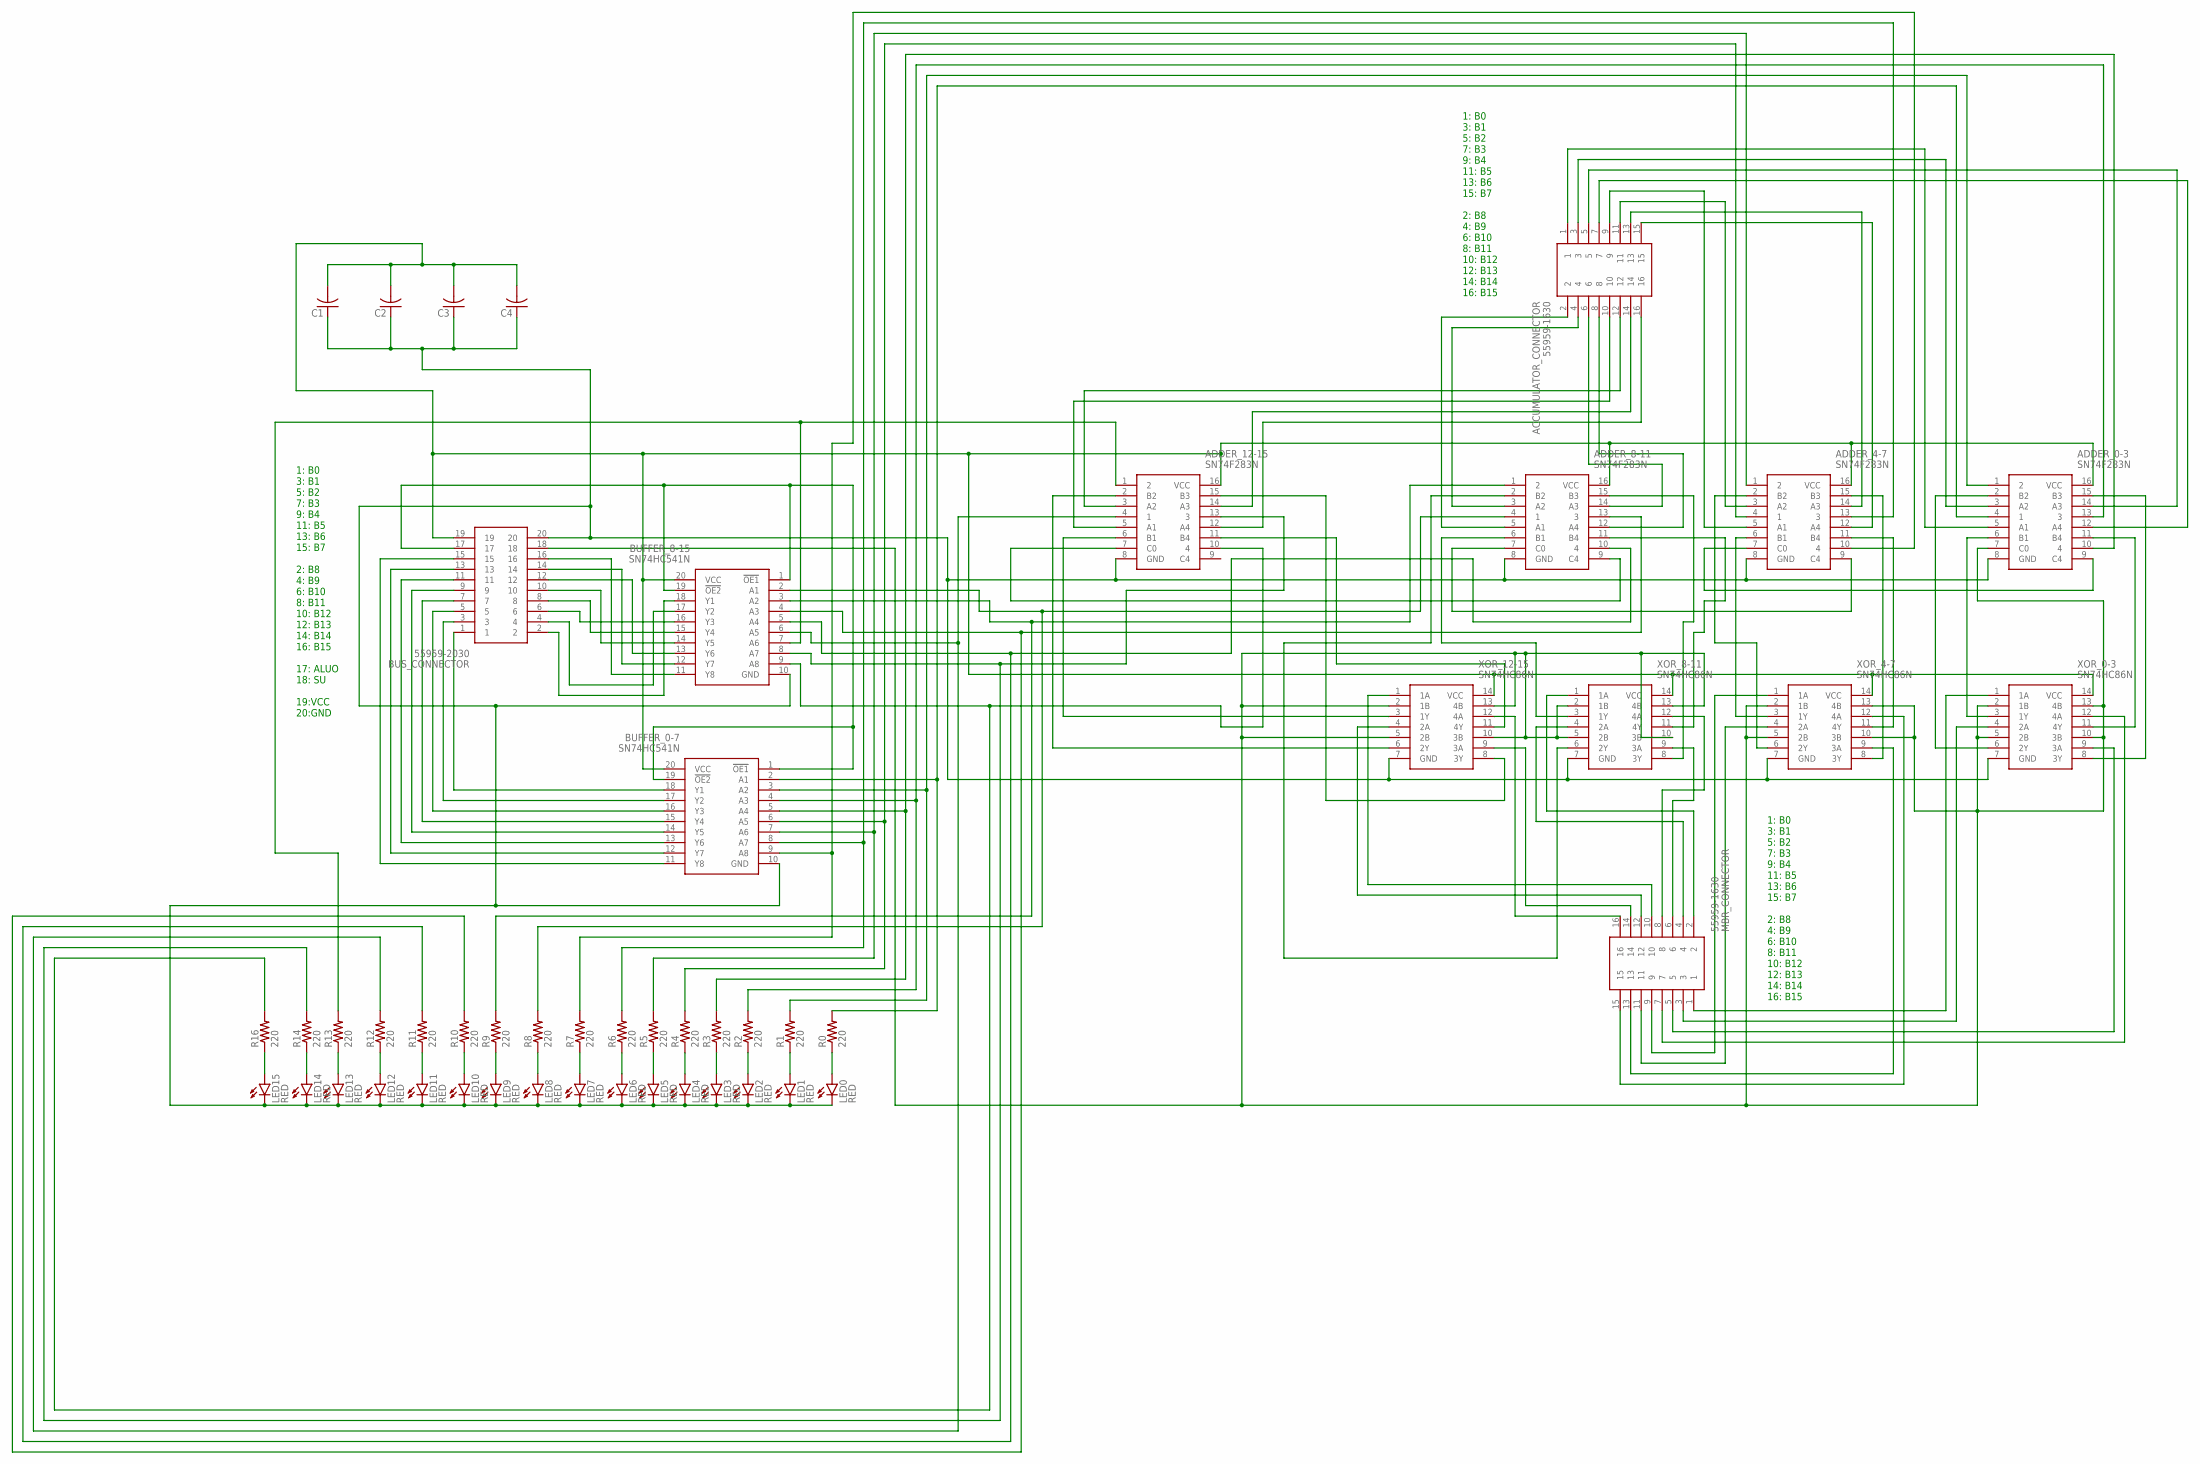
[picture p16: schematic ALU.sch]

Parts:
ACCUMULATOR_CONNECTOR: 55959-1630; SHDR16W65P250X200_2X8_1940X140
ADDER_0-3, ADDER_4-7, ADDER_8-11, ADDER_12-15: SN74F283N; DIP254P762X508-16
BUFFER_0-7, BUFFER_8-15: SN74HC541N; DIP794W53P254L2540H508Q20N
BUS_CONNECTOR: 55959-2030; 55959-2030_1
C1, C2, C3, C4: C-US025-024X044; C025-024X044
LED0, LED1, LED2, LED3, LED4, LED5, LED6, LED7, LED8, LED9, LED10, LED11, LED12, LED13, LED14, LED15: RED; LED3MM
MBR_CONNECTOR: 55959-1630; SHDR16W65P250X200_2X8_1940X140
R0, R1, R2, R3, R4, R5, R6, R7, R8, R9, R10, R11, R12, R13, R14, R16: 220; 0204/7
XOR_0-3, XOR_4-7, XOR_8-11, XOR_12-15: SN74HC86N; DIP794W53P254L1930H508Q14N

Connections:
unnamed: MBR_CONNECTOR.1, XOR_0-3.1 (1A)
unnamed: MBR_CONNECTOR.3, XOR_0-3.4 (2A)
unnamed: MBR_CONNECTOR.5, XOR_0-3.9 (3A)
unnamed: MBR_CONNECTOR.7, XOR_0-3.12 (4A)
unnamed: MBR_CONNECTOR.9, XOR_4-7.1 (1A)
unnamed: MBR_CONNECTOR.11, XOR_4-7.4 (2A)
unnamed: MBR_CONNECTOR.13, XOR_4-7.9 (3A)
unnamed: MBR_CONNECTOR.15, XOR_4-7.12 (4A)
unnamed: ADDER_0-3.6 (B1), XOR_0-3.3 (1Y)
unnamed: ADDER_0-3.2 (B2), XOR_0-3.6 (2Y)
unnamed: ADDER_0-3.15 (B3), XOR_0-3.8 (3Y)
unnamed: ADDER_0-3.11 (B4), XOR_0-3.11 (4Y)
unnamed: MBR_CONNECTOR.16, XOR_12-15.12 (4A)
unnamed: MBR_CONNECTOR.14, XOR_12-15.9 (3A)
unnamed: MBR_CONNECTOR.12, XOR_12-15.4 (2A)
unnamed: MBR_CONNECTOR.10, XOR_12-15.1 (1A)
unnamed: ADDER_4-7.9 (C4), ADDER_8-11.7 (C0)
unnamed: ADDER_8-11.9 (C4), ADDER_12-15.7 (C0)
unnamed: ADDER_0-3.9 (C4), ADDER_4-7.7 (C0)
unnamed: MBR_CONNECTOR.8, XOR_8-11.12 (4A)
unnamed: MBR_CONNECTOR.6, XOR_8-11.9 (3A)
unnamed: MBR_CONNECTOR.4, XOR_8-11.4 (2A)
unnamed: MBR_CONNECTOR.2, XOR_8-11.1 (1A)
unnamed: ADDER_4-7.6 (B1), XOR_4-7.3 (1Y)
unnamed: ADDER_4-7.2 (B2), XOR_4-7.6 (2Y)
unnamed: ADDER_4-7.15 (B3), XOR_4-7.8 (3Y)
unnamed: ADDER_4-7.11 (B4), XOR_4-7.11 (4Y)
unnamed: ACCUMULATOR_CONNECTOR.2, ADDER_8-11.5 (A1)
unnamed: ADDER_8-11.2 (B2), XOR_8-11.6 (2Y)
unnamed: ADDER_8-11.15 (B3), XOR_8-11.8 (3Y)
unnamed: ADDER_8-11.11 (B4), XOR_8-11.11 (4Y)
unnamed: ACCUMULATOR_CONNECTOR.15, ADDER_4-7.12 (A4)
unnamed: ACCUMULATOR_CONNECTOR.13, ADDER_4-7.14 (A3)
unnamed: ACCUMULATOR_CONNECTOR.11, ADDER_4-7.3 (A2)
unnamed: ACCUMULATOR_CONNECTOR.9, ADDER_4-7.5 (A1)
unnamed: ACCUMULATOR_CONNECTOR.7, ADDER_0-3.12 (A4)
unnamed: ACCUMULATOR_CONNECTOR.5, ADDER_0-3.14 (A3)
unnamed: ACCUMULATOR_CONNECTOR.3, ADDER_0-3.3 (A2)
unnamed: ACCUMULATOR_CONNECTOR.1, ADDER_0-3.5 (A1)
unnamed: ADDER_8-11.6 (B1), XOR_8-11.3 (1Y)
unnamed: ACCUMULATOR_CONNECTOR.4, ADDER_8-11.3 (A2)
unnamed: ACCUMULATOR_CONNECTOR.6, ADDER_8-11.14 (A3)
unnamed: ACCUMULATOR_CONNECTOR.8, ADDER_8-11.12 (A4)
unnamed: ACCUMULATOR_CONNECTOR.10, ADDER_12-15.5 (A1)
unnamed: ACCUMULATOR_CONNECTOR.12, ADDER_12-15.3 (A2)
unnamed: ACCUMULATOR_CONNECTOR.14, ADDER_12-15.14 (A3)
unnamed: ACCUMULATOR_CONNECTOR.16, ADDER_12-15.12 (A4)
unnamed: ADDER_12-15.2 (B2), XOR_12-15.6 (2Y)
unnamed: ADDER_12-15.6 (B1), XOR_12-15.3 (1Y)
unnamed: ADDER_12-15.15 (B3), XOR_12-15.8 (3Y)
unnamed: ADDER_12-15.11 (B4), XOR_12-15.11 (4Y)
unnamed: ADDER_0-3.8 (GND), ADDER_4-7.8 (GND), ADDER_8-11.8 (GND), ADDER_12-15.8 (GND), BUFFER_0-7.10 (GND), BUFFER_8-15.10 (GND), BUS_CONNECTOR.20, C1.1, C2.1, C3.1, C4.1, LED0.K (C), LED1.K (C), LED2.K (C), LED3.K (C), LED4.K (C), LED5.K (C), LED6.K (C), LED7.K (C), LED8.K (C), LED9.K (C), LED10.K (C), LED11.K (C), LED12.K (C), LED13.K (C), LED14.K (C), LED15.K (C), XOR_0-3.7 (GND), XOR_4-7.7 (GND), XOR_8-11.7 (GND), XOR_12-15.7 (GND)
unnamed: BUFFER_0-7.18 (Y1), BUS_CONNECTOR.1
unnamed: ADDER_0-3.16 (VCC), ADDER_4-7.16 (VCC), ADDER_8-11.16 (VCC), ADDER_12-15.16 (VCC), BUFFER_0-7.20 (VCC), BUFFER_8-15.20 (VCC), BUS_CONNECTOR.19, C1.2, C2.2, C3.2, C4.2, XOR_0-3.14 (VCC), XOR_4-7.14 (VCC), XOR_8-11.14 (VCC), XOR_12-15.14 (VCC)
unnamed: BUFFER_0-7.17 (Y2), BUS_CONNECTOR.3
unnamed: BUFFER_0-7.16 (Y3), BUS_CONNECTOR.5
unnamed: BUFFER_0-7.15 (Y4), BUS_CONNECTOR.7
unnamed: BUFFER_0-7.14 (Y5), BUS_CONNECTOR.9
unnamed: BUFFER_0-7.13 (Y6), BUS_CONNECTOR.11
unnamed: BUFFER_0-7.12 (Y7), BUS_CONNECTOR.13
unnamed: BUFFER_0-7.11 (Y8), BUS_CONNECTOR.15
unnamed: BUFFER_8-15.15 (Y4), BUS_CONNECTOR.8
unnamed: BUFFER_8-15.16 (Y3), BUS_CONNECTOR.6
unnamed: BUFFER_8-15.11 (Y8), BUS_CONNECTOR.16
unnamed: BUFFER_8-15.12 (Y7), BUS_CONNECTOR.14
unnamed: BUFFER_8-15.13 (Y6), BUS_CONNECTOR.12
unnamed: BUFFER_8-15.14 (Y5), BUS_CONNECTOR.10
unnamed: BUFFER_8-15.17 (Y2), BUS_CONNECTOR.4
unnamed: BUFFER_8-15.18 (Y1), BUS_CONNECTOR.2
unnamed: BUFFER_0-7.1 (!OE1), BUFFER_0-7.19 (!OE2), BUFFER_8-15.1 (!OE1), BUFFER_8-15.19 (!OE2), BUS_CONNECTOR.17
unnamed: ADDER_0-3.4 (1), BUFFER_0-7.2 (A1), R0.2
unnamed: ADDER_0-3.7 (C0), BUS_CONNECTOR.18, XOR_0-3.2 (1B), XOR_0-3.5 (2B), XOR_0-3.10 (3B), XOR_0-3.13 (4B), XOR_4-7.2 (1B), XOR_4-7.5 (2B), XOR_4-7.10 (3B), XOR_4-7.13 (4B), XOR_8-11.2 (1B), XOR_8-11.5 (2B), XOR_8-11.10 (3B), XOR_8-11.13 (4B), XOR_12-15.2 (1B), XOR_12-15.5 (2B), XOR_12-15.10 (3B), XOR_12-15.13 (4B)
unnamed: ADDER_0-3.1 (2), BUFFER_0-7.3 (A2), R1.2
unnamed: ADDER_0-3.13 (3), BUFFER_0-7.4 (A3), R2.2
unnamed: ADDER_0-3.10 (4), BUFFER_0-7.5 (A4), R3.2
unnamed: ADDER_4-7.4 (1), BUFFER_0-7.6 (A5), R4.2
unnamed: ADDER_4-7.1 (2), BUFFER_0-7.7 (A6), R5.2
unnamed: ADDER_4-7.13 (3), BUFFER_0-7.8 (A7), R6.2
unnamed: ADDER_4-7.10 (4), BUFFER_0-7.9 (A8), R7.2
unnamed: ADDER_8-11.4 (1), BUFFER_8-15.2 (A1), R8.2
unnamed: ADDER_8-11.1 (2), BUFFER_8-15.3 (A2), R9.2
unnamed: ADDER_8-11.13 (3), BUFFER_8-15.4 (A3), R10.2
unnamed: ADDER_8-11.10 (4), BUFFER_8-15.5 (A4), R11.2
unnamed: ADDER_12-15.4 (1), BUFFER_8-15.6 (A5), R12.2
unnamed: ADDER_12-15.1 (2), BUFFER_8-15.7 (A6), R13.2
unnamed: ADDER_12-15.10 (4), BUFFER_8-15.9 (A8), R16.2
unnamed: LED15.A, R16.1
unnamed: ADDER_12-15.13 (3), BUFFER_8-15.8 (A7), R14.2
unnamed: LED14.A, R14.1
unnamed: LED13.A, R13.1
unnamed: LED12.A, R12.1
unnamed: LED11.A, R11.1
unnamed: LED10.A, R10.1
unnamed: LED9.A, R9.1
unnamed: LED8.A, R8.1
unnamed: LED7.A, R7.1
unnamed: LED6.A, R6.1
unnamed: LED5.A, R5.1
unnamed: LED4.A, R4.1
unnamed: LED3.A, R3.1
unnamed: LED2.A, R2.1
unnamed: LED1.A, R1.1
unnamed: LED0.A, R0.1

Notes on the sheet:
1: B0 3: B1 5: B2 7: B3 9: B4 11: B5 13: B6 15: B7 2: B8 4: B9 6: B10 8: B11 10: B12 12: B13 14: B14 16: B15 17: ALUO 18: SU 19:VCC 20:GND
1: B0 3: B1 5: B2 7: B3 9: B4 11: B5 13: B6 15: B7 2: B8 4: B9 6: B10 8: B11 10: B12 12: B13 14: B14 16: B15

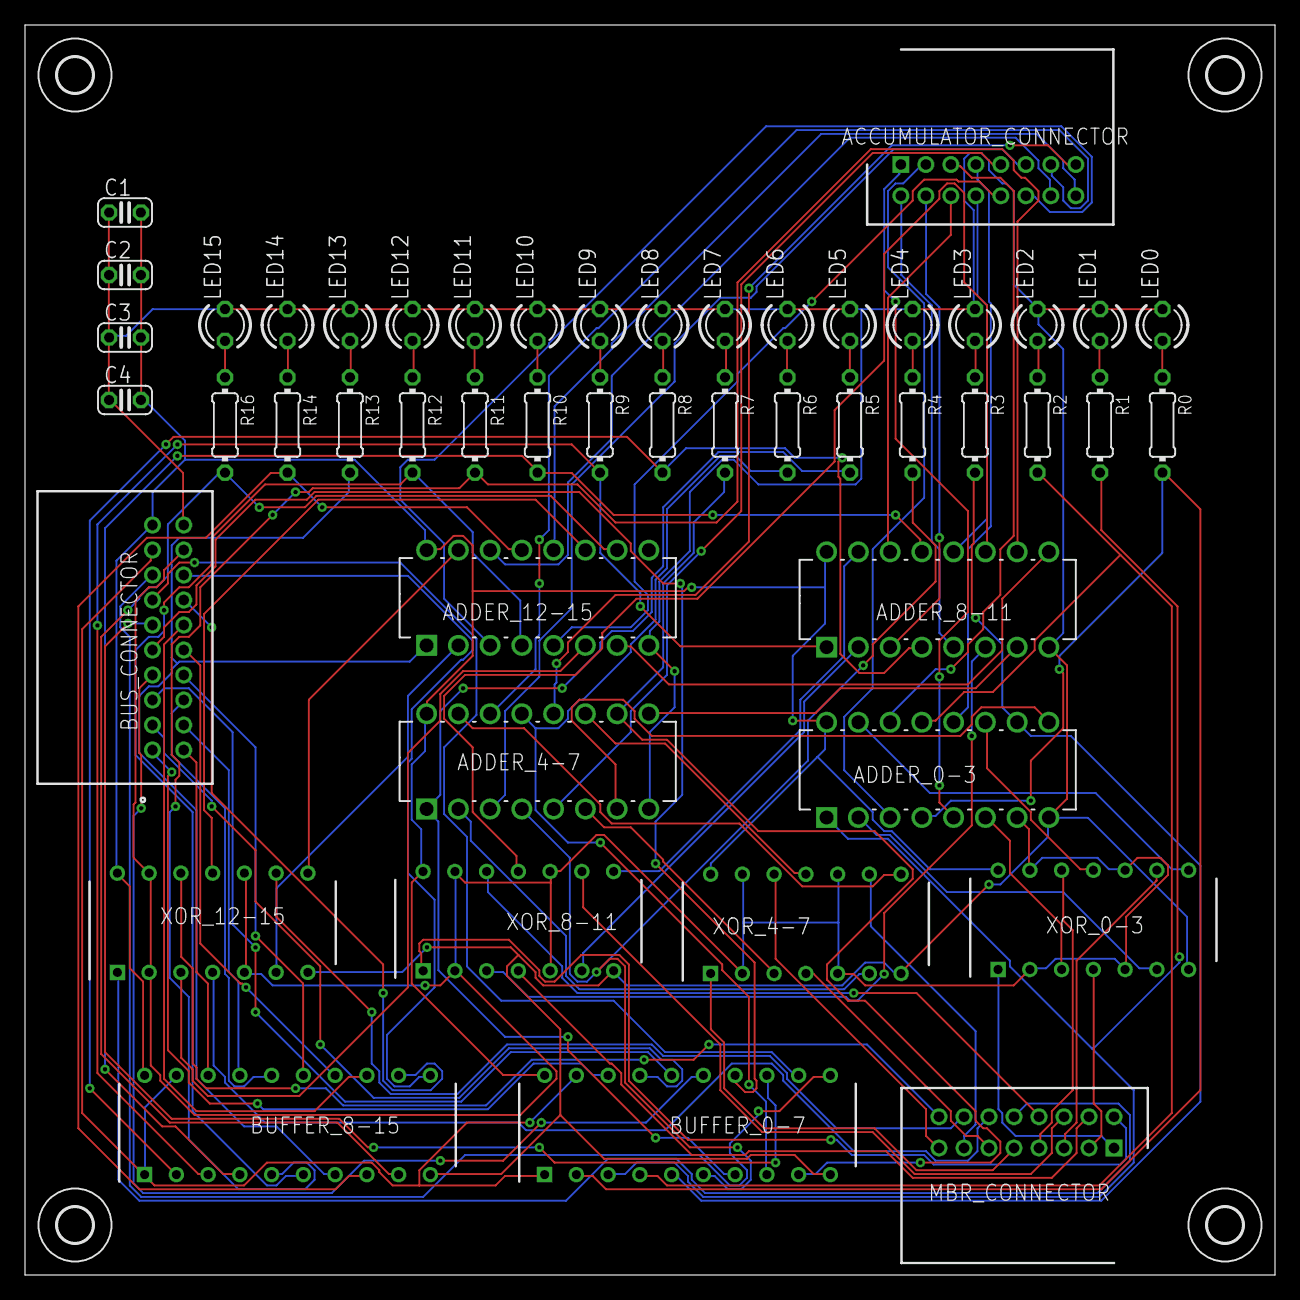
[picture p17: board ALU.brd from above]

Board: 2 copper layers, 100.0 x 100.0 mm, 53 parts (0 on the bottom side), 103 nets.

Other parts of the board:
U$1, U$2, U$3, U$4: 2,8
