richardb1998/MARIEPC/Eagle/MBR/MBR.brd

## EAGLE design Eagle/MBR/MBR.brd (2020-02-25)

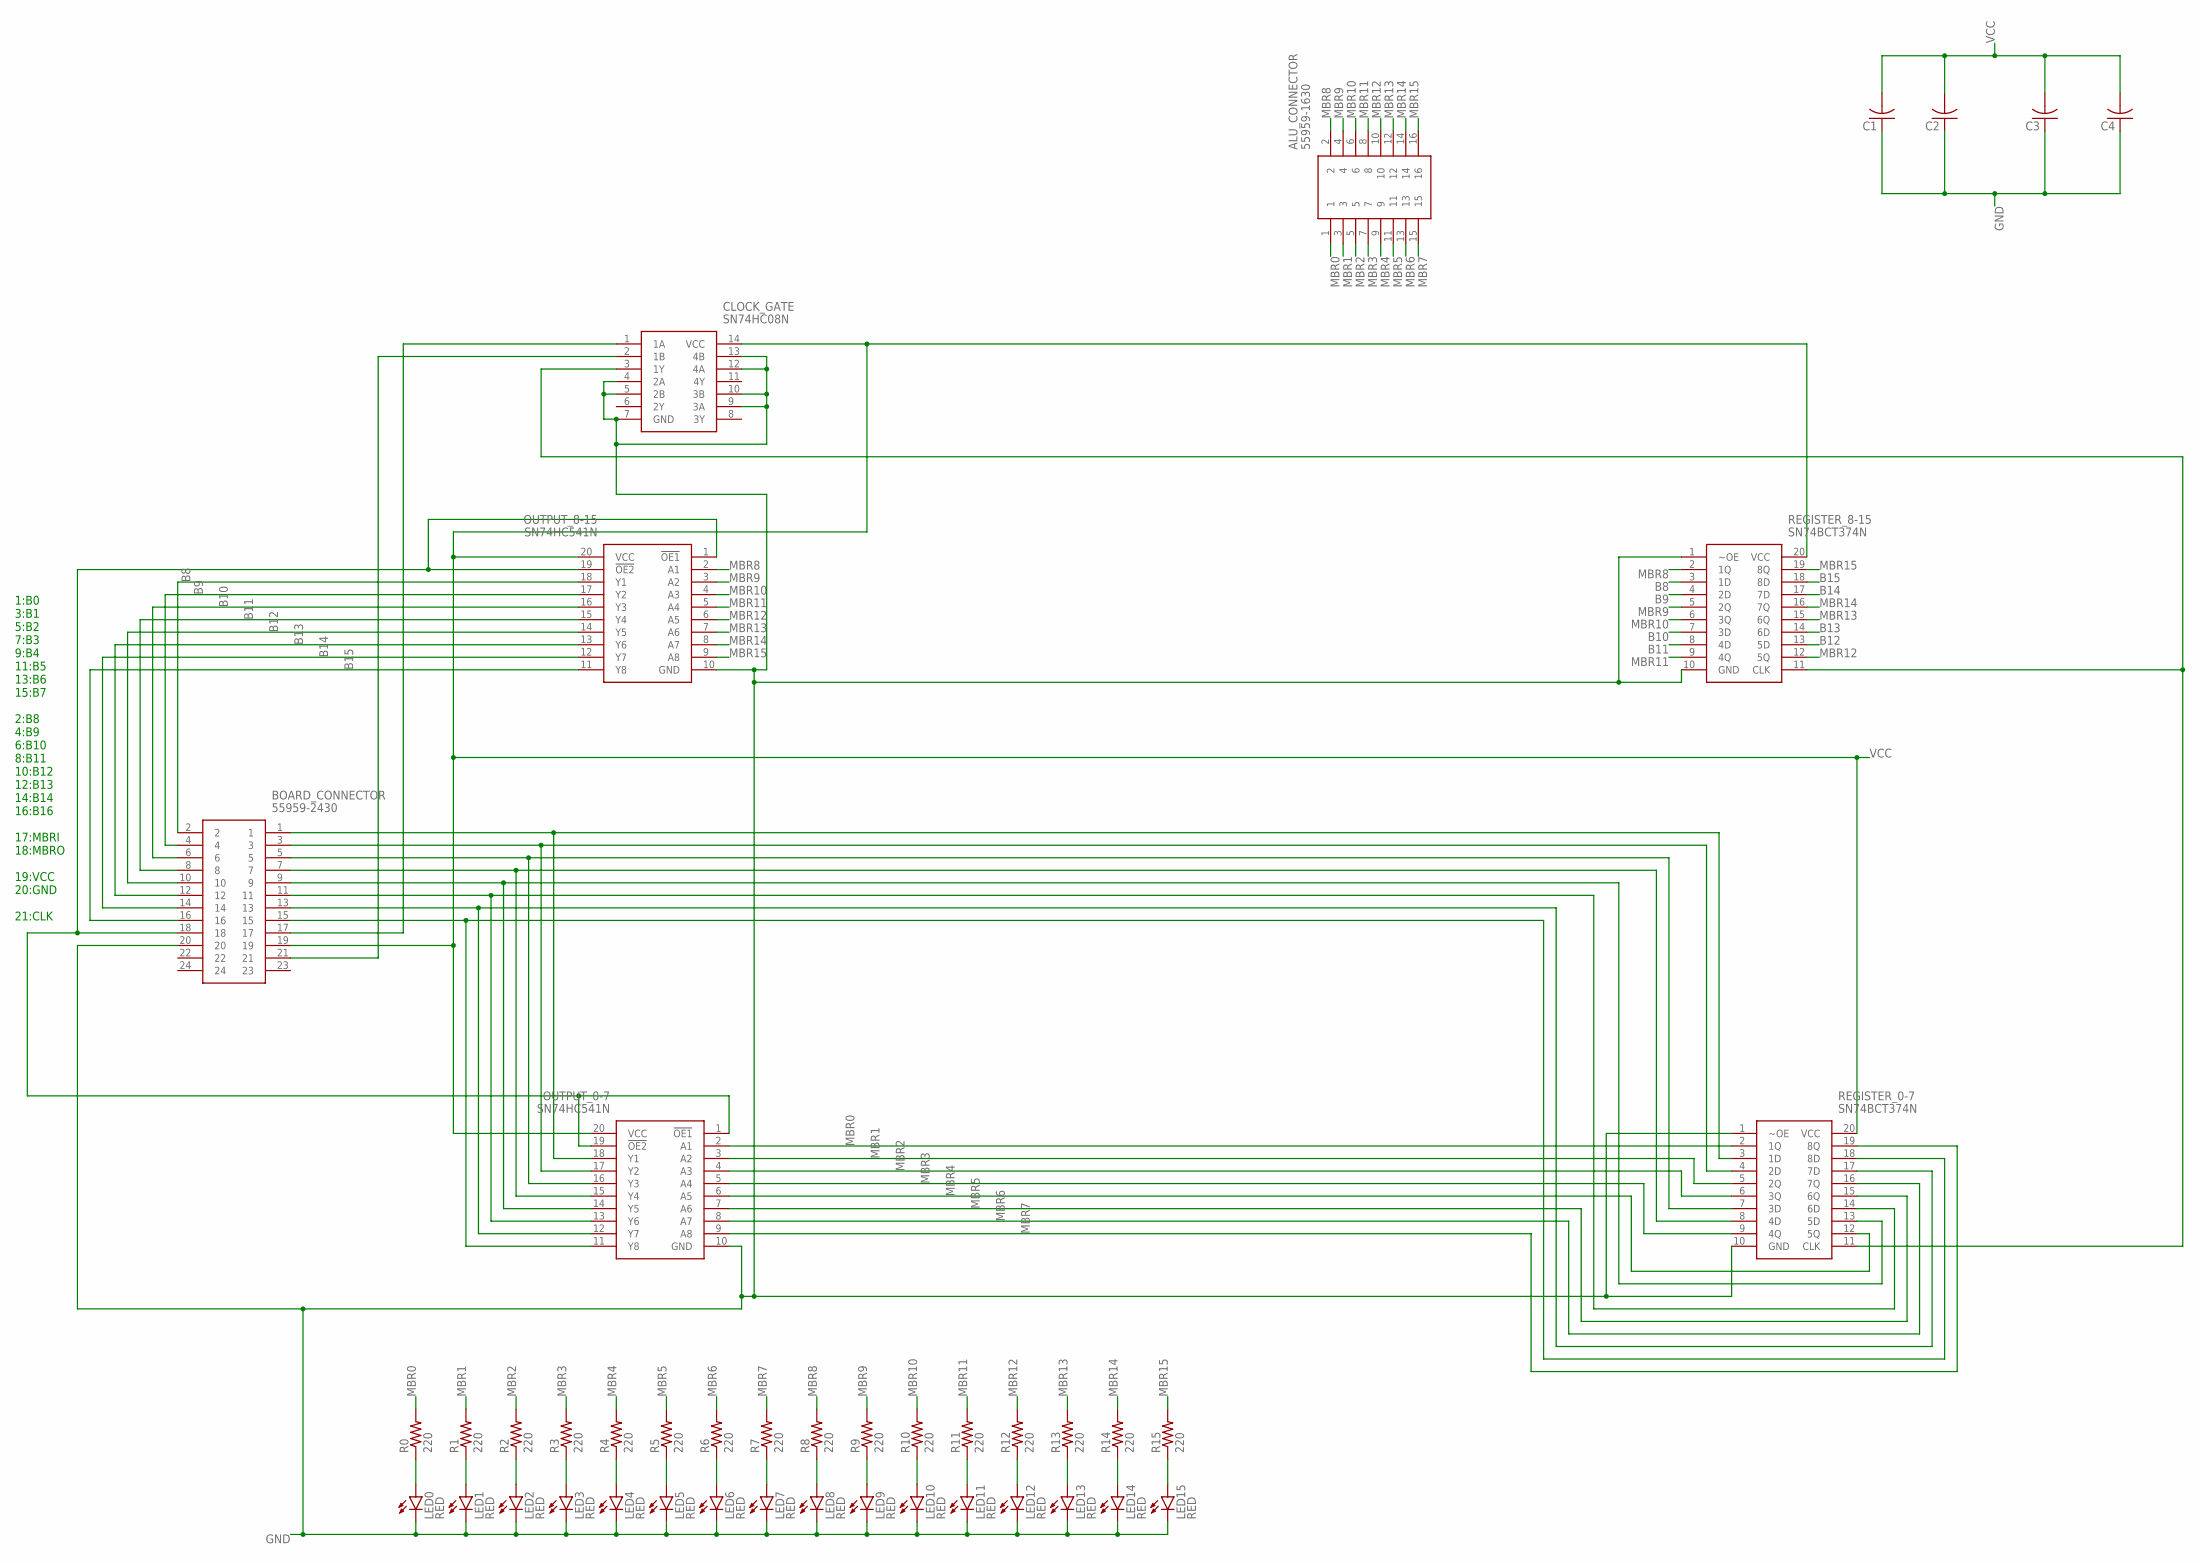
[picture p18: schematic MBR.sch]

Parts:
ALU_CONNECTOR: 55959-1630; SHDR16W65P250X200_2X8_1940X140
BOARD_CONNECTOR: 55959-2430; 559592430
C1, C2, C3, C4: C-US025-024X044; C025-024X044
CLOCK_GATE: SN74HC08N; DIP794W53P254L1930H508Q14N
LED0, LED1, LED2, LED3, LED4, LED5, LED6, LED7, LED8, LED9, LED10, LED11, LED12, LED13, LED14, LED15: RED; LED3MM
OUTPUT_0-7, OUTPUT_8-15: SN74HC541N; DIP794W53P254L2540H508Q20N
R0, R1, R2, R3, R4, R5, R6, R7, R8, R9, R10, R11, R12, R13, R14, R15: 220; 0204/7
REGISTER_0-7, REGISTER_8-15: SN74BCT374N; DIP254P762X508-20

Connections:
B8: BOARD_CONNECTOR.2, OUTPUT_8-15.18 (Y1), REGISTER_8-15.3 (1D)
B9: BOARD_CONNECTOR.4, OUTPUT_8-15.17 (Y2), REGISTER_8-15.4 (2D)
B10: BOARD_CONNECTOR.6, OUTPUT_8-15.16 (Y3), REGISTER_8-15.7 (3D)
B11: BOARD_CONNECTOR.8, OUTPUT_8-15.15 (Y4), REGISTER_8-15.8 (4D)
B12: BOARD_CONNECTOR.10, OUTPUT_8-15.14 (Y5), REGISTER_8-15.13 (5D)
B13: BOARD_CONNECTOR.12, OUTPUT_8-15.13 (Y6), REGISTER_8-15.14 (6D)
B14: BOARD_CONNECTOR.14, OUTPUT_8-15.12 (Y7), REGISTER_8-15.17 (7D)
B15: BOARD_CONNECTOR.16, OUTPUT_8-15.11 (Y8), REGISTER_8-15.18 (8D)
GND: BOARD_CONNECTOR.20, C1.1, C2.1, C3.1, C4.1, CLOCK_GATE.4 (2A), CLOCK_GATE.5 (2B), CLOCK_GATE.7 (GND), CLOCK_GATE.9 (3A), CLOCK_GATE.10 (3B), CLOCK_GATE.12 (4A), CLOCK_GATE.13 (4B), LED0.K (C), LED1.K (C), LED2.K (C), LED3.K (C), LED4.K (C), LED5.K (C), LED6.K (C), LED7.K (C), LED8.K (C), LED9.K (C), LED10.K (C), LED11.K (C), LED12.K (C), LED13.K (C), LED14.K (C), LED15.K (C), OUTPUT_0-7.10 (GND), OUTPUT_8-15.10 (GND), REGISTER_0-7.1 (~OE), REGISTER_0-7.10 (GND), REGISTER_8-15.1 (~OE), REGISTER_8-15.10 (GND)
MBR0: ALU_CONNECTOR.1, OUTPUT_0-7.2 (A1), R0.2, REGISTER_0-7.2 (1Q)
MBR1: ALU_CONNECTOR.3, OUTPUT_0-7.3 (A2), R1.2, REGISTER_0-7.5 (2Q)
MBR2: ALU_CONNECTOR.5, OUTPUT_0-7.4 (A3), R2.2, REGISTER_0-7.6 (3Q)
MBR3: ALU_CONNECTOR.7, OUTPUT_0-7.5 (A4), R3.2, REGISTER_0-7.9 (4Q)
MBR4: ALU_CONNECTOR.9, OUTPUT_0-7.6 (A5), R4.2, REGISTER_0-7.12 (5Q)
MBR5: ALU_CONNECTOR.11, OUTPUT_0-7.7 (A6), R5.2, REGISTER_0-7.15 (6Q)
MBR6: ALU_CONNECTOR.13, OUTPUT_0-7.8 (A7), R6.2, REGISTER_0-7.16 (7Q)
MBR7: ALU_CONNECTOR.15, OUTPUT_0-7.9 (A8), R7.2, REGISTER_0-7.19 (8Q)
MBR8: ALU_CONNECTOR.2, OUTPUT_8-15.2 (A1), R8.2, REGISTER_8-15.2 (1Q)
MBR9: ALU_CONNECTOR.4, OUTPUT_8-15.3 (A2), R9.2, REGISTER_8-15.5 (2Q)
MBR10: ALU_CONNECTOR.6, OUTPUT_8-15.4 (A3), R10.2, REGISTER_8-15.6 (3Q)
MBR11: ALU_CONNECTOR.8, OUTPUT_8-15.5 (A4), R11.2, REGISTER_8-15.9 (4Q)
MBR12: ALU_CONNECTOR.10, OUTPUT_8-15.6 (A5), R12.2, REGISTER_8-15.12 (5Q)
MBR13: ALU_CONNECTOR.12, OUTPUT_8-15.7 (A6), R13.2, REGISTER_8-15.15 (6Q)
MBR14: ALU_CONNECTOR.14, OUTPUT_8-15.8 (A7), R14.2, REGISTER_8-15.16 (7Q)
MBR15: ALU_CONNECTOR.16, OUTPUT_8-15.9 (A8), R15.2, REGISTER_8-15.19 (8Q)
unnamed: BOARD_CONNECTOR.15, OUTPUT_0-7.11 (Y8), REGISTER_0-7.18 (8D)
unnamed: BOARD_CONNECTOR.13, OUTPUT_0-7.12 (Y7), REGISTER_0-7.17 (7D)
unnamed: BOARD_CONNECTOR.11, OUTPUT_0-7.13 (Y6), REGISTER_0-7.14 (6D)
unnamed: BOARD_CONNECTOR.9, OUTPUT_0-7.14 (Y5), REGISTER_0-7.13 (5D)
unnamed: BOARD_CONNECTOR.7, OUTPUT_0-7.15 (Y4), REGISTER_0-7.8 (4D)
unnamed: BOARD_CONNECTOR.5, OUTPUT_0-7.16 (Y3), REGISTER_0-7.7 (3D)
unnamed: BOARD_CONNECTOR.3, OUTPUT_0-7.17 (Y2), REGISTER_0-7.4 (2D)
unnamed: BOARD_CONNECTOR.1, OUTPUT_0-7.18 (Y1), REGISTER_0-7.3 (1D)
unnamed: LED0.A, R0.1
unnamed: LED1.A, R1.1
unnamed: LED2.A, R2.1
unnamed: LED3.A, R3.1
unnamed: LED4.A, R4.1
unnamed: LED5.A, R5.1
unnamed: LED6.A, R6.1
unnamed: LED7.A, R7.1
unnamed: BOARD_CONNECTOR.18, OUTPUT_0-7.1 (!OE1), OUTPUT_0-7.19 (!OE2), OUTPUT_8-15.1 (!OE1), OUTPUT_8-15.19 (!OE2)
unnamed: CLOCK_GATE.3 (1Y), REGISTER_0-7.11 (CLK), REGISTER_8-15.11 (CLK)
unnamed: LED8.A, R8.1
unnamed: BOARD_CONNECTOR.17, CLOCK_GATE.1 (1A)
unnamed: BOARD_CONNECTOR.21, CLOCK_GATE.2 (1B)
unnamed: LED9.A, R9.1
unnamed: LED10.A, R10.1
unnamed: LED11.A, R11.1
unnamed: LED12.A, R12.1
unnamed: LED13.A, R13.1
unnamed: LED14.A, R14.1
unnamed: LED15.A, R15.1
VCC: BOARD_CONNECTOR.19, C1.2, C2.2, C3.2, C4.2, CLOCK_GATE.14 (VCC), OUTPUT_0-7.20 (VCC), OUTPUT_8-15.20 (VCC), REGISTER_0-7.20 (VCC), REGISTER_8-15.20 (VCC)

Notes on the sheet:
1:B0 3:B1 5:B2 7:B3 9:B4 11:B5 13:B6 15:B7 2:B8 4:B9 6:B10 8:B11 10:B12 12:B13 14:B14 16:B16 17:MBRI 18:MBRO 19:VCC 20:GND 21:CLK
