richardb1998/MARIEPC/Eagle/MBR/MBR.brd

## EAGLE design Eagle/MBR/MBR.brd (continued)

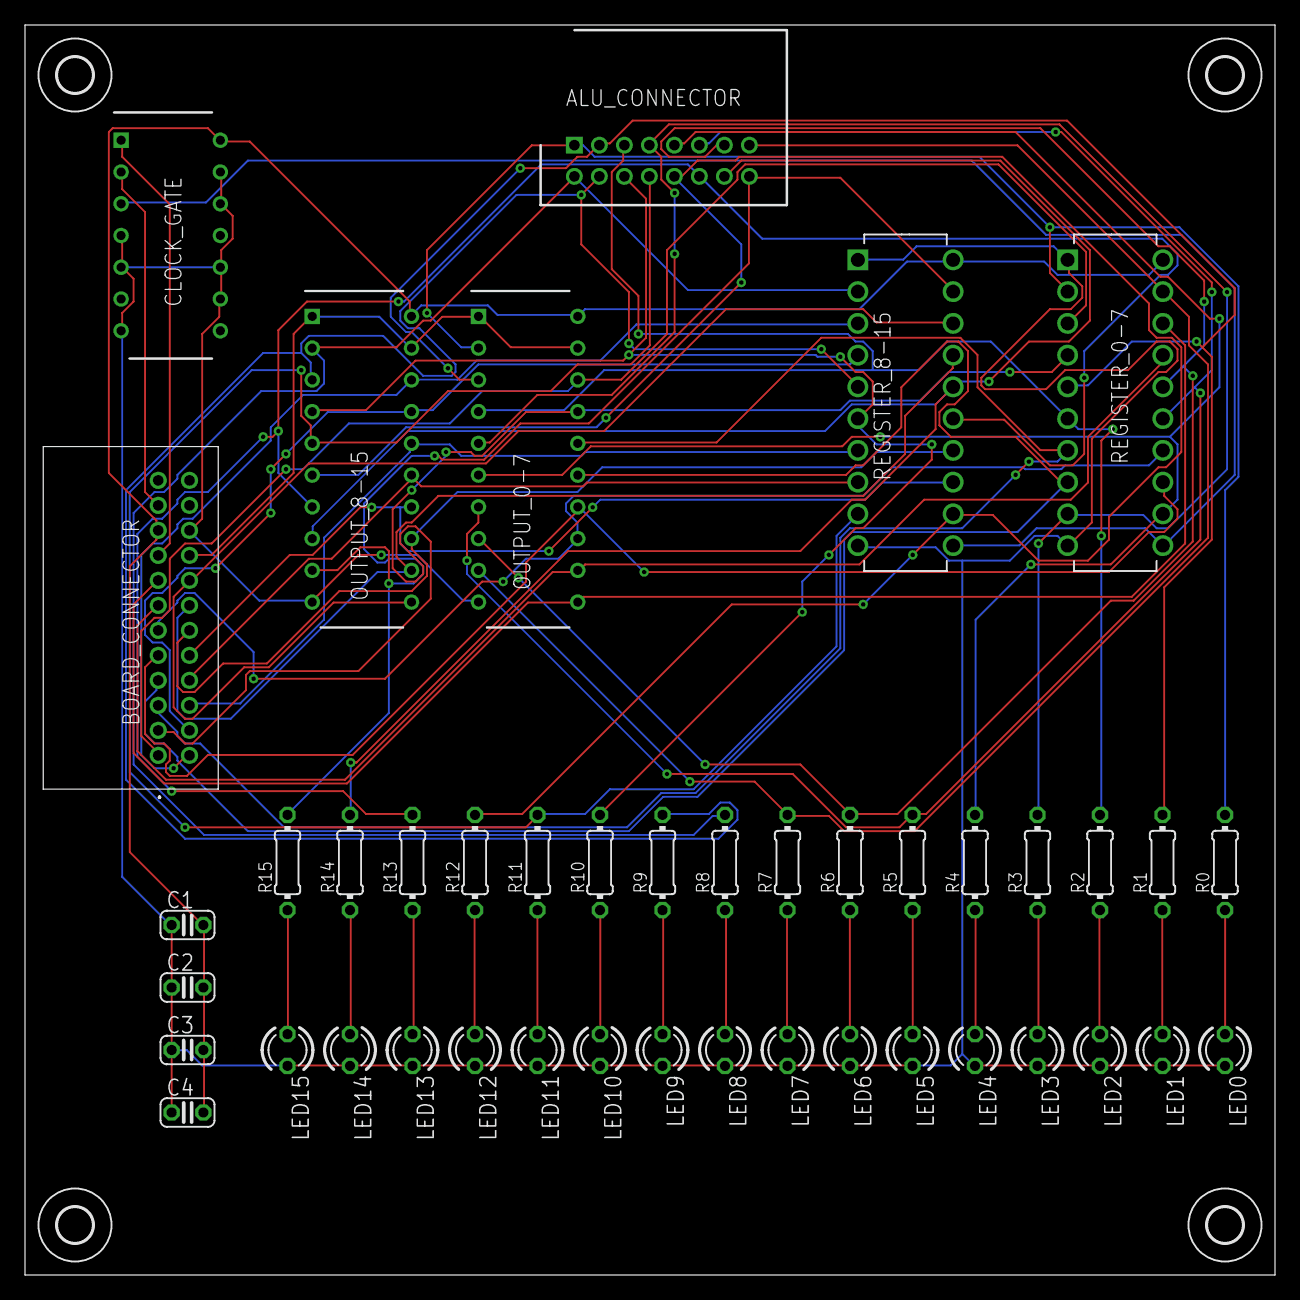
[picture p19: board MBR.brd from above]

Board: 2 copper layers, 100.0 x 100.0 mm, 47 parts (0 on the bottom side), 54 nets.

Other parts of the board:
U$1, U$2, U$3, U$4: 2,8
