richardb1998/MARIEPC/(commit log)

2019-09-27 finished implementing Program Counter
    [Program Counter.brd, Program Counter.sch]
2020-01-22 added logisim
    [marie.circ]
2020-01-22 Added ALU schematic in Eagle
    [ALU.brd, ALU.sch]
2020-01-25 Added MBR
    [MBR.brd, MBR.sch]
2020-01-27 started implementation of Program Counter
    [Program Counter.sch]
2020-02-03 started working on Memory
    [ALU.brd, ALU.sch, MBR.brd, MBR.sch, Program Counter.brd, Program Counter.sch, memory.sch]
2020-02-05 almost finished memory
    [MAR.sch, memory.brd, memory.sch]
2020-02-10 fixed skipcond logic in logisim and added more registers to MARIE
    [ACCUMULATOR.brd, ACCUMULATOR.sch, MAR.sch, marie.circ]
2020-02-15 worked on accumulator
    [ACCUMULATOR.brd, ACCUMULATOR.sch]
2020-02-17 Added input to logisim and worked on IR
    [ACCUMULATOR.brd, IR.brd, IR.sch, marie.circ]
2020-02-19 Worked on IR
    [IR.sch, MAR.sch, Program Counter.sch]
2020-02-19 added parts needed to finish boards
    [IR.brd, IR.sch, MAR.sch, memory.brd, memory.sch]
2020-02-19 Finished IR
    [IR.brd, IR.sch, MAR.sch]
2020-02-19 added HLT to MAR for prgm mode
    [MAR.brd, MAR.sch]
2020-02-21 finished most boards
    [ACCUMULATOR.brd, ACCUMULATOR.sch, ALU.brd, ALU.sch, IR.brd, IR.sch, MAR.brd, MAR.sch]
2020-02-24 added Clock
    [ACCUMULATOR.brd, ACCUMULATOR.sch, BUS.brd, BUS.sch, IR.brd, IR.sch, MAR.brd, MAR.sch]
2020-02-25 added BUS
    [BUS.brd, BUS.sch]
2020-02-25 added pull down resistors and reset circuit to BUS
    [BUS.brd, BUS.sch]
2020-02-25 added flyback diode
    [BUS.brd, BUS.sch]
2020-02-25 added gerber files for each board
    [ACCUMULATOR.brd, ALU.brd, BUS.brd, IR.brd, MAR.brd, MAR.sch, MBR.brd, Program Counter.brd]
2020-02-25 added power connector
    [BUS.brd, BUS.sch]
2020-02-25 added gerber files for ordering boards
    [BUS.brd, IR.brd, IR.sch, MAR.brd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]
2020-06-12 started adding revision 2 to fix errors in first set of boards
    [ACCUMULATOR.brd, ACCUMULATOR.csv, ACCUMULATOR.sch, ALU.csv, BUS.csv, IR.csv, MAR.csv, MBR.csv]
2020-06-26 updated schematics
